amarendas/PhdThesis/Chapter4/ModelingAGV.tex

\chapter{Dynamics of Wheeled Mobile Robots }
\label{c4_Dynamics}
In the field of mobile robotics, extensive research has been carried out. 
Mobile robots can broadly be divided into three categorises, namely wheeled robots, legged robots ~\cite{machado2006overview}, and aerial vehicles ~\cite{valavanis2014handbook}. 
There are few mobile robots which use both wheels and legs for locomotion. For example,  Creadapt  \cite{mouret2015evolutionary} in order to take advantage of both modes of locomotion. 
Among these, the most extensively studied are the  Wheeled Mobile Robots (WMR). 
They have been classified into five generic classes by Champion et. al. \cite{campion1996structural},~\cite{campion2008wheeled}  based on their mobility resulting from the kinematic constrains due to  different wheel types.
 The most common among these are the  3 wheeled differentially driven WMR with one castor wheel.
  Because of its simplicity in modelling, they have been used in most of the  control and motion planing algorithms  \cite{desantis1995modeling}, \cite{koh1999smooth} and \cite{d1995control}. 

In order to develop a model-based control algorithm, it is imperative to have a good dynamic model of the WMR.
 These dynamic models are used in  simulation software,  Software in Loop (SIL) testing and Hardware in Loop (HIL) testing  of the controllers.
 Different methods have  been adopted to derive the dynamic model of WMRs.
  A general dynamical model was derived for three-wheel mobile robots with nonholonomic constraints  by B. d'Andrea-Novel \cite{d1991modelling} using  Lagrange formulation.
    Alternatively, Thanjavur and Rajagopalan \cite{thanjavur1997ease} have used Kane's method,  and  Saha et al. \cite{saha1991dynamics},\cite{saha1989kinematics} used Natural Orthogonal Compliment (NOC) method for the same.  
    
In this chapter we first present the kinematic model of the mobile robot with two passive wheel at the front. It is then proved using kinematics why a passive wheel with caster offset along the plane of the wheel self orients itself. While  casters with zero offset  must be actuated.  This has not been explicitly presented in literature.

 Next the dynamic equation of a mobile robot using Natural Orthogonal Compliment method is derived for both for ideal rolling condition of wheels and in presence of longitudinal and lateral slip of wheels. Use of NOC for modeling differential drive wheeled vehicle under ideal rolling condition has been presented by Angels and Saha \cite{saha1991dynamics}, \cite{saha1989kinematics}. We extend this method to include both the lateral and longitudinal slip of the wheels, and  derive the dynamic equations of motion of a mobile robot with redundant actuators. 
 
 The RARS robot has a unique  drive configuration, which uses both differential drive and Davis mechanism for steering. 
 This system has a redundant configuration and very few literature presents dynamical analysis with slip included in the dynamics. To our knowledge no literature is present, where the concept of  NOC  has been used to model redundantly actuated mobile robot. The two models are compared using simulation to find the deviation in the path traced by RARS robot under different peak value of co-efficient of friction between the wheel and ground plane.

\section{Modeling using the Natural Orthogonal Compliment (NOC)}
Let us consider a system with $n$ rigid bodies interconnected with different types of joints. 
Let, $f_i$ be the net force acting at the center of mass (CM) of the $i^{th}$  body and $n_i$ is the net moment.
 If $m_i$ is the mass, $I_{ci}$ is the  moment of inertia with respect to the CM, $c_i$ is the position vector of the CM and $\omega_i$ is the angular velocity of the same body with respect to an inertial coordinate system, then equations of motion of the $i^{th}$ rigid body are given by Newton-Euler equations as 
\begin{equation}
\label{NE}
f_i=m_i\ddot{c_i} \quad \text{and} \quad n_i=I_{ci} \dot \omega_i+\omega_i \times I_{ci} \omega_i
\end{equation}
Let us  define twist ($t$) and wrench($w$) as 
\begin{equation*}
t_i \equiv \begin{pmatrix}
\omega_i\\ \dot{c_i}
\end{pmatrix} \quad
w_i \equiv \begin{pmatrix}
n_i\\f_i
\end{pmatrix}
\end{equation*}
Note that the wrench $w_i$ acting on the $i^{th}$ body can be decomposed into $w^w_i$, called the \textit{working component} and  $w^c_i$, the \textit{non-working component}.
 The working component consists of all the external  moments and forces, which imparts/extracts energy to/from the system, e.g., motor actuating torque.
  The non-working component of the wrench consists of the moments and forces that are used to constrain the motion of the body at the joints.
Then, Newton-Euler equations (\ref{NE}) can be rewritten  in a single matrix equation as 
\begin{equation}
\label{2}
M_i\dot{t_i}+W_iM_it_i=w^w_i+w^c_i \quad \because w_i \equiv w^w_i+w^c_i
\end{equation}
where
\begin{equation}
\label{3}
M_i \equiv \begin{pmatrix}
I_{ci} & 0\\0 & m_i\tilde{1}
\end{pmatrix} ,
\quad W_i\equiv \begin{pmatrix}
\Omega_i &0\\0&0
\end{pmatrix},
\quad
\Omega_i\equiv \omega_i\times \tilde{1}
\end{equation}
in which  $\Omega_i$, is refered as the cross-product matrix of vector $\omega_i$ and $\tilde{1}$ denotes the identity matrix.For details, refer to \cite{angeles2013fundamentals},\cite{saha2010robotics}.If we define 
\[M \equiv diag[M_1,M_2,...M_n], \quad W \equiv diag[W_1,W_2,...W_n], \quad t \equiv [t_1^T,t_2^T, ....t_n^T]^T\] 
and 
\[ w^j \equiv [{w_1^j}^T,{w_2^j}^T, ....{w_n^j}^T]^T, \,j=c,w \]
then the equations of all the $n$ rigid bodies in the system can be collected and written as a single matrix equation 
\begin{equation}
\label{DCE}
M\dot{t}+WMt=w^c+w^w
\end{equation}
 The above equation is referred to as  decoupled equations of motion of the system.

The kinematic constraints, both holonomic and non-holonomic (e.g., pure rolling), between two bodies $i$ and $j$ of a system can be expressed as a linear homogeneous system of algebraic equations \cite{angeles2013fundamentals}, namely 
\begin{equation}
A_it_i+A_jt_j=0
\end{equation}
where $A_i,A_j$ depend on the kinematic parameters.

The constraint equations corresponding to all the joints in the system can be written in terms of the \textit{generalized twist vector} $t$.
\[At=0\]
 Furthermore, if $ \dot{\theta} \equiv[\dot{\theta_1},\dot{\theta_2},...\dot\theta_n]^T$ denote the \textit{independent generalized joint rates}. One can then write $t$ in terms of $\dot{\theta}$ as $t=T\dot{\theta}$. 
Using the fact, that $\dot{\theta}$ can take any arbitrary value, we get
\begin{equation}
\label{AT}
 AT\dot{\theta}=0\quad \Rightarrow AT=0
\end{equation}
The Equation \ref{AT} indicates that $T$ is the orthogonal complement of $A$.
 Since this relation arises naturally, hence the name \textit{Natural Orthogonal Complement}.  It can be shown \cite{angeles2013fundamentals} that the non-working wrench $w^c$ lies in the range space of $A^T$.   In view of Equation \ref{AT}, it can be proved that $w^c$ lies in the null space of $T^T$. Therefore,
\begin{equation}
T^Tw^c=0
\end{equation}
To eliminate the non-working  moments and  forces, i.e., $w^c$ from the uncoupled equation of motion (\ref{DCE}), we multiply both sides of the equation  by $T^T$. The result is dynamic equations of motion for interconnected n-body system.
\[T^TM\dot{t}+T^TWMt=T^Tw^W\]
 Substituting,  $t=T\dot{\theta}$ and $\dot{t}=\dot{T}\dot{\theta}+T\ddot{\theta}$  in  the above equation we get
\begin{equation}
 T^TMT\ddot{\theta}+T^T(M\dot{T}+WMT)\dot{\theta}=T^Tw^w
 \label{eqn:CEM}
\end{equation}
% This equation is expressed in terms of the independent generalized joint rates $\dot{\theta}$ and  $\ddot{\theta}$.
 or,
\begin{equation}
\label{CE}
 \quad I(\theta)\ddot{\theta}+C(\theta,\dot{\theta})\dot{\theta}=\tau
\end{equation}
where
\begin{align*}
I(\theta) &\equiv T^TMT\quad \quad:\text{generalized inertia matrix}\\
C(\theta,\dot{\theta})&\equiv T^T(M\dot{T}+WMT) \quad :\text{generalized  convective inertia matrix}\\
\tau&\equiv T^Tw^w \quad \quad :\text{ generalized vector of driving forces }
\end{align*}

Using the fact that $M$ and $W$ are diagonal matrices,  $I(\theta)$, $C(\theta,\dot{\theta}) $ and $\tau$ in Equation \ref{CE} can be written in terms individual bodies $M_i$, $W_i$ and $w_i^c$ as
\begin{equation}
	I(\theta)=\sum_{i=1..n}(T_i^TM_iT_i)
\end{equation}
\begin{equation}
C(\theta,\dot{\theta})=\sum_{i=1..n}(T_i^T M_i\dot{T_i}+T_i W_i M_i T_i)
\end{equation}
\begin{equation}
\tau=\sum_{i=1..n}T_i^T w^w_i
\end{equation}

\begin{figure}
	\begin{minipage}[t]{0.5\textwidth}
	\centering
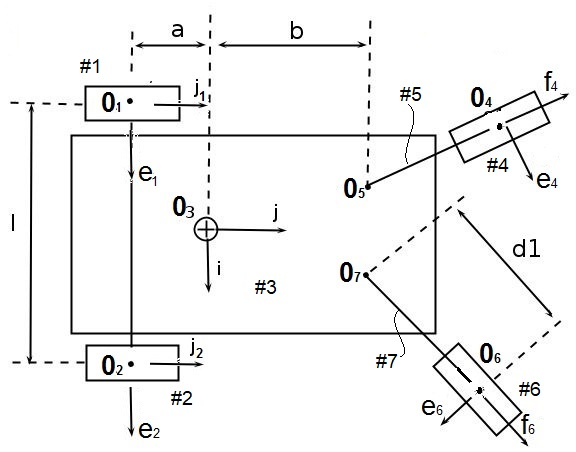
[picture p11: Chapter4/fig/fig1.jpg]
		 
		\caption{WMR-Std. caster}\label{fig:std}
	\end{minipage}
	\hfill
	\begin{minipage}[t]{0.5\textwidth}
	\centering
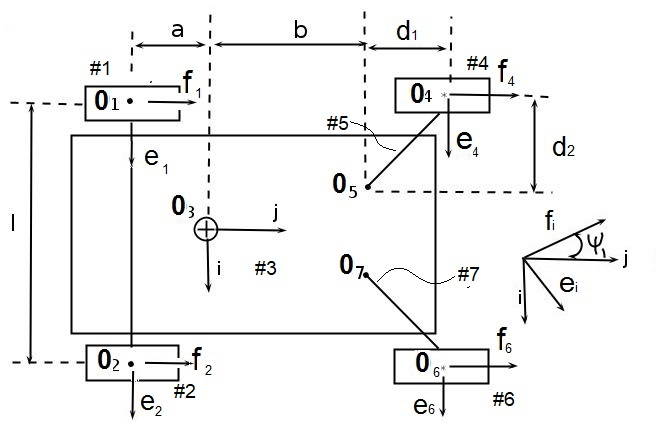
[picture p12: Chapter4/fig/fig2.jpg]
		 
		\caption{WMR-general}\label{fig:gen}
			\end{minipage}
%\caption{Castor wheel configuration of a WMR}
\end{figure}

\section{Dynamic Equation of WMR}
\label{sec:DynamicNoSlip}
The dynamic equation of a differentially driven 3 wheeled mobile robot based on the  Natural Orthogonal Compliment (NOC) has been presented by Saha~\cite{saha1991dynamics}. The vehicle consisted of 2 driven wheels and one standard caster wheel. In general, for large vehicles, it is necessary to have at least four wheels from the point of stability of the vehicle. Such a vehicle  is shown in Figure \ref{fig:std}. It may be noted that the caster wheels used in this case are the standard caster, where the angle between line $O_4O_5$ and vector $e_4$ is  $90^o$. Which is a special case of the more general configuration of the passive wheels shown in figure \ref{fig:gen}, where angle between line $O_4O_5$ and vector $e_4$ is not $90^o$

 The vehicle considered for analysis in this chapter is shown in Figure \ref{fig:gen}. It consists of two independently driven wheels at the back and two passive wheels at the front. The actuated wheels are labelled as body \#1 and \#2 as indicated in Figure \ref{fig:gen}. The platform is body \#3. The first caster wheel and its bracket is labelled as \#4 and \#5 respectively, with the castor pivoted at $O_5$. Similarly, the second castor is pivoted at $O_7$, and its bracket and wheel are labelled as \#6 an \#7, respectively, all the wheels are assumed to be rolling without slipping.  
 
 The RARS robot wheel configuration can be arrived from the generalized configuration of caster wheels presented above when $d_1=0$. Under this condition  and assuming that the steering mechanism always provides the correct steer angle, which is true in case of small curvature paths, the dynamic behaviour of the proposed robot will be similar to that  shown Figure  \ref{fig:gen}.
\subsection{Kinematic analysis}
In order to proceed with the kinematic analysis of the vehicle in Figure \ref{fig:gen}, we define an orthogonal triad of vectors ${i,j,k}$ at point $O_3$, the control point of the platform, as shown in Figure \ref{fig:gen}. If $\dot{\theta_1}$ and $\dot{\theta_2}$ {( positive when pointing along $i$)} denote the rates of rotation of wheels \#1 and \#2 then the linear velocity of points $O_1$ and $O_2$ under pure rolling condition is given by 
\begin{equation}
\label{velO1}
{\dot{o_i}}=-r\dot{\theta_i}j, \quad \text{r=radius of wheel}
\end{equation}
The angular velocity, $\omega_3$ of the platform  can be written in terms of the linear velocity of its two points $O_1$ and $O_2$  as 
\begin{equation}
\label{omegaPlat}
{\omega_3}=(r/l)(\dot{\theta_1}-\dot{\theta_2}){k}
\end{equation}
Further, the velocity of point $O_3$ can be written as
${\dot{o_3}=\dot{o_i}+\omega_3 \times (c-o_i)}, \quad i=1,2$, where $o_3 $ and $o_i$  is the position vector of points $O_3$ and $O_i$ respectively, with respect to some  point fixed to the ground. Eliminating $\omega_3$  one gets the following:

\begin{equation}
\label{velPlat}
 \quad \quad \dot{o_3}={(a r/l)(-\dot{\theta_1}+\dot{\theta_2})}i -(r/2)( \dot{\theta_1}+ \dot{\theta_2})j
\end{equation}
Now, the angular velocity of the drive wheel \#1 can be expressed as ${\omega_1}=-\dot{\theta_1}i+\omega_3k$. Using Equation \ref{omegaPlat}, the same can be rewritten as 

\begin{equation}
\label{omegaWheel1}
{\omega_1}=\begin{pmatrix}
-i+(r/l)k & -(r/l)k
\end{pmatrix}
\begin{pmatrix}
\dot{\theta_1}\\\dot{\theta_2}
\end{pmatrix}
\end{equation}
Similarly for the second wheel (\#2) we get
\begin{equation}
\label{omegaWheel2}
{\omega_1}=\begin{pmatrix}
(r/l)k & i-(r/l)k
\end{pmatrix}
\begin{pmatrix}
\dot{\theta_1}\\\dot{\theta_2}
\end{pmatrix}
\end{equation}
Based on  Equations \ref{velO1} and \ref{omegaWheel1}, the twist for wheel \#1 in terms of $\dot{\theta_a}\equiv (\dot{\theta_1},\dot{\theta_2})^T$, can be written as 
\begin{equation}
\label{twist1}
t_1=\begin{pmatrix}
\omega_1\\\dot{o_1}
\end{pmatrix}=
\begin{pmatrix}
i+(r/l)k & -(r/l)k\\- rj & 0
\end{pmatrix}
\begin{pmatrix}
\dot{\theta_1}\\\dot{\theta_2}
\end{pmatrix}
\end{equation}

Similarly, for the other actuated wheel \#2, one gets

\begin{equation}
\label{twist2}
t_2=\begin{pmatrix}
\omega_2\\\dot{o_2}
\end{pmatrix}=
		\begin{pmatrix}
		(r/l)k & i-(r/l)k\\
		  0 & -rj
		\end{pmatrix}
		\begin{pmatrix}
		\dot{\theta_1}\\\dot{\theta_2}
		\end{pmatrix}\\
		\end{equation}

To calculate the twist, $t_3$ of the platform body \#3, Equations \ref{omegaPlat} and \ref{velPlat} are combined to get
\begin{equation}
\label{twist3}
t_3=\begin{pmatrix}
\omega_3\\\dot{o_3}
\end{pmatrix}=
\begin{pmatrix}
\rho\delta & -\rho\delta\\
r(\lambda i+(1/2)j) & r(-\lambda i+(1/2)j)
\end{pmatrix}
\begin{pmatrix}
\dot{\theta_1}\\\dot{\theta_2}
\end{pmatrix}
\end{equation}
where
\[ \delta\equiv d/l, \quad \rho \equiv r/d, \quad \lambda \equiv a/l \]
From the above three equations, one gets 
\[T_1=\begin{pmatrix}i+(r/l)k & -(r/l)k\\ -rj & 0\end{pmatrix}, \quad  
T_2=\begin{pmatrix}	(r/l)k & i-(r/l)k\\  0 & -rj \end{pmatrix}\],
\[T_3=\begin{pmatrix}
	\rho\delta & -\rho\delta\\
	r(\lambda i+(1/2))j & r(-\lambda i+(1/2))j
	\end{pmatrix}\]

In order to calculate the twists of the caster bracket and the caster wheel, it is necessary to express the  un-actuated joint rates, $\dot{\psi_1}$ and $\dot{\phi_1}$, in terms of the actuated joint rate vector $\dot{\theta_a}$. Note here that $\dot{\psi_1}$ denotes the rate of rotation of the bracket body (\#5) about $O_5$ with respect to the platform, and $\dot{\phi_1}$ is the rate of rotation of caster wheel body (\#4) about its axis $e_4$ with respect to the bracket.
\begin{equation*}
\omega_5=\dot{\psi_1}k+\omega_3, \quad \quad \omega_4=\dot{\phi_1} e_4 +\omega_5
\end{equation*}
Assuming that there is pure rolling constraint between the wheel and the ground, the velocity of the point $O_4$ can be written in terms of $\phi_1$ as \[\dot{\phi_1} r = \dot{o_4} \]

 The velocity of $O_5$ can now be expressed in two independent forms, namely, one in terms of the velocity of $O_3$ and the other one in terms of the velocity of $O_4$, i.e.,
\begin{equation}
\dot{o_5}=\dot{o_4}+\omega_5\times(d_2e_4-d_1f_4), \quad
\dot{o_5}=\dot{o_3}+\omega_3\times(b j - m i)
\end{equation}
On equating the above two equations together, and using the rotation matrix (R) between coordinate system $\{i,j,k\}$ and $\{e_4,f_4,k\}$ given Equation \ref{eqn:RotMatrix}, 

\begin{equation}
\label{eqn:RotMatrix}
R=\begin{pmatrix}
\cos(\psi_1) & -\sin(\psi_1) \\
\sin(\psi_1) & \cos(\psi_1)
\end{pmatrix}
\end{equation}
 the equation in terms $e_4$ and $f_4$, is obtained as

\begin{equation}
(-\dot{\phi_1}r+\dot{\psi_1}d_1)f_3+d_3\dot{\psi_1}e_3=\dot{o_3}
+\omega_3(m\cos\psi_1-b\sin\psi_1-d_1)e_4
\end{equation} 
Taking the dot product of the above equation first with $e_4$ and then with $f_4$, and using Equation \ref{velPlat} for $\dot{o_3}$, one gets
\begin{eqnarray}
\label{unac2act1}
\begin{pmatrix}
d_2&0\\-d_1 &r
\end{pmatrix}
\begin{pmatrix}
\dot{\psi_1}\\ \dot{\phi_1}
\end{pmatrix}
&=&\begin{pmatrix}
(-ar/l)S_{\psi_1}+(r/2)C_{\psi_1}+\delta_1 & 
(ar/l)S_{\psi_1}+(r/2)C_{\psi_1}-\delta_1 \\
(ar/l)C_{\psi_1}+(r/2)S_{\psi_1}+\delta_2 & 
(-ar/l)C_{\psi_1}+(r/2)S_{\psi_1}-\delta_2 
\end{pmatrix}\dot{\theta_a}\nonumber \\
&=&[F_{ij}]\dot{\theta_a}
\end{eqnarray}
where, 
\[ \delta_1=(r/l)(mC_{\psi_1}-bS_{\psi_1}-d2), \quad  \delta_2=(r/l)(mS_{\psi_1}+bC_{\psi_1}+d_1) \]

Similarly, for the other caster wheel one gets,
\begin{align}
\label{unac2act2}
\begin{pmatrix}
d_2&0\\-d_1 &r
\end{pmatrix}
\begin{pmatrix}
\dot{\psi_2}\\ \dot{\phi_2}
\end{pmatrix}
&=\begin{pmatrix}
(-ar/l)S_{\psi_2}+(r/2)C_{\psi_2}-\delta_3 & 
(ar/l)S_{\psi_2}+(r/2)C_{\psi_2}+\delta_3 \\
(ar/l)C_{\psi_2}+(r/2)S_{\psi_2}+\delta_4 & 
(-ar/l)C_{\psi_2}+(r/2)S_{\psi_2}-\delta_4 
\end{pmatrix}\dot{\theta_a}\nonumber \\
&=[G_{ij}]\dot{\theta_a}
\end{align}
where, 
\[ \delta_3=(r/l)(mC_{\psi_2}+bS_{\psi_2}+d2), \quad  \delta_4=(r/l)(mS_{\psi_2}+bC_{\psi_2}+d1 )\]

 The angular and the linear velocity of the CM of the caster wheel  \#4, is  written in terms of the co-ordinate frame fixed to the bracket \#5, i.e. $\{e_4,f_4,k\}$, as
\begin{equation}
\label{omegacastor1}
\omega_4=\dot{\phi_1}e_4+(\omega_3+\dot{\psi_1})k, \quad
\dot{o_4}=\dot{\phi_1}e_4
\end{equation}
Using Equations \ref{unac2act1} and \ref{omegaPlat}, the twist $t_4$ can be written as
\begin{equation}
\label{twist4}
t_4=\begin{pmatrix}
\Theta_4\\C_4
\end{pmatrix}\dot{\theta_a}
\end{equation}
Using the definition of $F(i,j)$ in  Equation \ref{unac2act1}, $\Theta_4$ and $C_4$ can be written as 
\[ \Theta_4=[F_{11}e_4+\bar{F_{21}}k \quad F_{12}e_4+\bar{F_{22}}k],\quad 
C_4=r[-F_{11}f_4 \quad -F_{12}f_4]\]
\[\bar{F_{21}}=F_{21}+\rho \delta, \quad \bar{F_{22}}=F_{22}-\rho\delta\]

The angular and the linear velocity of the CM of the caster bracket \#5  expressed in the co-ordinate frame fixed to the bracket is given as
\begin{equation}
\omega_5=\omega_3+\dot{\psi_1}k, \quad
\dot{o_5}=\dot{o_4}+\omega_5\times(d_2e_4-d_1f_4)
\end{equation}
Using Equations   \ref{omegaPlat} and \ref{unac2act2}, the twist $t_5$ can next  be expressed as
\begin{equation}
\label{twist5}
t_5=\begin{pmatrix}
\Theta_5\\C_5
\end{pmatrix}\dot{\theta_a}
\end{equation}
where
\[ \Theta_5 \equiv [\bar{F_{21}}k \quad \bar{F_{22}}k],\quad 
C_5\equiv d[(1/2)\bar{F_{21}}e_4-\rho F_{11}f_4 \quad (1/2)\bar{F_{22}}e_4-\rho F_{12}f_4]\]
In a similar manner, the twists $t_6$ and $t_7$  of the other caster wheel and its bracket, respectively can be written as 
\begin{equation}
\label{twist6}
t_6=\begin{pmatrix}
\Theta_6\\C_6
\end{pmatrix}\dot{\theta_a}, \quad t_7=\begin{pmatrix}
\Theta_7\\C_7
\end{pmatrix}\dot{\theta_a}
\end{equation}
Using  $G(i,j)$ defined in  Equation \ref{unac2act2}, $\Theta_6$, $C_6, \Theta_7$ and $C_7$ are given by
\[ \Theta_6 \equiv [G_{11}e_6+\bar{G_{21}}k \quad G_{12}e_6+\bar{G_{22}}k],\quad 
C_6 \equiv r[-G_{11}f_6 \quad -G_{12}f_6]\]
\[ \Theta_7 \equiv [\bar{G_{21}}k \quad \bar{G_{22}}k],\quad 
C_7 \equiv d[(1/2)\bar{G_{21}}e_6-\rho G_{11}f_6 \quad (1/2)\bar{G_{22}}e_6-\rho G_{12}f_6]\]
\[\bar{G_{21}} \equiv G_{21}+\rho \delta, \quad \bar{G_{22}}\equiv G_{22}-\rho\delta\] 
\subsection{Special cases}
Based on the above kinematic equations \ref{unac2act1} and \ref{unac2act2} for the caster wheels two special cases can be recognized one with $d_1=0$ and another ($d_2=0$). The RARS mobile robot designed fall in the second category and hence it requires a steering actuator as discussed below.  
\subsubsection{Standard caster ($d_1=0$) }
The  standard caster wheel configuration can be obtained by setting the value of $d_1=0$. In such condition, the left hand side matrix of  Equations \ref{unac2act1} and \ref{unac2act2} become  a diagonal matrix. Therefore, the first and second row of Equations \ref{unac2act1} and \ref{unac2act2} get divided by $d_2$ and $r$, respectively. The resulting  equations relating the un-actuated joint rate to  actuated joint rates are similar to those reported by \cite{saha1991dynamics},\cite{angeles2013fundamentals}. These passive wheel are self orienting. Hence there is no need for steering motors. 
\subsubsection{Under-actuated case ($d_2=0$)}
It can be seen from Equation \ref{unac2act1} that when the \textit{caster offset}, $d_2=0$, the LHS matrix becomes singular. So the unactuated joint rates cannot be determined from $\dot{\theta_a}$. It is therefore essential to have proper caster offset in case we need caster like behaviour from a passive wheel. 

An alternative solution is to put an extra actuator to control the bracket motion i.e., $\dot\psi_i$. This is the case in Ackerman and Davis steering mechanism, where the steering wheel controls the orientation of the front passive wheels of a car.
\section{Dynamics with No Wheel Slip }
In this section the equations of motion is derived under the assumption that all the wheel satisfies pure rolling condition, there is no slipping or skidding of the wheels. This is valid for vehicles with caster wheels as mentioned in Section 3.2.2.1 or incase where steered wheels are perfectly aligned according to the Ackerman steering condition. Dynamics of such architecture is simple which will lead to a realistic model of RARS developed in this research. This is effectively the case mentioned in Section 3.2.2.2. 

Based on the twists calculated in terms of the independent joint rate vector vector $\dot{\theta_a}$,  the generalized inertia matrix and the matrix of convective inertia term for the coupled equation of motion given by Equation \ref{CE} can be derived. 
\subsection{Generalized inertia matrix, I}
\label{sec:GIM}
 The equations gives in Section 4.2.1 of the twist of individual body, i.e $t_i=T_i\dot{\theta_a}$ are used to obtain   $t=[t_1^T, t_2^T....t_7^T]^T$ and $t=T\dot\theta$ where  $T=[T_1^T, T_2^T,... T_7^T]^T$. Since the matrix $M$ is block diagonal, the inertia matrix of the full system  denoted by $I$ is given by
\begin{equation}
I=T^TMT=T_1^TM_1T_1+T_2^TM_2T_2+...T_7^TM_7T_7
\end{equation}
The contribution of the rear wheels  to the inertia matrix, i.e., $I_m$ is given by  \[ I_m=\sum_{i=1,2}T_i^TM_iT_i\] or
\begin{equation}
\label{eqn:I_wheel}
I_m=\begin{pmatrix}
I_w+(\rho\delta)^2H++m_wr^2 & -2(\rho\delta)^2H
\\
-2(\rho\delta)^2H &I+(\rho\delta)^2H++m_wr^2
\end{pmatrix} 
\end{equation}
where 
\begin{equation}
\label{eqn:wheelInertiaMatrix}
M_i \equiv\begin{pmatrix}
\tilde{I_w} &0\\0 & m_w\mathbf{1}
\end{pmatrix} , \quad\tilde{I_w}\equiv\begin{pmatrix}
I_w&0&0\\0&H&\\0&0&H
\end{pmatrix}
\end{equation} 

Matrix $\tilde{I_w}$ is the $3\times 3$ moment of inertia matrix of the wheel in co-ordinate frame $\{i,j,k\}$, $m_w$ is mass of the motorized wheels    and $\bm{1}$ is the $3\times 3$ identity matrix. If the mass of the platform is $m_p$ and its moment of inertia about vector ${k}$ is $I_p$, then  \cite{angeles2013fundamentals} 
\begin{equation}
\label{eqn:I_platform}
I_3=T^T_3M_3T_3 =I_p(\rho\delta)^2\begin{pmatrix}
1&-1\\-1&1 \end{pmatrix}\\
+m_pr^2\begin{pmatrix}
(1/4)+\gamma^2 & (1/4)-\gamma^2\\(1/4)-\gamma^2 & (1/4)+\gamma^2
\end{pmatrix}
\end{equation}
Similarly, if $m_c$ is the mass of the castor wheel and it is assumed to be a solid disk, then the generalized inertia matrix  can be written as
\begin{align}
I_c=\sum_{i=4,6}T^T_iM_iT_i=(m_cr^2/4)&
\begin{pmatrix}
6F_{11}^2+\bar{F_{21}}^2 & 6F_{11}F_{12}+\bar{F_{21}}\bar{F_{22}}\\
6F_{11}F_{12}+\bar{F_{21}}\bar{F_{22}} & 6F_{12}^2\bar{F_22}
\end{pmatrix}\\ \nonumber
&+\begin{pmatrix}
6G_{11}^2+\bar{G_{21}}^2 & 6G_{11}G_{12}+\bar{G_{21}}\bar{G_{22}}\\
6G_{11}G_{12}+\bar{G_{21}}\bar{G_{22}} & 6G_{12}^2\bar{G_22}
\end{pmatrix}
\end{align}
If the mass of the brackets, i.e., body \#5 and \#7, are small compared to the mass of the caster wheels, then the contributions of $T^T_5M_5T_5$ and $T^T_7M_7T_7$ can be neglected.

\subsection{Matrix of convective inertia term C}
The matrix of convective inertia terms of Equation \ref{CE} can be broken down into two parts, $T^TM\dot{T}$ and $T^TWMT$.  As can be seen from Equations \ref{twist1}, \ref{twist2} and \ref{twist3},  $T_1,T_2,T_3$ associated with rear wheels and the platform is constant. Therefore \[T^TM\dot{T}=0\]
 The generalized inertia matrix  is constant for the rear wheels and the platform, therefore the vector $I_i\omega_i$ is parallel to  $\omega_i, i=1..3$ \[\Rightarrow\omega\times I\omega=0\] \[\Rightarrow T^TWMT =0\]
  This shows that contribution of the rear wheels and the platform  to the convective inertia term is zero. Moreover, the mass of the brackets are assumed to be zero, so they also do not contribute to the convective inertia term. Hence
\begin{equation}
\label{Convective}
C=T^TM\dot{T}+T^TWMT=\sum_{i=4,6}T^T_iM_i\dot{T_i}+\sum_{i=4,6}T_i^TW_iM_iT_i
\end{equation}
The expression for the first term is found by using Equations \ref{unac2act1}, \ref{unac2act2}, \ref{twist4} and \ref{twist6}. The terms $\dot{F_{ij}}$ and $\dot{G_{ij}}$ denote the derivatives of the elements of the matrix $F$ and $G$ defined in Equations \ref{unac2act1} and \ref{unac2act2} . To find $\dot{T_4}$ and  $ \dot{T_6}$ we have used the fact $\dot{e_4}=\omega_4 \times e_4 $ and $\dot{e_4}=\omega_6 \times e_6 $. 
\begin{equation}
\label{corr1}
\begin{split}
T^TM\dot{T}=
(m_cr^2/4)& \biggl[ \begin{pmatrix}
6F_{11}\dot{F_{11}}+\bar{F_{21}}\dot{F_{21}} & 6F_{11}\dot{F_{12}}+\bar{F_{21}}\dot{F_{22}}\\
6\dot{F_{11}}F_{12}+\dot{F_{21}}\bar{F_{22}} & 6F_{12}^2\bar{F_{22}}
\end{pmatrix}\\
&+\begin{pmatrix}
6G_{11}\dot{G_{11}}+\bar{G_{21}}\dot{G_{21}} & 6G_{11}\dot{G_{12}}+\bar{G_{21}}\dot{G_{22}}\\
6\dot{G_{11}}G_{12}+\dot{G_{21}}\bar{G_{22}} & 6G_{12}^2\bar{G_{22}}
\end{pmatrix} \biggr]
\end{split}
\end{equation}
\\
The second term of Equation \ref{Convective} i.e, $ \sum_{i=4,6}T_i^TW_iM_iT_i$ evaluates to zero, as shown below. 

Next, consider passive wheel (\#4), using Equation \ref{twist4} and  $W$ defined in the Equation \ref{3} one gets,
\begin{equation}
\label{corr2}
T^T_4W_4M_4T_4=[\Theta_4, C_4]\begin{pmatrix}
\Omega_4 &0\\0&0
\end{pmatrix}
\begin{pmatrix}
I_4&0\\0 &m_4 \mathbf{1}
\end{pmatrix}
\begin{pmatrix}
\Theta_4\\C_4
\end{pmatrix}=\Theta_4\Omega_4I_4\Theta_4
\end{equation}

To evaluate the above equation, we express  all the terms in the coordinate system $\{{e_4,f_4,k}\}$. Moreover, $\omega_4=\Theta_4 \dot{\theta_a}$, using definition of $\Theta_4$ from Equation \ref{twist4} we get \[\omega_4= (F_{11}\dot{\theta_1}+F_{12}\dot{\theta_2})e_4+(F_{21}\dot{\theta_1}+F_{22}\dot{\theta_2})k\] and the cross product matrix of $\omega_4$ as 
\[
 \Omega_4 \equiv \begin{pmatrix}
 0& -(\bar{F_{21}}\dot{\theta_1}+\bar{F_{22}}\dot{\theta_2}) &0\\
 (\bar{F_{21}}\dot{\theta_1}+\bar{F_{22}}\dot{\theta_2}) & 0 & -(F_{11}\dot{\theta_1}+F_{12}\dot{\theta_2}) \\
 0& (F_{11}\dot{\theta_1}+F_{12}\dot{\theta_2}) &0 
 \end{pmatrix}
\]
When the above expressions are substituted in Equation  \ref{corr2}, we get
\begin{equation}
T^T_4W_4M_4T_4=0, \quad \Rightarrow T^TWMT=0
\end{equation} 
Therefore, the matrix of convective inertia term $C$ of Equation \ref{CE}  evaluates to 

\begin{equation}
\label{C_final}
\begin{split}
C=
(m_cr^2/4)& \biggl[ \begin{pmatrix}
6F_{11}\dot{F_{11}}+\bar{F_{21}}\dot{F_{21}} & 6F_{11}\dot{F_{12}}+\bar{F_{21}}\dot{F_{22}}\\
6\dot{F_{11}}F_{12}+\dot{F_{21}}\bar{F_{22}} & 6F_{12}^2\bar{F_{22}}
\end{pmatrix}\\
&+\begin{pmatrix}
6G_{11}\dot{G_{11}}+\bar{G_{21}}\dot{G_{21}} & 6G_{11}\dot{G_{12}}+\bar{G_{21}}\dot{G_{22}}\\
6\dot{G_{11}}G_{12}+\dot{G_{21}}\bar{G_{22}} & 6G_{12}^2\bar{G_{22}}
\end{pmatrix} \biggr]
\end{split}
\end{equation}

All the components of  Equation  \ref{CE}  are now been evaluated, except the $\tau$. These are simply the torques exerted by the actuated wheels. This completes the dynamic model of the WMR with generalized passive wheel configuration.

\subsection{Simulation }
\label{sec: SimulationIdealCondition}
The mobile manipulator proposed in Chapter 3  was modelled as a differentially driven robot. The front wheels and steering mechanism were not included in the dynamic model as their masses are too small compared to the  platform. The weight of each wheel is 0.3Kg, the steering mechanism 0.24Kg, whereas the weight of the  platform is 70Kg.

In  simulation the vehicle reference  point $O_3$ is required to trace a circle of radius 5m with centre at $O$. As shown in the Figure \ref{fig:CirTrace}. Let, $ \beta$ be the angle between the line joining  point $O_3$ and $O$ with respect to $X-axis$. The function $\beta(t)$ was defined such that the full circle is completed in 60Sec and the velocity and acceleration of the robot is zero at the beginning (t=0) and end of travel (t=60).
\begin{equation}
\label{path}
\beta(t)=\frac{20\pi}{60^3}t^3-\frac{30\pi}{60^4}t^4+\frac{12\pi}{60^5}t^5
\end{equation}
The initial pose of the vehicle is parallel to the $Y-axis$ i.e. $\beta=0$  as shown  by dotted line in Figure \ref{fig:CirTrace}.

\begin{figure}[H]
	\centering
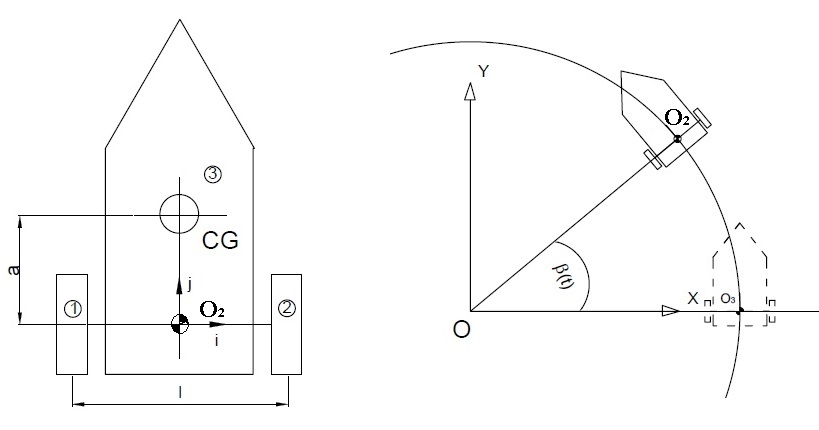
[picture p13: Chapter4/fig/pathCircle2.jpg]
		
		\caption{Path traced by robot}
	\label{fig:CirTrace}
\end{figure}

\subsection{Inverse dynamics}
\label{sec:InvDynamics_NoSlip}
Inverse dynamics was carried out to find the torque required on each rear wheel, when the point $O_2$ of the mobile robot traces a circular 
curve given in Figure \ref{fig:CirTrace}.
Using the model's inverse kinematic,  the wheel velocity and acceleration were determined using pseudo inverse.  % from the equation given below. Where $r$ is radius of the wheel and $\theta_i$ is the wheel roll angle of wheel \#1 and \#2. The platform angular velocity is $\omega$ and the Cartesian velocity of point o3 is given by $\dot{x},\dot{y}$ in body coordinate system %   
The wheel angle, velocity and acceleration were used in the dynamics equation \ref{dnoc}  to calculate the torque required by each motor. The results are plotted in Figure \ref{fig:spiral}. 

The equation of  dynamic model  is given in Equation \ref{dnoc}, where the actuated joints are  $\theta_a(t)=(\theta_l, \theta_r) $, the rear left and right wheel rotation angles. The dynamic  and kinematic  parameters used in the simulation is listed in table \ref{tb:massproperty}. The rear wheels $(i=1,2)$ and the platform $i=3$, twist $t_i^T=T_i\theta_a$, is given by Equations \ref{twist1}, \ref{twist2} and \ref{twist3}. The dynamic equation  of the mobile robot platform  on slope is given as 
\begin{equation}
\label{dnoc}
\begin{aligned}
T^TMT\ddot{\theta_a}&=-T^T(M\dot{T}+WMT)\dot{\theta_a}+T^T(w^J+w^G)\\
\text{where} \quad &
T=(T_1^T T_2^T T_3^T)^T, \quad M=diag(M_1, M_2, M_3)\\
T^TMT &=I_1+I_2+I_m+I_3= I_m+I_3\\
W&=diag(W_1,W_2,W_3),\quad w^G=g\sin\alpha, \quad \alpha=10^o
\end{aligned}
\end{equation}
where $w^G$, $ w^J$ and $\alpha$ represent the gravitational force acting along the inclined plane,  the external torque applied by a motor and the inclination of the plane to horizontal respectively. The generalized inertia matrix $I_m$ and $I_3$ are given in Equation \ref{eqn:I_wheel} and \ref{eqn:I_platform}.
As stated earlier the convective inertia term is zeros as the inertia matrices are constant. The expression for motor torque  is then given as 
\begin{equation}
T1^Tw_1^j=\tau_1, \quad T_2^Tw_2^j=\tau_2
\end{equation}
\begin{equation}
 T_3^Tw^g=\begin{pmatrix}
\rho\delta k & r(\lambda i+(1/2)j) \\
 -\rho\delta k & r(-\lambda i+(1/2)j)
\end{pmatrix}
\begin{pmatrix}
0\\
-jg\sin\alpha
\end{pmatrix}=\begin{pmatrix}
-\frac{1}{2}rg\sin\alpha\\ -\frac{1}{2}rg\sin\alpha
\end{pmatrix}
\end{equation} 

Figure \ref{fig:spiral} presents the torques required at the wheels of the vehicle while move up a spiral ramp  of slope $10^o$ and radius 5m. 

 \begin{figure}
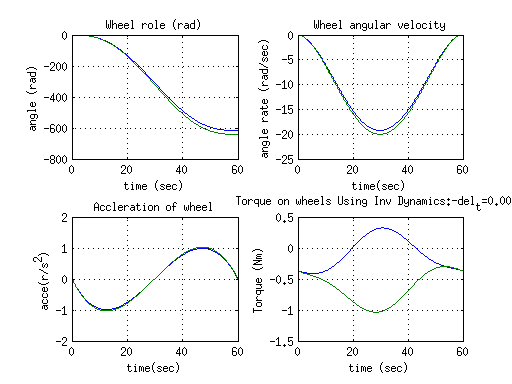
[picture p14: Chapter4/fig/FD.png]
	
	\captionof{figure}{Inverse dynamics of the mobile robot }
	\label{fig:spiral} 
\end{figure} 
%
\begin{table}[!htbp]
	\caption{Dynamic and kinematic parameters }
	\label{tb:massproperty}
	\centering
	\begin{tabular}{l l l}
		\hline
		\emph{Part Name}  & \emph{ Property} & \emph{Value} \\
		\hline
		Rear Wheels & & \\
		 $m_1,m_2$	& mass				&300g \\ 
		  $I_1,I_2$	& Moment of Inertia	& diag(242, 242, 465)kg $mm^2$\\
		Base Frame& & \\
		 $m_3$ & mass  & 70Kg \\
		 $ I_3$& Moment Of Inertia & $ \begin{pmatrix}
		 1.18& 0.01&-0.05\\ 0.01 & 1.28 & 0.08\\
		 -0.05 & 0.08 & 0.53
		 \end{pmatrix} Kg-m^2$ \\
		   l & length & 400mm\\
		  r & wheel radius (r) & 50mm\\
		 a & see Figure \ref{fig:CirTrace} & 220 mm \\ 
		\hline
		\end{tabular}
\end{table}

\section{Dynamics with Wheel Slip}
\begin{figure}
		\begin{minipage}[t]{0.5\textwidth}
		\centering
		 
		\caption{Longitudinal slip \cite{wang2008modeling}}\label{fig:slip}
	\end{minipage}
	\hfill
	\begin{minipage}[t]{0.5\textwidth}
		\centering
		 
		\caption{Wheel skid \cite{wang2008modeling}}\label{fig:skid}
	\end{minipage}
\end{figure}
The above section presented  the equations of motion  of a mobile robot  based on the no slip condition between the ground and the wheel, i.e. pure rolling condition. For RARS robot presented in this thesis the front steering wheels  are passive  but actively steered. Hence, the assumption of pure rolling condition of these wheels are no longer valid. Therefore, both the longitudinal slip and lateral slip (also called skid) are introduced in derive the equations of motion for RARS.
\subsection{Defining Slip}
\textbf{Longitudinal slip} occurs when the peripheral velocity of the wheel at the point of contact with respect to the ground, $\dot{\phi} r$ is different from the linear velocity $v_l$ of the wheel C.G., as shown in Figure \ref{fig:slip}, where, $\dot{\phi}$ is the angular rate of the wheel and $r$ is the effective radius of the wheel. Under pure rolling assumption  $\dot{\phi}  r=v_l$. However, this is not the case for a deformed wheel. The wheel slipping can be characterized by
slippage (or Slip ratio) \[\rho = \frac{\dot{\phi}  r - v_l}{\max(\dot{\phi}  r,v_l)}\] that has a  range of $ \rho \in [-1, 1]$. The case $\rho = 0$ indicates no wheel slippage whereas $\rho = 1$ implies a complete slippage, i.e., the wheel is not moving linearly despite its angular rotation. In normal road condition, the wheel's slippage $(\rho)$is usually in the range, $-1<\rho<1 $.
 The  longitudinal force ($F_s$) acting on the wheel due to slip is related to the slip ratio $\rho$. There are several adhesions models proposed that gives relation between the slip ratio and friction force at wheel-ground interface. One of the well known adhesion relations is the \textit{ magic formula} presented by Pacejka \cite{pacejka1992magic} which is used extensively in automotive industry to modeling tire forces. Other  friction models proposed in  literature  are by Claeys \cite{claeys2001dynamic}, Kulakowski \cite{kulakowski1991mathematical}  and Dugoff \cite{dugoff1970analysis}. 
 
 \textbf{Lateral slip }also called \textbf{skidding} is experienced when the wheel moves perpendicular to its plane. This is general encountered during cornering. This lateral movement is called skidding. The skidding produces frictional force perpendicular to the wheel plane as shown in Figure \ref{fig:skid} by $F_k$. The force $F_k$ is related to the slip angle $\delta$, which is the angle formed between the wheel plane and the velocity vector of the wheel, when projected on the ground plane.
 The force $F_k$ can again be found using magic formula \cite{pacejka1992magic} given in Equation \ref{eqn:magic} or any other adhesion model. Where instead of the slip ratio we use the slip angle as the independent parameter.
 
 %The magic formula \ref{eqn:magic} is reproduced below for completeness. In case of longitudinal slip $Y(x)$ represents longitudinal force $F_s$ and $x$ is the slip ratio $\rho$. For computation the lateral frictional  force $(F_k)$ due to skidding $x$ is replaced by the slip angle $\delta$. The constants $D$ represents the peak frictional force. The angle of  tangent at the origin is equal to $BCD$. $C$ controls the shape of the curve, $C=2.4$ for $F_k$ and  $C=1.65$ for $F_s$. $B$ controls the slope at origin. The remaining constant $E$ influences both the curvature of the curve near peak and also the position of $x_m$, where the peak is located.
 
 \begin{equation}\label{eqn:magic}
 Y(x)=D\sin[C \arctan{Bx -E(Bx-\arctan(bx))}]
 \end{equation}
%\begin{figure}
%	\centering
%	\includegraphics{Chapter3/fig/magicformula}
%	\caption{Tipical Curve of Magic Formula \cite{pacejka1992magic}}
%	\label{fig:magicformula}
%\end{figure}

\subsection{Kinematics with wheel slip}
\label{sec:slipKina}
 Figure \ref{fig:VehicleWithSlip}  shows the line digram of the RARS robot. Even though the actual RARS robot uses Davis linkage for steering the front wheels, here let us consider the steer angles $\psi_1$, $\psi_2$ corresponding to  each wheel. This makes the mathematical  modelling  more general. In order to simplify the model  link connecting the front wheels to the platform, tie rod, etc. associated with the steering mechanism   are excluded from the analysis, as their weights are small compared to the platform and wheels. The steering axis is assumed to pass through the center of the front wheel, i.e.,  the offset is zero.  It means $d_1=d_2=0$  ( Figure \ref{fig:gen}). Thus, $O_4=O_5$ and $O_6=O_7$. In Figure \ref{fig:VehicleWithSlip}  $O_4$  for wheel \#4 and $O_5$ for wheel \#5, denotes both the centre of the wheel and also the steering pivot point. The NoC approach was used to derive the equations of motion of the RARS robot with wheel slip taken into account for all the four wheels.
\begin{figure}
	\centering
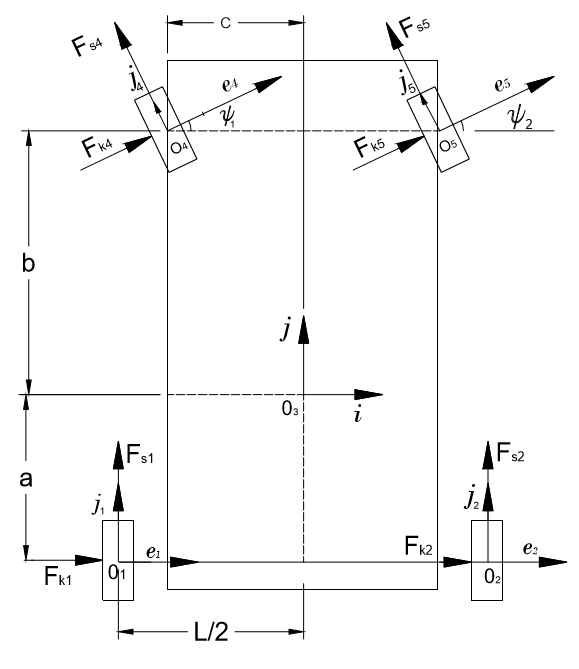
[picture p15: Chapter4/fig/VechileWithSlip.png]
	
	\caption{Free body diagram of RARS robot}
	\label{fig:VehicleWithSlip}
\end{figure}

The set of independent variables for this model is given by
\begin{equation}
\label{eqn:theta_slip}
\dot{\theta}=(\dot{\theta_1},\dot{\theta_2}, \dot{y_1},\dot{y_2},\dot{x},\dot{\psi_1},\dot{\psi_2},\dot{\theta_4},\dot{\theta_5})^T
\end{equation}
It may be noted that $\theta_i,\psi_i$  is same as defined earlier in Section \ref{sec:DynamicNoSlip}. The variables $\dot{y_1},\dot{y_2}$ are the linear velocity of centre of the rear wheels, i.e., of points point $O_1$ and $O_2$,, in the direction $j$ of the body coordinate system. The lateral slip of the rear wheels are denoted by $x_1$ and $x_2$ as shown in the Figure \ref{fig:VehicleWithSlip}. Due to rigidity constrains of the rear wheels there are related as follows
\[\dot{x_1}=\dot{x_2}=\dot{x}\] 
The velocities of points $O_1$ and $ O_2$ w.r.t the world coordinate ${X,Y,Z}$ and expressed in the robot's body co-ordinate system ${i,j,k}$ are given by 
\begin{equation}
\label{eqn:slip_do1}
\dot{o_1}=\dot{x}i +\dot{y_1}j, \quad \quad  \dot{o_2}=\dot{x}i +\dot{y_2}j
\end{equation}
Equating the velocity of point $O_3$ expressed in terms of $\dot o_1$ and $\dot o_2$, one gets
\begin{equation}
\label{eqn:slip_do3_rel}
\dot{o_3}=\dot{o_1}+\omega_3\times o_1o_3=\dot{o_2}+\omega_3\times o_2o_3
\end{equation}
Let $\omega_3$ be the angular velocity of platform, i.e., body \#3. Then 
\begin{equation}
	\label{eqn:slip_domega3}
	\omega_3=\bar{\omega_3}k, \quad \bar{\omega_3}=\frac{\dot{y_2}-\dot{y_1}}{l} 
\end{equation}
Using Equations \ref{eqn:slip_do3_rel} and \ref{eqn:slip_domega3} , we get
\begin{equation}
\label{eqn:slip_do3}
\dot{o_3}=(\dot{x}+\frac{a\dot{y_1}}{l}-\frac{a \dot{y_2}}{l})i+(\frac{\dot{y_1}}{2}+\frac{\dot{y_2}}{2})j
\end{equation}
The twist $t_3$ for body \#3 is obtained as
\begin{equation}
\label{eqn:slip_t3}
t_3=
\begin{pmatrix}
\omega_3\\
\dot{o_3}
\end{pmatrix}=T_3 \dot{\theta}, \quad \text{where,} \quad 
T_3=
\begin{pmatrix}
0 & 0& -k/l & k/l & 0 &0 & 0 &0 &0\\
0 & 0& ai/l+ j/2& -ai/l+j/2 & 0 &0 & 0 &0 &0\\ 
\end{pmatrix}
\end{equation}
or in expanded form
\begin{equation}
\label{eqn:slip_T3}
T_3=\left(
\begin{array}{ccccccccc}
0 & 0 & 0 & 0 & 0 & 0 & 0 & 0 & 0 \\
0 & 0 & 0 & 0 & 0 & 0 & 0 & 0 & 0 \\
0 & 0 & -\frac{1}{l} & \frac{1}{l} & 0 & 0 & 0 & 0 & 0 \\
0 & 0 & \frac{a}{l} & -\frac{a}{l} & 1 & 0 & 0 & 0 & 0 \\
0 & 0 & \frac{1}{2} & \frac{1}{2} & 0 & 0 & 0 & 0 & 0 \\
0 & 0 & 0 & 0 & 0 & 0 & 0 & 0 & 0
\end{array}
\right)
\end{equation}
Using the fact \[\frac{d i}{dt}=\bar{\omega_3}k\times i =\bar{\omega_3}j, \quad  \frac{d j}{dt}=\bar{\omega_3}k\times j =-\bar{\omega_3}i, \frac{d k}{dt}=\bar{\omega_3}k\times k =0 \] 
\begin{equation}
\label{eqn:slip_dT3}
\dot{T_3}=\begin{pmatrix}
0 & 0& 0 & 0 & 0 &0 & 0 &0 &0\\
0 & 0&-\frac{ \bar{\omega_3}}{2}i +\frac{a \bar{\omega_3}}{l}j& -\frac{ \bar{\omega_3}}{2}i -\frac{a \bar{\omega_3}}{l}j & 0 &0 & 0 &0 &0\\ 
\end{pmatrix}
\end{equation}

The angular velocities $\omega_1$ and $\omega_2$ of wheels \#1 and \#2 are given as
\begin{equation}
\label{eqn:slip_omega1and2}
\omega_1=\dot{\theta_1}i+\omega_3, \quad \omega_2=\dot{\theta_2}i+\omega_3
\end{equation}
Using Equations \ref{eqn:slip_do1} and \ref{eqn:slip_omega1and2}, one gets the twist vector for wheel \#1 as 
\begin{equation}
\label{eqn:slip_t1}
t_1=
\begin{pmatrix}
\omega_1\\
\dot{o_1}
\end{pmatrix}=T_1 \dot{\theta}
\end{equation} 
\begin{equation}
\label{eqn:slip_T1}
T_1=
\begin{pmatrix}
i & 0& -k/l & k/l & 0 &0 & 0 &0 &0\\
0 & 0& j& 0 & i &0 & 0 &0 &0\\ 
\end{pmatrix}=
\left(
\begin{array}{ccccccccc}
1 & 0 & 0 & 0 & 0 & 0 & 0 & 0 & 0 \\
0 & 0 & 0 & 0 & 0 & 0 & 0 & 0 & 0 \\
0 & 0 & -\frac{1}{l} & \frac{1}{l} & 0 & 0 & 0 & 0 & 0 \\
0 & 0 & 0 & 0 & 1 & 0 & 0 & 0 & 0 \\
0 & 0 & 1 & 0 & 0 & 0 & 0 & 0 & 0 \\
0 & 0 & 0 & 0 & 0 & 0 & 0 & 0 & 0
\end{array}
\right)
\end{equation}

and 
\begin{equation}
\label{eqn:slip_dT1}
\dot{T_1}=\begin{pmatrix}
\bar{\omega_3}j & 0& 0& 0 & 0 &0 & 0 &0 &0\\
0 & 0& -\bar{\omega_3}i& 0 & \bar{\omega_3}j &0 & 0 &0 &0\\ 
\end{pmatrix}
\end{equation}

Using Equations \ref{eqn:slip_do1} and \ref{eqn:slip_omega1and2} for wheel \#2 the twist vector $t_2$  is obtained as 
\begin{equation}
\label{eqn:slip_t2}
t_2=
\begin{pmatrix}
\omega_2\\
\dot{o_2}
\end{pmatrix}=T_2 \dot{\theta}
\end{equation} 
\begin{equation}
\label{eqn:slip_T2}
T_2=
\begin{pmatrix}
0 & i& -k/l & k/l & 0 &0 & 0 &0 &0\\
0 & 0& 0& j &i &0 & 0 &0 &0\\ 
\end{pmatrix}=
\left(
\begin{array}{ccccccccc}
0 & 1 & 0 & 0 & 0 & 0 & 0 & 0 & 0 \\
0 & 0 & 0 & 0 & 0 & 0 & 0 & 0 & 0 \\
0 & 0 & -\frac{1}{l} & \frac{1}{l} & 0 & 0 & 0 & 0 & 0 \\
0 & 0 & 0 & 0 & 1 & 0 & 0 & 0 & 0 \\
0 & 0 & 0 & 1 & 0 & 0 & 0 & 0 & 0 \\
0 & 0 & 0 & 0 & 0 & 0 & 0 & 0 & 0
\end{array}
\right)
\end{equation}

and 
\begin{equation}
\label{eqn:slip_dT2}
\dot{T_2}=\begin{pmatrix}
0 & \bar{\omega_3}j & 0& 0 & 0 &0 & 0 &0 &0\\
0 & 0& 0& -\bar{\omega_3}i & \bar{\omega_3}j &0 & 0 &0 &0\\ 
\end{pmatrix}
\end{equation}

Next,  the angular velocity of the steered wheel, i.e, body \#4, relative to the absolute frame is given as 
\[\omega_4=\dot{\theta_4}e_4+ \dot{\psi_1} k +\omega_3\]
The transformation matrix between the Frame $\{e_4,f_4\}$ attached to the wheel \#4 is given by the rotation matrix $R_4$. 
\begin{equation}
\label{eqn:slipR4}
R_4=\begin{pmatrix}
\cos \psi_1 & - \sin \psi_1\\
\sin \psi_1 & \cos\psi_1
\end{pmatrix}
\end{equation}
Then, $e_4= \cos\psi_1 i +\sin \psi_1 j$  and $\omega_4$ can be written as 
\[ \omega_4= \dot{\theta_4}( \cos\psi_1 i +\sin \psi_1 j)+ \dot{\phi_1} k +\omega_3 \]
Linear velocity of point $o_4$ is given by
\[ \dot{o_4}=\dot{o_3}+\omega_3 \times (-\frac{c}{2}i+bj) \]
or in terms of the twist as
\begin{equation}
\label{eqn:slip_t4}
t_4=
\begin{pmatrix}
\omega_4\\
\dot{o_4}
\end{pmatrix}=T_4 \dot{\theta}
\end{equation}
where 
\begin{equation}
\label{eqn:slip_T4}
T_4=\left(
\begin{array}{ccccccccc}
0 & 0 & 0 & 0 & 0 & 0 & 0 & \cos\psi_1 & 0 \\
0 & 0 & 0 & 0 & 0 & 0 & 0 & \sin\psi_1 & 0 \\
0 & 0 & -\frac{1}{l} & \frac{1}{l} & 0 & 1 & 0 & 0 & 0 \\
0 & 0 & \lambda_1 & -\lambda_1 & 1 & 0 & 0 & 0 & 0 \\
0 & 0 &\lambda_3 & \lambda_2 & 0 & 0 & 0 & 0 & 0 \\
0 & 0 & 0 & 0 & 0 & 0 & 0 & 0 & 0
\end{array}
\right)
\end{equation}
\begin{equation}
\label{eqn{:slip_dT4}}
\dot{T_4}=\begin{pmatrix}
0 & 0 & 0 & 0 & 0 & 0 & 0 & \lambda_4 & 0\\
0 & 0 & \lambda_7 & \lambda_6 & \bar{\omega_3}j & 0 & 0 & 0 & 0
\end{pmatrix}
\end{equation}

 \[\lambda_1=\frac{a+b}{l}, \quad \lambda_2=\frac{l-c}{2l}, \quad \lambda_3=\frac{l+c}{2l} \]
  \[\lambda_4=(\bar{\omega_3}+\dot{\psi_1}) (\cos\psi_1 j-\sin \psi_1 i) \]
  \[\lambda_6=-\bar{\omega_3}(\lambda_1 j+\lambda_2 i), \quad \lambda_7=\bar{\omega_3}(\lambda_1 j-\lambda_3 i)\]
Next, for wheel \#5  one gets 
\[\omega_5 = \dot{\theta_5} e_5 + \dot{\psi_2} k + \omega_3 \] Using the rotation matrix $R_5$ to express $e_5$ in terms of ${i,j}$ the above equation is written as 
\[\omega_5=
  \left(
\begin{array}{c}
\dot{\theta }_5 \cos \psi_2 \\
\dot{\theta_5} \sin \psi_2 \\
\dot{\psi_2}+\frac{-\dot{y_1}+\dot{y_2}}{L}
\end{array}
\right) \]
Accordingly, the linear velocity of point $o_5$ is given as 
\[ \dot{o_5}=\dot{o_3}+\omega_3 \times o_3o_5\]
where, \begin{equation}
\label{eqn:slipR5}
R_5=\begin{pmatrix}
\cos \psi_2 & - \sin \psi_2\\
\sin \psi_2 & \cos\psi_2
\end{pmatrix}
\end{equation}
Using  \[ o_3o_5=\frac{c}{2}i+bj\] along with $\omega_3$ and $\dot{o_3}$ from Equations \ref{eqn:slip_domega3} and  \ref{eqn:slip_do3},the following is obtained.
\[\dot{o_5}= \left( \dot{x}+\dot{y_1}(\lambda_1)-\dot{y_2}\lambda_1 \right)i +\left( \lambda_2\dot{y_1}+\lambda_3\dot{y_2}\right)j  \]
The twist of body \#5 , i.e., wheel \#5 is given as 
\begin{equation}
\label{eqn:slip_t5}
t_5=
\begin{pmatrix}
\omega_5\\
\dot{o_5}
\end{pmatrix}=T_5 \dot{\theta}
\end{equation}
Where
\begin{equation}
\label{eqn:slip_T5}
T_5=\left(
\begin{array}{ccccccccc}
0 & 0 & 0 & 0 & 0 & 0 & 0 & 0 & \cos \psi_2\\
0 & 0 & 0 & 0 & 0 & 0 & 0 & 0 & \sin\psi_2 \\
0 & 0 & -\frac{1}{l} & \frac{1}{l} & 0 & 0 & 1 & 0 & 0 \\
0 & 0 & \lambda_1 & -\lambda_1 & 1 & 0 & 0 & 0 & 0 \\
0 & 0 &\lambda_2& \lambda_3 & 0 & 0 & 0 & 0 & 0 \\
0 & 0 & 0 & 0 & 0 & 0 & 0 & 0 & 0
\end{array}
\right)
\end{equation}

Using the fact $\dot{e_5}=(\dot{\psi_2}+\bar{\omega_3})k\times e_5 =(\dot{\psi_2}+\bar{\omega_3})f_5$,  $f_5=-\sin \psi_2 i+\cos \psi_2 j$ and coordinate system $\{e_5,f_5\}$ is rotated by $\psi_2$ with respect to coordinate $ \{i,j\}$, $\dot{T_5}$ is given as

\begin{equation}
\label{eqn:slip_dT5}
\dot{T_5}=
\begin{pmatrix}
0 & 0 & 0 & 0 & 0 & 0 & 0 & 0 & \lambda_5\\
0 & 0 & \lambda_7 & \lambda_6 & \bar{\omega_3}j & 0 & 0 & 0 & 0
\end{pmatrix}
\end{equation}
where 
\[ \lambda_5 = (\bar{\omega_3}+\dot{\psi_2}) (\cos\psi_2 j-\sin \psi_2 i) \]
\subsection{Dynamics  with wheel slip}
\label{sec:slipDynamics}
The mass inertia matrix $M_i$ of the wheel and platform are same as that used in Section \ref{sec:GIM}. The generalized inertia matrix is then calculated using $T_i$ derived in Section  \ref{sec:slipKina}, as
\begin{equation}
I(\theta)=\sum_{i=1..n}(T_i^TM_iT_i)
\end{equation}
Where the inertial matrix $M_i$, for $ i=1,2,4,5$ given in Equation \ref{eqn:wheelInertiaMatrix} for each wheel. For platform  \[ I_p=\begin{pmatrix}
 p_{1,1} & p_{1,2} & p_{1,3}\\   
 p_{1,2} & p_{2,2} & p_{2,3}\\   
 p_{1,3} & p_{2,3} & p_{3,3}\\   
\end{pmatrix},  \quad  M_3=\begin{pmatrix}
 I_p & 0_{3x3}\\
 0_{3x3} & m_p 1_{3x3}
\end{pmatrix}\]
where $m_p$ is the mass of the platform and $1_{3x3}$ is the identity matrix.
The generalized inertia matrix $I$ is then given in terms of the  physical parameters of the wheel and platform as 
\begin{equation}
    I=
    \left(
\begin{array}{ccccccccc}
I_w & 0 & 0 & 0 & 0 & 0 & 0 & 0 & 0 \\
 0 & I_w & 0 & 0 & 0 & 0 & 0 & 0 & 0 \\
 0 & 0 & \bar{\alpha_1} & \bar{\alpha_2} & \bar \alpha_3  & -\frac{H}{l} & -\frac{H}{l} & 0 & 0 \\
 0 & 0 & \bar \alpha_2 & \bar \alpha_1 & -\bar\alpha_3 & \frac{H}{l} & \frac{H}{l} & 0 & 0 \\
 0 & 0 & \bar\alpha_3 & -\bar\alpha_3 & \bar\alpha_4& 0 & 0 & 0 & 0 \\
 0 & 0 & -\frac{H}{l} & \frac{H}{l} & 0 & H & 0 & 0 & 0 \\
 0 & 0 & -\frac{H}{l} & \frac{H}{l} & 0 & 0 & H & 0 & 0 \\
 0 & 0 & 0 & 0 & 0 & 0 & 0 & \bar \alpha_5 & 0 \\
 0 & 0 & 0 & 0 & 0 & 0 & 0 & 0 & \bar \alpha_6 \\
\end{array}
\right)
\end{equation}
where
\begin{equation*}
    \bar\alpha_1=\frac{p_{3,3}}{l^2}+m_p \left(\frac{a^2}{l^2}+\frac{1}{4}\right)+\frac{4 H}{l^2}+m_w \left(2 \lambda_1^2+\lambda_2^2+\lambda_3 ^2+1\right)
\end{equation*}
\[\bar \alpha_2=
-\frac{p_{3,3}}{l^2}+m_p \left(\frac{1}{4}-\frac{a^2}{l^2}\right)-\frac{4 H}{l^2}-2 m_w(\lambda_1^2 + \lambda_2 \lambda_3 )
\]
\[\bar\alpha_3=
\frac{a m_p}{l}+2 \lambda_1 m_w \]
\[\bar\alpha_4= m_P+4 m_w \]
\[\bar\alpha_5= I_w \cos^2{\psi_1}+H \sin^2{\psi_1}\]
\[\bar\alpha_6= I_w \cos^2{\psi_2}+H \sin^2{\psi_2}\]

The convective term $C(\theta,\dot{\theta})$ is calculated using the $T_i$, and $\dot{T_i}$ derived in Section \ref{sec:slipKina}, as
\begin{equation}
\label{eqn:RedConv}
C(\theta,\dot{\theta})=\sum_{i=1..n}T_i^T M_i\dot{T_i}+ \sum_{i=1..n}T_i^T W_i M_i T_i)\end{equation}
Introducing the following notions, the explicit expression of Equation \ref{eqn:RedConv}, is obtained below. 
\[ \delta_0=m_w\omega_3, \quad \delta_1= \frac{m_p \omega_3}{2}, \quad \delta_2=\frac{2a^2}{l^2}\delta_1+\frac{a \omega_3 p_{3,3}}{l^2}, \quad m_w\omega_3 \lambda_1(\lambda_2+\lambda_3)\]
\[ \delta_4 = \dot\theta_4 (H-I_w)\cos{\psi_1}\sin{\psi_1},\quad \delta_5=H\lambda_{4j}\sin{\phi_1}+I_w \lambda_{4i}\cos{\psi_1}-\frac{\dot \psi_1+\omega_3}{\dot\theta_4}\delta_4  \]
\[ \delta_6 = \dot\theta_5 (H-I_w)\cos{\psi_2}\sin{\psi_2},\quad \delta_7=H\lambda_{5j}\sin{\phi_2}+I_w \lambda_{5i}\cos{\psi_2}-\frac{\dot \psi_2+\omega_3}{\dot\theta_5}\delta_6  \]
\[\delta_8=\lambda _2 \delta _0+\lambda _3 \delta _0+\delta _0+\delta _1-\delta _2 \quad \delta_9=(\lambda _2+\lambda _3 +1)\delta _0  \]
\[ C=
\left(
\begin{array}{ccccccccc}
 0 & 0 & 0 & 0 & 0 & 0 & 0 & 0 & 0 \\
 0 & 0 & 0 & 0 & 0 & 0 & 0 & 0 & 0 \\
 0 & 0 & 0 & -\frac{a \delta _1}{l}-2 \delta _3+\frac{P_{33} \omega _3}{2 l} & \delta_8 & 0 & 0 & -\frac{\delta _4}{l}-\frac{\delta _6}{l} & 0 \\
 0 & 0 & 2 \delta _3 & \frac{P_{33} \omega _3}{2 l}-\frac{a \delta _1}{l} & \delta_8 & 0 & 0 & \frac{\delta _4}{l}+\frac{\delta _6}{l} & 0 \\
 0 & 0 & -\delta_9& -\lambda _3 \delta _0-\delta _0-\delta _1 & -\frac{2 a \delta _1}{l}-\delta _0 \lambda _2 & 0 & 0 & 0 & 0 \\
 0 & 0 & 0 & 0 & 0 & 0 & 0 & \delta _4 & 0 \\
 0 & 0 & 0 & 0 & 0 & 0 & 0 & \delta _6 & 0 \\
 0 & 0 & 0 & 0 & 0 & 0 & 0 & \delta _5 & 0 \\
 0 & 0 & 0 & 0 & 0 & 0 & 0 & 0 & \delta _7 \\
\end{array}
\right)\]
The wrench $\tau$ acting on the system is given as 
\begin{equation}
\label{eqn:slipTauSum}
\tau=\sum_{i=1..n}T_i^T w^w_i
\end{equation}
\begin{figure}
	\begin{minipage}[t]{0.5\textwidth}
		\centering
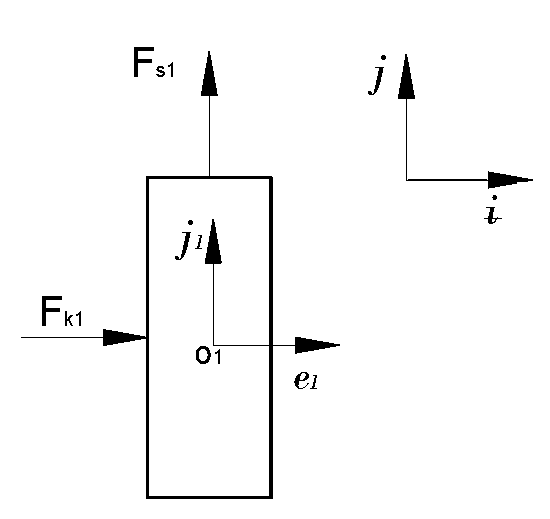
[picture p16: Chapter4/fig/ForceWheel1.png]
		
		\caption{External force on rear wheel}\label{fig:ForceRearWheel}
	\end{minipage}
	\hfill
	\begin{minipage}[t]{0.5\textwidth}
		\centering
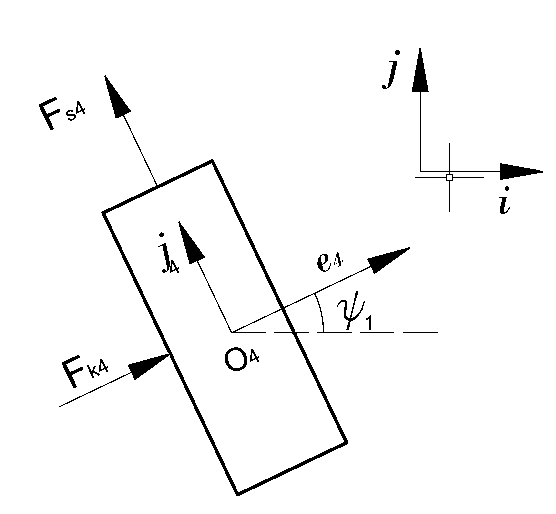
[picture p17: Chapter4/fig/ForceWheel2.png]
		
		\caption{External forces on front wheel }\label{fig:ForceFrontWheel}
	\end{minipage}
	%\caption{Actuator effort}
\end{figure} 
The matrix $T_i$ has allready been calculated in the above section, whereas $w_i^w$ is derived next. The vector, $w_i^w$ is the working wrench acting on the individual bodies. This consists of all the external forces such as actuator force, friction force and gravitational force.
The forces acting on wheel 1, as shown in Figure \ref{fig:ForceRearWheel},  are the friction force due to longitudinal slip $F_{s1}$ and frictional force  due to lateral slip or skidding, $F_{k1}$ at the ground-wheel interface . The motor torque acting on the wheel 1 is $\tau_{m1}$.  Similarly forces acting on wheel 2 are $F_{s2}$, $F_{k2}$ and $\tau_{m2}$. Therefore, $w_1$ and $w_2$ are written as 
\begin{equation}
\label{eqn:wrenchWheelSlipRear}
 w_n=\begin{pmatrix}
\tau_{m,n}i\\
F_{k,n}i+F_{s,n}j
\end{pmatrix},  \quad n=\{1,2\}
\end{equation}
The superscript $w$ has been removed as it is understood that only working forces need to be considered in the formulation below. 
The front wheels have steering actuation, let the steering  torques be represented by $\tau_{s,4}$ and  $\tau_{s,5}$ for the wheel \#4, and \#5. The friction forces on the front steered wheel is shown in Figure \ref{fig:ForceFrontWheel} act along $\{e_4,f_4\}$ and $\{e_5,f_5\}$ for the two front wheels. No traction motor torque is applied to the front wheels as they are passive. Therefore, $w_4$ and $w_5$ are given by
\begin{equation}
\label{eqn:wrenchWheelSlipFront}
w_n=\begin{pmatrix}
\tau_{s,n}k\\
F_{k,n}e_n+F_{s,n}f_n
\end{pmatrix},  \quad n=\{4,5\}
\end{equation}
Since no external force is acting on the platform, i.e., body \#3, \[w_3=0_{6x1}\]

One can then calculate $T_i^Tw_i$, as

\begin{subequations}
	\label{eqn:slip_Tau_is}
	\begin{align}
	T_1^T w_1&=\begin{pmatrix}
	\tau_{m1} & 0 & F_{s1}& 0& F_{k1}&0&0&0&0
	\end{pmatrix} ^T\\
	T_2^T w_2&=\begin{pmatrix}
	0&\tau_{m2}& 0&F_{s2}&  F_{k2}&0&0&0&0
	\end{pmatrix} ^T\\
	T_3^T w_3&=0_{9x1} \quad \text{since } w_3=0\\
	T_4w_4&= \begin{pmatrix}
	0 & 0& \alpha_1& \alpha_2 & \alpha_3 &\tau_{s4}& 0&0 &0
	\end{pmatrix}^T\\
	T_5w_5&=\begin{pmatrix}
	0 & 0& \beta_1& \beta_2 & \beta_3 &0 &\tau_{s5}& 0&0
	\end{pmatrix}^T
	\end{align}
\end{subequations}
where 
\[\alpha_1=-\frac{\tau_{s4}}{l}+\lambda_1(F_{k4}C_{\phi_1}-F_{s4}S_{\phi_1})+\lambda_3(F_{k4}S_{\phi_1}+F_{s4}C_{\phi_1})\]
\[\alpha_2=\frac{\tau_{s4}}{l}-\lambda_1(F_{k4}C_{\phi_1}-F_{s4}S_{\phi_1})+\lambda_2(F_{k4}S_{\phi_1}+F_{s4}C_{\phi_1})\]
\[\alpha_3=(F_{k4}C_{\phi_1}-F_{s4}S_{\phi_1})\]
\[\beta_1=-\frac{\tau_{s5}}{l}+\lambda_1(F_{k5}C_{\phi_2}-F_{s5}S_{\phi_2})+\lambda_2(F_{k5}S_{\phi_2}+F_{s5}C_{\phi_2})\]
\[\beta_2=\frac{\tau_{s5}}{l}-\lambda_1(F_{k5}C_{\phi_2}-F_{s5}S_{\phi_2})+\lambda_3(F_{k5}S_{\phi_2}+F_{s5}C_{\phi_2})\]
\[\beta_3=(F_{k5}C_{\phi_2}-F_{s5}S_{\phi_2})\]
Therefore, the expression for  $\tau$ in  Equation \ref{eqn:slipTauSum} can be written as
\begin{multline}
\tau=(
\tau_{m1} \quad \tau_{m2} \quad (F_{s1}+\alpha_1+\beta_1) \quad( F_{s2}+\alpha_2+\beta_2) \\
 \quad  (F_{k1}+ F_{k2}+\alpha_3+\beta_3)\quad \tau_{s4}\quad  \tau_{s5} \quad 0 \quad 0 )  ^T
\end{multline}
The longitudinal  friction force $F_{si}$ for $i=1,2,4,5 $ is given by Equation \ref{eqn:magic} or any other adhesion model, with $ x $ as the slip ratio $\rho_i$ defined as
\[
x = \rho_i = \frac{\dot{\theta_i} r - \dot{o_i}.\hat{f_i}}{\max(\dot{\theta_i} r,\quad \dot{o_i}.\hat{f_i})}
\]
The lateral force  $F_{ki}$ for $i=1,2,4,5 $, i.e., the skid forces are given again by adhesion model such as Equation \ref{eqn:magic},  where $x$ is the slip angle $\delta$ defined in Figure \ref{fig:skid}. 
\[
x = \delta_i=\tan^{-1}(\frac{\dot{o_i}.e_i}{\dot{o_i}.f_i})
\]
It may be noted that $f_i,e_i$ are unit vectors of the coordinate system defined at each wheel centre and $\dot{o_i}$ are the velocities of wheel centres as shown in Figure  \ref{fig:ForceRearWheel}.
\subsection{Simulation}
To study the effect of wheel slip on the mobile robot dynamics, forward dynamics of the mobile robot was carried out. 
A reduced order  of the dynamic  equation derived in section \ref{sec:DynamicNoSlip} was used.
 The order was reduced by  neglecting the dynamic effect due to steering motion of the front wheels. The  variables $\psi_1$ and $\psi_2$ was  removed  from the  set of independent variables. They were directly set  at each time step using the relation,
 \[\phi_1=\arctan\left( \frac{(a+b)(\dot{y_2}-\dot{y_1})}{\dot{y_1}L}\right) , \quad
 \phi_2=\arctan\left( \frac{(a+b)(\dot{y_2}-\dot{y_1})}{\dot{y_2}L  }\right) 
 \]
  under the assumption $c=L/2$.
The total number of independent variables  was  reduced from  9 to 5. The new set of independent variables are now

\begin{equation}
\label{eqn:theta_slip_reduced}
\dot{\theta}_{red}=(\dot{\theta_1},\dot{\theta_2}, \dot{y_1},\dot{y_2},\dot{x})^T
\end{equation} 

The physical parameters used for the mobile robot are same as the one used in simulation of forward and inverse dynamics with ideal rolling condition for the wheels that  are listed in Table \ref{tb:massproperty}.
The generalized inertia  matrix $I_{red}$  and the convective term $ C_{red}$ of the reduced system are given by
\begin{equation}
I_{red}=\left(
\begin{array}{ccccc}
0.00046395 & 0 & 0 & 0 & 0 \\
0 & 0.00046395 & 0 & 0 & 0 \\
0 & 0 & 167.399 & -131.899 & 73.3333 \\
0 & 0 & -131.899 & 167.399 & -73.3333 \\
0 & 0 & 73.3333 & -73.3333 & 71.00
\end{array}
\right)
\end{equation}
\begin{equation}
C_{red}=\left(
\begin{array}{ccccc}
0 & 0 & 0 & 0 & 0 \\
0 & 0 & 0 & 0 & 0 \\
0 & 0 & 0 & -\frac{73.3333 (\dot{y_2} - \dot{y_1})}{l} & \frac{35.5 (\dot{y_2} - \dot{y_1})}{l} \\
0 & 0 & \frac{73.3333 (\dot{y_2} - \dot{y_1})}{l} & 0 & \frac{35.5 (\dot{y_2} - \dot{y_1})}{l} \\
0 & 0 & -\frac{35.5 (\dot{y_2} - \dot{y_1})}{l} & -\frac{35.5 (\dot{y_2} - \dot{y_1})}{l} & 0
\end{array}
\right)
\end{equation}
The equations of motion of the reduced system are given by 
\begin{equation}
I_{red}\ddot{\theta}_{red}+C_{red}\dot{\theta}_{red}=\tau_{red}
\end{equation}
The $\tau_{red}$ is calculated using Equation \ref{eqn:slipTauSum} with $i=1,2,3 $, where $w_i$ for $ i=1,2$ are given in Equation \ref{eqn:wrenchWheelSlipRear}.
Earlier $w_3=0$ was used as no external wrench was acting on it. In the reduced model case it is assumed that the frictional force acting on the front wheels are directly transmitted to the platform. Therefore, the moment acting about the C.G., of the platform, $O_3$ is given by
\begin{equation}
 	\label{eqn:redPlatMoment}
 	\tau_{p}=(F_{S4}+F_{K4}) \times (-i c+jb) +(F_{S5}+F_{K5}) \times (i c+jb) +T_s
\end{equation}
where $F_{Si},F_{Ki},\quad i=4,5$ are those explained in Section \ref{sec:slipDynamics}, $T_s$ is calculated as given  in Section \ref{sec:SteerinTorqueStatic}.
Therefore, $w_3$ is written as 
\begin{equation}
w_3=\begin{pmatrix}
\tau_{p}\\
F_{S4}+F_{K4}+F_{S5}+F_{K5}
\end{pmatrix}
\end{equation}

To evaluate $F_{s,i} $ and $F_{k,i}$ for $i=1,2,4,5$,   which are function of  slip ratio or slip angle,  Equation \ref{eqn:friction_Slip}  \cite{balakrishna1995modeling}, which is based on adhesion model proposed by \cite{dugoff1970analysis} was used.  A representative Friction-slip curve with the peak friction co-efficient, $\mu_{peak}=0.1$, is given in  Figure \ref{fig:friction_Slip}. The longitudinal and lateral friction forces acting on the wheels are given as $Fs=\mu N_i$ where $N_i$ is the normal force action on the wheel due to ground reaction.  
\begin{equation}
\label{eqn:friction_Slip}
\mu =
\begin{cases}
-(\lambda-0.15)\frac{0.34\mu_{peak}}{0.85}-\mu_{peak}, & -0.15\le\lambda \le -1.00,\\
(\lambda-0.15)\frac{\mu_{peak}}{0.15}+\mu_{peak}, & -0.15<\lambda<0.15,
\\
-(\lambda-0.15)\frac{0.34\mu_{peak}}{0.85}+\mu_{peak}, & 0.15\le\lambda \le 1.00.
\end{cases}
\end{equation}
To calculate $F_{Si},F_{Ki}$ for $ i=4,5$ spin rate of front wheels $\dot\theta_4,\dot\theta_5$ are required. This is obtained from Equation \ref{eqn:simpDynFront} which represents the dynamics  of the front wheels, where $r$ is the radius of wheel and $I_w$ is the inertia of wheel about $e_i$.
\begin{equation}
\label{eqn:simpDynFront}
I_w\begin{pmatrix}
 \ddot\theta_4\\
 \ddot\theta_5
\end{pmatrix}
=
\begin{pmatrix}
F_{s4} r\\
F_{s5} r
\end{pmatrix}
\end{equation}
 Figure \ref{fig:InputTorqueProfile} shows input torque applied to the two rear wheels for the forward dynamic simulation. This torque profile for the pair of rear wheels was generated by inverse dynamics  of the mobile robot presented in Section \ref{sec:InvDynamics_NoSlip} to trace a circular path given in Figure \ref{fig:CirTrace} and represented by Equation \ref{path} on a flat surface under the assumption of pure rolling condition of all wheels. 

\begin{figure}
	\begin{minipage}[t]{0.5\textwidth}
		\centering
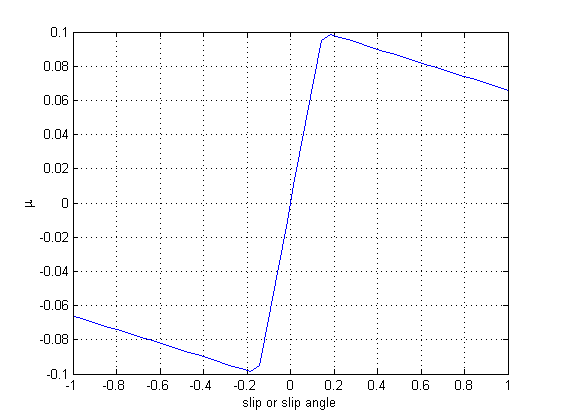
[picture p18: Chapter4/fig/frictionVsSlip.png]
		
		\caption{Friction model}\label{fig:friction_Slip}
	\end{minipage}
	\hfill
	\begin{minipage}[t]{0.5\textwidth}
		\centering
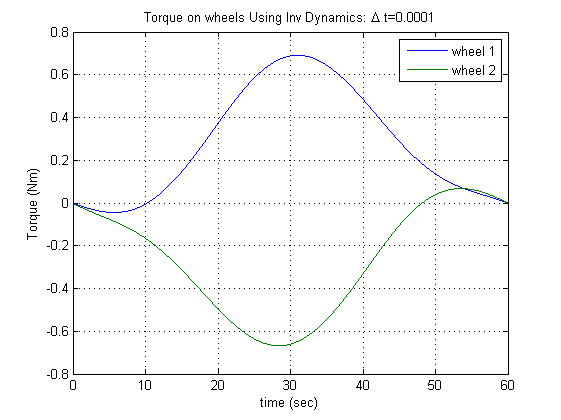
[picture p19: Chapter4/fig/InputTorqueProfile.png]
		
		\caption{Input torque profile }\label{fig:InputTorqueProfile}
	\end{minipage}
	%\caption{Actuator effort}
\end{figure}
\ 
\subsection{Results and inference}
The path traced by the RARS mobile robot  with  $\mu_{peak} =0.3$ is shown in Figure \ref{fig:pathWithMu3}. There is no visible difference between the  actual path traced  and the given path in terms of lateral shift. If $R_r(t)$ is the actual distance of the robot from the path centre $``O"$ and $R=5$m is the radius of the path, the radial deviation,  the lateral shift given by  $ R_r(t)-R$ is shown in Figure \ref{fig:radialErrorMu3}. It is in the range of $10^{-9}$, which is effectively zero.  This is justified in view of Figure \ref{fig:ForcesMu3} which presents the plot of lateral force acting on the vehicle during the period of its motion. The centrifugal force, denoted by green line,  tries to shift the vehicle laterally is below the maximum frictional resistance provided by the wheel-surface interface, denoted by the red line. Hence, the net lateral force acting on the mobile robot at any point of time during the motion is zero as indicated by the blue line (not visible in Figure \ref{fig:ForcesMu3} as it is covered by the black axis line).
\begin{figure}
	\begin{minipage}[t]{0.5\textwidth}
		\centering
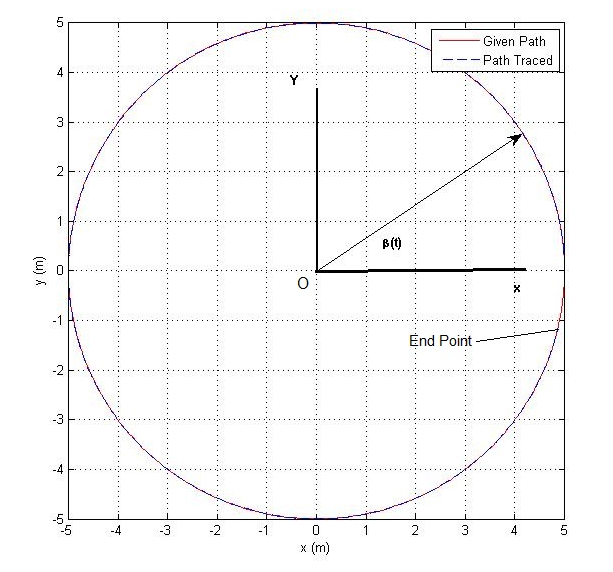
[picture p20: Chapter4/fig/PathWithMu-3slip.png]
		
		\caption{RARS path traced when $\mu=0.3$}\label{fig:pathWithMu3}
	\end{minipage}
	\hfill
	\begin{minipage}[t]{0.5\textwidth}
		\centering
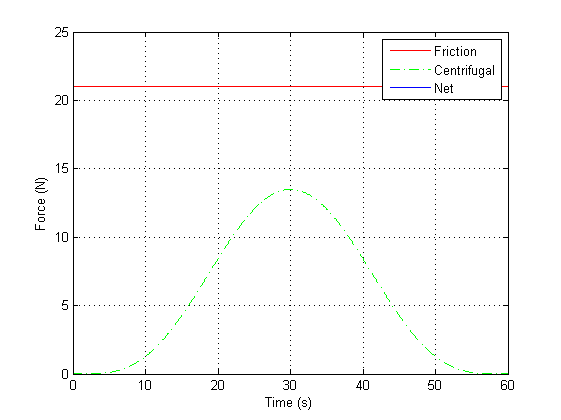
[picture p21: Chapter4/fig/ForceMu-3.png]
		
		\caption{Forces on RARS when $\mu=0.3$ }\label{fig:ForcesMu3}
	\end{minipage}
	%\caption{Actuator effort}
\end{figure}

Though the RARS robot maintains the path radius (R) at all time, it is not able to complete the path. The path ends at coordinate  ${(4.862,-1.166)}$ denoted by ``End Point" in  Figure \ref{fig:pathWithMu3} instead of  ${(5,0)}$. This is because  there is equal  slip in both the wheels which result in less distance being  covered along the given path.    If, $\beta(t)$ denotes the position the RARS should have attained at time, $t$, in actual run, the robot is able to cover only the angle $\beta_r(t)$. Therefore there exists an angular displacement error or  phase error, $\beta(t)-\beta_r(t)$, in terms of the circular motion of the robot as shown in Figure \ref{fig:PhazeErrorMu3}. This error actually indicates that the robot has not travelled the distance as required by the given trajectory at time, $t$. The figure clearly shows that total angular displacement of the robot is less than $350^o$ at the end of 60 sec.

\begin{figure}
	\begin{minipage}[t]{0.5\textwidth}
		\centering
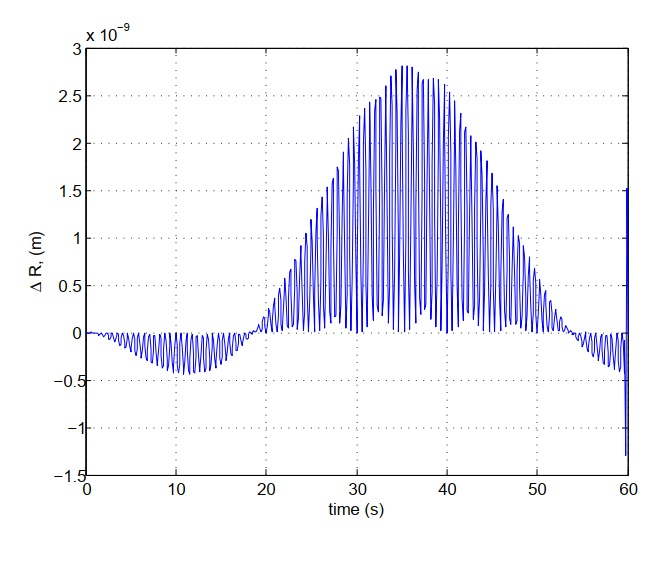
[picture p22: Chapter4/fig/radialError_mu03.jpg]
		
		\caption{RARS, radial deviation ($\mu=0.3$)}\label{fig:radialErrorMu3}
	\end{minipage}
	\hfill
	\begin{minipage}[t]{0.5\textwidth}
		\centering
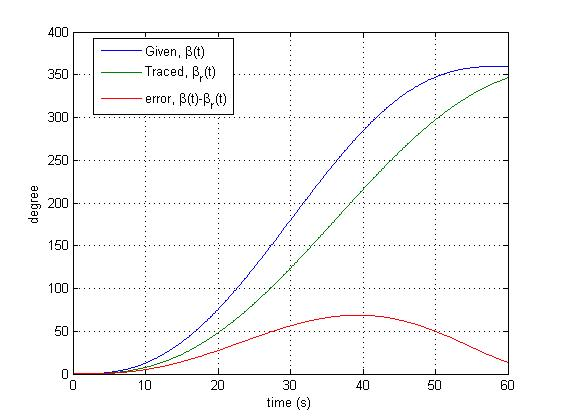
[picture p23: Chapter4/fig/phazeError_mu03.jpg]
		
		\caption{Phase and phase error ($\mu=0.3$) }\label{fig:PhazeErrorMu3}
	\end{minipage}
	%\caption{Actuator effort}
\end{figure}

 Figure \ref{fig:pathWithMu1}, shows the trajectory of the RARS robot when the maximum coefficient of friction between the ground and tire is  $\mu_{peak} =0.1$. 
 In this case both lateral, as shown in Figure \ref{fig:radialError_mu01} and longitudinal shift, as shown in Figure \ref{fig:phazeError_mu01}, are present. The  net lateral force acting on the vehicle, i.e., the blue curve of Figure \ref{fig:ForcesMu1} is greater than zero between 20 sec to 40 sec. This lateral force is responsible for the lateral deviation of the actual path traced from the given path. The deviation increases from point ``A" to point ``B" in Figure \ref{fig:pathWithMu1}. This is region of the path where the centrifugal force exceeds the frictional force. After point ``B" the curve maintains constant radius as the net lateral force acting on the mobile robot again becomes zero. 
\begin{figure}
	\begin{minipage}[t]{0.5\textwidth}
		\centering
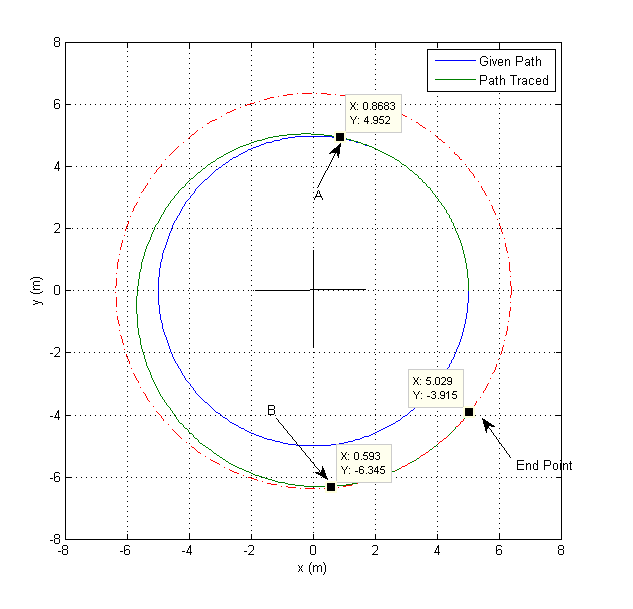
[picture p24: Chapter4/fig/PathWithMu-1slip.png]
		
		\caption{RARS path traced when $\mu=0.1$}\label{fig:pathWithMu1}
	\end{minipage}
	\hfill
	\begin{minipage}[t]{0.5\textwidth}
		\centering
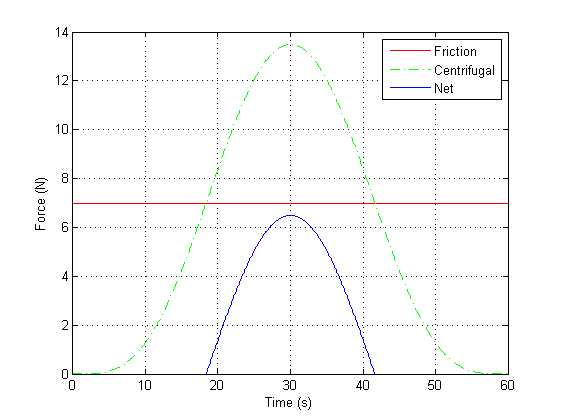
[picture p25: Chapter4/fig/ForceMu-1.png]
		
		\caption{Forces on RARS when $\mu=0.1$ }\label{fig:ForcesMu1}
	\end{minipage}
	
\end{figure}
\begin{figure}
	\begin{minipage}[t]{0.5\textwidth}
		\centering
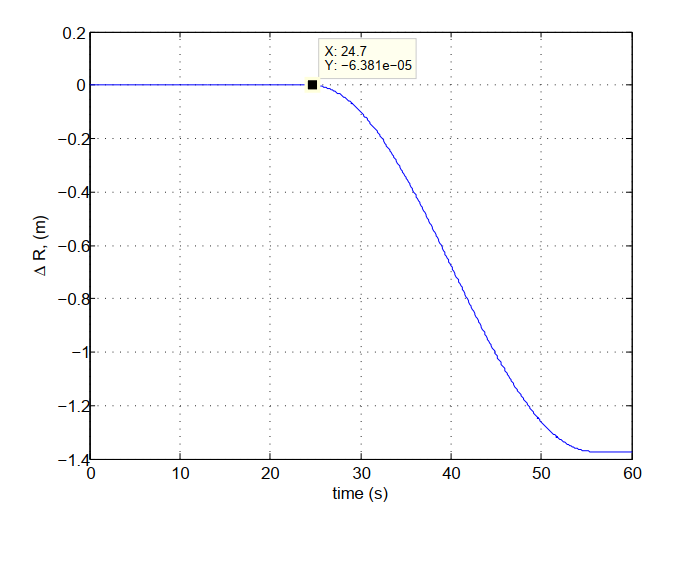
[picture p26: Chapter4/fig/radialError_mu01.png]
		
		\caption{RARS radial deviation ($\mu=0.1$)}\label{fig:radialError_mu01}
	\end{minipage}
	\hfill
	\begin{minipage}[t]{0.5\textwidth}
		\centering
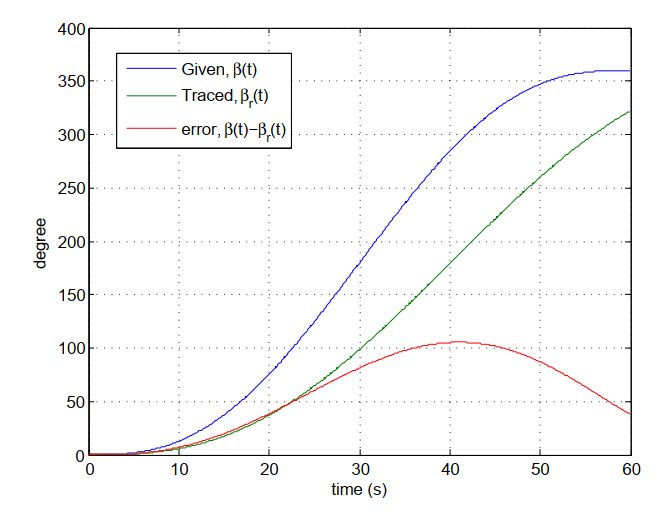
[picture p27: Chapter4/fig/phazeError_mu01.png]
		
		\caption{Phase and phase error ($\mu=0.1$) }\label{fig:phazeError_mu01}
	\end{minipage}
	%\caption{Actuator effort}
\end{figure}

Note that Figure \ref{fig:beta1} shows the variation of $\beta(t)$ defined in Equation \ref{path} and $\dot\beta(t)$ with time.  Figure \ref{fig:ForcesMu1} indicates  that the lateral slip initiates at time $t\approx25$ s when $\mu=0.1$ . This corresponds to angular velocity of $ \dot \beta =0.158$ rad/sec as can be read from Figure \ref{fig:beta1} at time $t\approx25$ s.
\begin{figure}[h]
	\centering
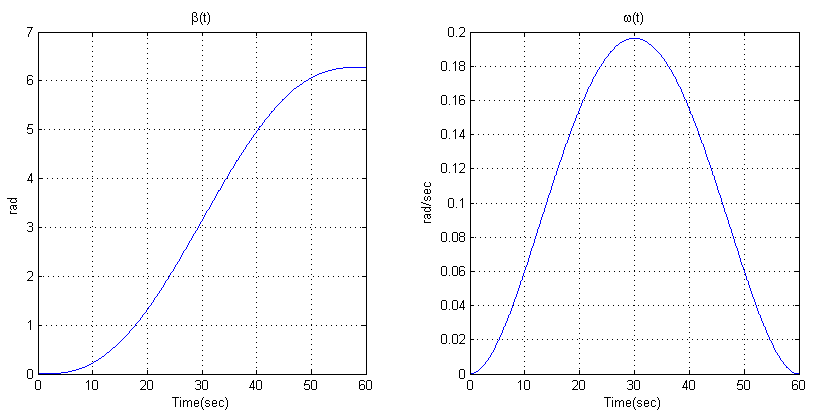
[picture p28: Chapter4/fig/beta.png]
	
	\caption{Plot of $\beta$ and $\dot{\beta}$}
	\label{fig:beta1}
\end{figure}
The linear velocity of the robot to initiate lateral slipping is then given by $R\dot{\beta}$, which is equal to $0.79$  m/sec. The robot at hand is restricted to the speed of $0.5$ m/sec as specified in the robot specification in Table \ref{tb:specifications}. The estimated coefficient of friction between the Polyurethane wheel liner and factory floor is around $0.3$. Therefore skidding of the mobile robot RARS is unlikely during teleoperation. 

\section{Dynamical Model of Steering System}
Typically, the tuning of steering motor is done while the vehicle is stationary. Hence, an independent dynamic model for steering system is essential, which is carried out in this section. 
The  steering system is shown in Figure \ref{fig:SteerAsm}. The equations of motion were derived under the assumptions,  that the vehicle body \#3 was at rest and  the mass of links \#8 and \#9 were negligible compared to other links. The kinematic energy of each body except \#8 and \#9 is derived below.

The kinetic energy of link  \#6 is given by
\begin{equation}
 K_6=\frac{1}{2}(m_6((x^b_6)^2+(y^b_6)^2)+I_{6zz})\dot{\phi_6}
\end{equation}
 where, $m_6$ is the mass, $(x^b_6,y^b_6)$  the coordinate of c.m.  expressed  in the body co-ordinate frame $B:\{i_6,j_6,k_6\}$ as shown in Figure \ref{fig:SteerLink} and $I_{6zz}$ is the moment of inertia in the body coordinate of link \#6.

 Next we derive the kinetic energy of body \# 4, the wheel. 
 The coordinate of c.g of wheel, $O_4$ in the world  $F:\{i,j,k\}$  is given by \[ \begin{pmatrix}
x_{4}\\y_{4} \end{pmatrix}_F
= \begin{pmatrix}-\frac{l}{2} \\0
\end{pmatrix}+
\begin{pmatrix}
		\cos\phi_6 &  -\sin\phi_6\\ -\sin\phi_6 & \cos\phi_6
\end{pmatrix} + 
\begin{pmatrix}
			-l_3\\0
\end{pmatrix}\]
\begin{figure}
	\begin{minipage}[t]{0.5\textwidth}
		\centering
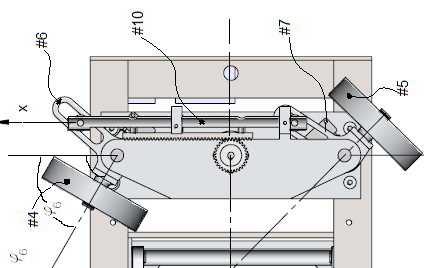
[picture p29: Chapter4/fig/SteerModel.png]
		 
		\caption{Steering assembly}\label{fig:SteerAsm}
	\end{minipage}
	\hfill
	\begin{minipage}[t]{0.5\textwidth}
		\centering
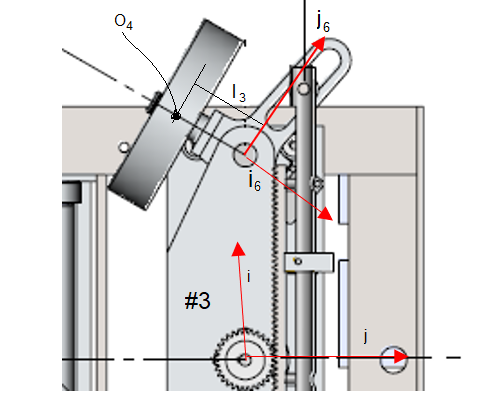
[picture p30: Chapter4/fig/link.png]
		 
		\caption{Steering linkage }\label{fig:SteerLink}
	\end{minipage}
	%\caption{Actuator effort}
\end{figure}
 	
  The linear velocity $\dot{O}_4$  and its angular velocity $\omega_6$  expressed in the world frame $F:\{i,j,k\}$ is given by
 \begin{eqnarray}
 \dot{O}_4=l_6\dot{\phi_6}[\sin\phi_6, ~ -\cos\phi_6] ^T
 \end{eqnarray}
 
 \begin{equation}
 \omega_6=\dot\phi_6k_6+\dot\theta_4i_6 ~=~ [\dot\theta_4\cos\phi_6,~ \dot\theta_4\sin\phi_6,~ \dot\phi_6]^T
 \end{equation} where, $l_6$ is the length as shown in Figure \ref{fig:SteerLink}  and $\dot\theta_4$ is the spinning rate of the wheel about axis $i_6$.
 Then the kinetic energy of body \#4 is given by
\begin{equation}
 K_4=\frac{1}{2}(m\dot O_4 ^T ~\dot O_4+ \omega_6^T [I_6]_F~\omega_6  )
 \end{equation}
 \begin{multline}
 K_4=\frac{1}{2} l_6^2 \dot\phi_6 m \begin{pmatrix}
 \sin\phi_6, ~ -\cos\phi_6
 \end{pmatrix}
 \begin{pmatrix}
 \sin\phi_6\\ -\cos\phi_6
 \end{pmatrix}\\
 + 
 \begin{pmatrix}
 \dot\theta_4 \cos\phi_6, ~ \dot\theta_4 \sin\phi_6, ~\dot\phi_6
 \end{pmatrix}[I_6]_F
 \begin{pmatrix}
 \dot\theta_4 \cos\phi_6\\ \dot\theta_4 \sin\phi_6\\ \dot\phi_6
 \end{pmatrix}
 \end{multline} Where $[I_6]_F$ is the inertia matrix of wheel about its c.g. expressed in world frame $F$.
 In general the moment of inertia matrix of the body is known in the body frame $B$, ie $[I_6]_B$. This can be transformed to the world coordinate frame $F$ by using the formula
 \[ [I_4]_F=R^F_B[I_4]_B [R^F_B]^T\] where, $R^F_B$ represents rotation transformation matrix between the fixed Frame, $F$, and the body frame, $B$. 
 The above Equation, after above transformation can be written as
 \begin{equation}
 K_4=\frac{1}{2}(l_3^2\dot\phi_6^2m_4+[I_{4xx}]_B\theta_4^2)
 \end{equation} 
where, $I_{4zz} $ is the moment of inertia of the wheel about its z axis in the body coordinate frame.

The kinetic energy of the tie rod, i.e., body \#10, which under goes linear reciprocating motion in a plane is given by
\begin{equation}
K_{10}=\half m_{10} \dot{x}
\end{equation} where, $x$ is the displacement of the tie rod and $m_{10}$ is its mass.

The kinetic energy of body \#5, i.e., second wheel and second link \#7 can be derived in a similar fashion as that of body \#4 and \#6 respectively. The kinetic energy of body \#7 is given as
\begin{equation}
K_7=\frac{1}{2}(m_7((x^b_7)^2+(y^b_7)^2)+I_{7zz})\dot{\phi_7}
\end{equation}
where, $m_7$ is the mass and  $I_{7xx}$ moment of inertia of body \#7 .

The kinetic energy of body \#5  is given as
 \begin{equation}
K_4=\frac{1}{2}(l_3^2\dot\phi_7^2m_5+[I_{5xx}]_B\theta_5^2)
\end{equation} 
 where $m_5$  is the mass and $I_{5xx}$ moment of inertia of body \#5.

From the geometry of Figure \ref{fig:davis} following relations can be derived 
\begin{equation}
\label{eqn:thetaTox}
\tan(\alpha-\phi_6)=\frac{b+x}{h}, \quad \quad \tan(\alpha-\phi_7)=\frac{b-x}{h}
\end{equation}
\begin{equation}
\label{ro}
x^b_6+y^b_6=x^b_7+y^b_7=r_0
\end{equation}
\begin{equation}
\dot{\phi_6}=\dfrac{h\dot x}{h^2+b^2+2bx+x^2}=f_1(x)\dot x,\quad \dot{\phi_7}=\dfrac{h\dot x}{h^2+b^2-2bx+x^2}=f_2(x)\dot x
\end{equation}
 Therefore the total kinetic energy of steering unit is 
\[K_s=\sum_{i=4..10}K_i\]
using the expression for $K_i$  and using Equations 4.48, 4.49 and 4.50, the above equation for $K_s$  is written as 
\begin{multline}
	K_s=\frac{\dot x^2}{2} \left( m_{10}+(m_l r^2_0+I{zz})+l^2_3m_w \right) \left(f^2_1(x)+f^2_2(x) \right)\\ + \half I_{wxx}\left(\dot\theta^2_4  +\dot\theta^2_5\right)
\end{multline}
under the following assumptions \[l_3=l_4, \quad m_4=m_5=m_w, \quad m_6=m_7=m_l, \quad I_{7zz}=I_{6zz}=I_{zz}\]
The Lagrangian in this case is simply the kinetic energy, i.e,  $L=K_s$. Since the external forces acts only along the $x$ ordinate, via steering motor. We get
\[F_x= \dfrac{\partial}{\partial t}\dfrac{\partial L}{\partial \dot x} - \dfrac{\partial L}{\partial x}\]
or 
\begin{multline}
\label{eqn:SteerDyn}
F_x=\ddot{x}\left[ m_{10}+\left(m_lr_o^2+I{zz}+l^2_3m_w \right) \right] \left( f_1^2+f_2^2 \right)\\
+2\dot x^2 \left(m_lr^2+I{zz}+l_3^2 m_w \right) \left( f_1 \dot f_1 +f_2 \dot f_2\right)+F_1+F_2
\end{multline}
The external force $F_1$ and $F_2$ in the above equation is given by
\[F_i=\dfrac{T_s}{h},i={1,2} \]
where $T_s$ is evaluated using Equation \ref{eqn:brake} assuming symmetric loading of both the wheels. The derivative of $f_1(x)$ and  $f_2(x)$ is given by 
\[ \dfrac{df_1}{dt}=-\dfrac{2(x+b)h}{(h^2+b^2+2bx+x^2)^2}, \quad \dfrac{df_2}{dt}=-\dfrac{2(x-b)h}{(h^2+b^2-2bx+x^2)^2}\]

\subsection{Design of PID controller}
To control the steer angle of the front wheels a computed torque controller \cite{craig2005introduction} was designed. If $U$ denotes the auxiliary control input then $F_x$ is given by
\begin{multline}
\label{eqn:SteerCont}
F_x=U\left[ m_{10}+\left(mr_o^2+I{zz}+l^2_3m_w \right) \right] \left( f_1^2+f_2^2 \right)\\
+2\dot x^2 \left(mr^2+I{zz}+l_3^2 m_w \right) \left( f_1 \dot f_1 +f_2 \dot f_2\right) 
+F_1+F_2
\end{multline}
eliminating  $F_x$ using Equation \ref{eqn:SteerDyn} and Equation\ref{eqn:SteerCont}, we get
\begin{equation}
\label{eqn:SteerCont2}
\ddot x =U
\end{equation}
If $x_d$, is the set point for the displacement of the rack of the steering system and $e(t)=(x(t)-x_d)$ is the position error, we define auxiliary input $U$ as  
\begin{equation}
\label{eqn:SteerCont3}
 U=-K_d \dot x -K_p \left(x(t)-x_d \right) -K_i\int e(t)dt \end{equation}
then Equation \ref{eqn:SteerCont2} which represents the overall dynamics of the steering mechanism along with the controller, can  be written as 
\[\ddot e(t) +K_d \dot{e}(t) +K_p e(t)+ K_i\int e(t)dt=0 \]
It is be noted that $\dot e(t)=\dot x$ and $\ddot e(t)=\ddot x$, since $x_d=const$. Given that  $y_1(t)= \int e(t)$ and $Y=[y_1,~y_2,~y_3]^T$, the above equation can be rewritten in state space \[\dot{Y}=AY\] or
\begin{equation}
\begin{pmatrix}
\dot y_1 \\ \dot y_2 \\\dot y_3
\end{pmatrix}
=
\begin{pmatrix}
0 & 1 & 0\\ 0 & 0 & 1\\ -K_i & -K_d & -K_p
\end{pmatrix}
\begin{pmatrix}
 y_1 \\ y_2 \\ y_3
\end{pmatrix}
\end{equation}
With $K_d=20,~K_p=60,~K_i=100 $ the system is stable as  the state transition matrix $A$ has all its eigen values, $\lambda$, with negative real part, as given below 
\[ \lambda= \{-16.7794 + 0.0000i, ~ -1.6103 + 1.8348i, ~ -1..6103 - 1.8348i\}\]
 These controller parameters were arrived by trial and error using multiple simulation. The guiding principle behind the selection of these parameters was to choose one root far away form the imaginary axis so that its contribution to the response decays faster with the respect to  the other two roots.  The system then behaves as second order system. The remaining two roots thus governs the dynamics of the system.  They were chosen as complex conjugate with negative real part near the imaginary axis so as to make the steering unit dynamics  under damped.

\subsection{Simulation and results}
The simulation of the  dynamic Equation \ref{eqn:SteerDyn} and controller given by Equations \ref{eqn:SteerCont} and \ref{eqn:SteerCont3} was carried out with the step change in steering angle responding to $ 20~mm$  rack displacemet $(x)$.  The parameter used for the nominal plant were obtained form solid model of the parts and are listed in table \ref{tb:steerPara}. The results of the wheel orientations and the actuator effort required are given in Figure \ref{fig:SteerPos} and \ref{fig:SteerEfort} respectively.

\begin{table}[!htbp]
	\caption{Key parameters steering assembly.}
	\label{tb:steerPara}
	\centering
	\begin{tabular}{l l l }
		\hline
		
		%\emph{Parameter}  & \emph{Example} & \emph{Font size and style} \\
		%\hline
		Wheel Mass& $m_w $ &$ 350~g$  \\ 
		Wheel Inertia & $I_{wxx}$ & $463~ Kg ~mm^2$\\
		Connecting Rod Mass & $m_{10} $& $200~g$ \\
		Link mass& $m_l$ & 80g\\
		Link Inertia & $I_{zz} $& $60834~Kg ~mm^2$\\
		Link Cg distance & $r_o$ & $18mm$\\
		\hline
	\end{tabular}
\end{table}

\begin{figure}
	\begin{minipage}[t]{0.5\textwidth}
		\centering
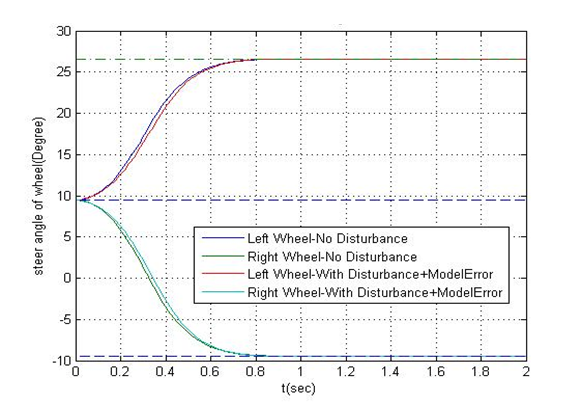
[picture p31: Chapter4/fig/SteeringPos.png]
		 
		\caption{Change in steer angle}\label{fig:SteerPos}
	\end{minipage}
	\hfill
	\begin{minipage}[t]{0.5\textwidth}
		\centering
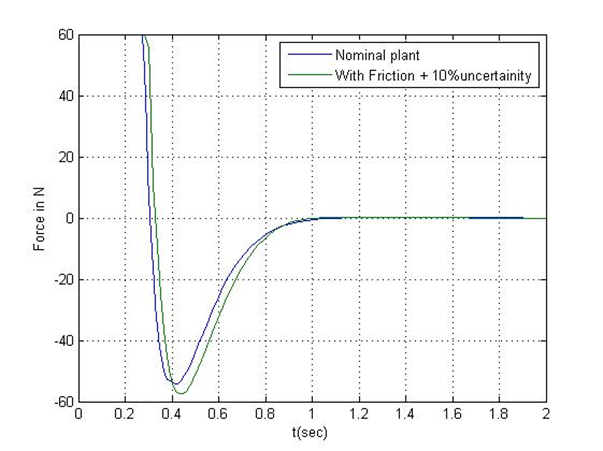
[picture p32: Chapter4/fig/SteerEffort.png]
		 
		\caption{Control effort}\label{fig:SteerEfort}
	\end{minipage}
	%\caption{Actuator effort}
\end{figure} 
The simulation results establishes that with $10\%$ error in plant parameters there is practically no deviation in the performance of the controller. The results also predicts a settling time of $0.8~sec$ for the system. It may be noted that the roll velocity of the wheel does not affect the dynamics of the steering system as is indicated by the absence of $\dot\theta_4$ and $\dot\theta_5$  from Equation \ref{eqn:SteerDyn} .
\section{Summary}
In this chapter, the dynamic equations were derived for  the most general form of passive wheel configuration. Even though  only two passive wheel configuration was considered the same formulation can be extended to any number of  wheels. It is shown that the  dynamics of standard caster wheels is a special case of the  general case with $d_1=0$. It is also proven why a caster needs  non-zero caster offset. There is a  need of extra actuator in case $d_2=0$. 

NOC based approach to model wheel slip in dynamics of a mobile manipulator was presented in this chapter. RARS  being a redundantly actuated system has a inherent tendency to induce slip in the wheels if their velocities and orientations are not synchronised. A simulation study of RARS was carried out to assess the effect of  wheel slip on its dynamics. 

The steering mechanism was modelled separately. Simulation was used to find the   controller parameters which makes the system marginally damped. This ensured that there is no over steering while keeping the settling time small. These controller parameters were later used to tune the actual system.
