amarendas/PhdThesis/Chapter8/conc.tex

\chapter{Conclusions}
\label{ch_8:Con}

\section{Thesis Summary}
This thesis describes the design, development and experimentation of a customized mobile manipulator developed at Bhabha Atomic Research Centre (BARC), Mumbai, India  for mapping radiation in different areas of Cyclotron building where human access is restricted during Cyclotron operation. The customized mobile manipulator is a four wheeled mobile robot with a vertical lifting platform on which the radiation detector is mounted. The mobile manipulator or  platform has two rear wheels individually  coupled to   two motors and the front two wheels which are mutually connected using a motorized Davis steering mechanism.

The mechanical design was obtained in Chapter 3,  and through optimization  of steering mechanism, minimum turning  radius of 415 mm was achieved  while maintaining the over all size constraint of the mobile platform. The optimal location of the CG for  the mobile manipulator was decided so as to provide maximum traction as well as  stability over $30^o$ ramp.  Among  different lifting platforms for the  vertical motion to the sensor for scanning, a simple scissor based lifting platform was chosen due to several advantages it offers. 

The kinematic and dynamic modeling of the customized mobile manipulator was presented in Chapter 4, where the method based on the  Natural Orthogonal Complement was used to derive the dynamic equations of motion of the wheeled mobile robot under study. This analysis highlighted the  effect of caster  offsets on the maneuverability of a mobile robot. The need of having a positive drive for certain castor offsets were also brought in the analysis. 

Control structure for intuitive teleoperation of the mobile robot was presented in Chapter 5. This chapter proposed a  user interface at the operator's side, along with the hardware and software required for the teleoperation. The control algorithm running on the robot's on-board computer was also presented. The contribution there was that it synchronizes all three motors; two in velocity control  and one in position control mode (steering). In spite of difference in response time, Ackerman relation for wheel rolling was always satisfied. 

The developed mobile robot was controlled by an operator who was  physically separated from the mobile manipulator. A dedicated wireless network and the video signal of the remote environment from the robot's on-board camera was available. The limited bandwidth resulted in the delay of the video. 
Chapter 6 dealt with the simulation of a tele-operation for the mobile robot under time delay.
 A mathematical model of the human operator based on pure pursuit algorithm was presented. 
 The simulation  predicted instability with increase in time delay and linear velocity of the mobile robot.
  These studies qualitatively matched with the operator behaviour under similar conditions.

   Note that the time delay in the video feedback affects the efficiency of the operator. 
   In order to overcome this, predictive display was proposed.
   In Chapter 7,  a new methodology was presented for the predictive display based on the 3-D model generated using the RGB-Depth data provided by a Kinect Sensor mounted on the mobile robot and the predicted position of the robot based on dynamic model of the robot presented in Chapter 4.
   This novel method did not require  the 3-D model of the remote environment known before hand as reported in the literature earlier.
   This flexibility allowes the tele-operation of  the mobile robot in an unknown environment. 
   
   In summary, a mobile manipulator was successfully conceived, designed, assembled and controlled remotely  for the purpose for which it was intended, i.e, to map the radiation of a given area.
   
   \section{Current Status} 
   A prototype of  mobile manipulator and its tele-operation system were   manufactured and assembled at BARC, Mumbai, India based on the analysis and algorithms presented in this thesis. The robot was lab tested and the video of the same can be accessed on at the following link \url{ https://youtu.be/B5OngfLQjo4} using the QR code shown in Figure \ref{fig:QR} or \url{http://web.iitd.ac.in/~saha/amaren.mp4} using the QR code shown in Figure \ref{fig:qrcode2} . The system will  shortly  be deployed at Variable Energy Cyclotron Centre (VECC) at Kolkata, India for the same purpose. 
   
    \begin{figure}[ht]
   	\begin{minipage}{.5\textwidth}
	\centering
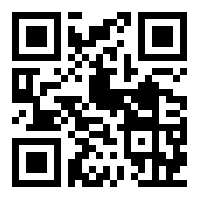
[picture p65: Chapter8/figure/qrcode.png]
	
	\captionof{figure}{QR code Youtube}
	\label{fig:QR}
   	\end{minipage} 
   	\begin{minipage}{.5\textwidth}
   		\centering
   		
   		\captionof{figure}{QR Code alternate}
   		\label{fig:qrcode2} 
   	\end{minipage}
   \end{figure}

\section{Future Scope }
The testing and evaluation of teleoperation system during actual trial opened up  further scope of improvement. Few of these are listed below:  
\begin{itemize}
	\item [(i)] Detection of slip and estimation of slip parameters using inertial sensors such as gyroscope and accelerometer  mounted on the mobile robot  in combination with wheel odometer. 
	
	Several algorithm are available in the literature which uses sensor fusion to arrive at better estimation of robots pose. This estimated pose can then be used to calculate the estimated real time slip based on the actual wheels encoder readings. Based on the estimated slip and using the slip model presented in Section \ref{sec:slipDynamics}, actual slip parameters can then be estimated. 
	
	\item[(ii)]  Pose estimation using encoder mounted on the front passive wheels for slip detection.
	
	 The two front wheel are passive wheel, which in general will undergo less slip than the actuated wheels. On flat terrain and with wheels with low inertia they can give a better estimate of the robots position. Since the contact point of the two wheel keep changing with respect to the robot body an algorithm based on kinematics of of the steering linkage can be worked out to give the position of the robot body based on the odometry of theses wheels. It needs to be seen if this in combination with the  inertial sensors can produce better estimate.
	
	\item[(iii)] Semi-automated navigation using intermediate goal point.
	
	  In this mode the operator will give goal point/s on the screen. This 2D point on the screen would then be mapped to the 3-D point in the actual environment. A planing algorithm will then generate a path between the current position of the robot and goal point. This path must to satisfy the minimum turning radius constrain of the mobile robot. This path will then be feedback to the robots on board controller. A local tracking controller will then be activated to track the path. 
	
	\item[(iv)] Texture mapping of predicted  visual image instead of 3-D point cloud model currently used. 
	
	Since the color of the environment is also available along with its distance an algorithm needs be  developed or existing algorithm implemented   which will use the 3-D point cloud which contains the distance information  and the colour to produce surface with texture.  This will give a more natural feel of the environment to the operator.

	\item [(v)] Force feedback to the operator for estimation of obstacle location in the remote environment.  
	
	This can be achieved using ultrasonic sensors mounted on the periphery of the robot. Once obstacles comes too close to the robot, the distance of the obstacle from the robot will be transmitted to the control station. The software at the operator side then will give some vibratory input to the steering wheel. The amplitude of vibration should be function of the distance of the robot from the obstacle, the heading direction and the speed of approach. A proper function to give intuitive feel to the operator has to be worked out.
\end{itemize}
