amarendas/PhdThesis/Extra/Bio_AH.tex

\chapter*{Brief Bio-data of the Author}

%Abdullah Aamir Hayat received his Bachelors of Technology in Mechanical Engineering from the from the Zakir Hussain College of Engineering and Technology (ZHCET), AMU, Aligarh, in 2009 and Masters of Technology in the year 2011. He joined Ph.D. in 2011 at the Department of Mechanical Engineering at Indian Institute of Technology Delhi as a Ph. D. scholar. 

%He also worked as a Junior Research Fellow (JRF)  at the Programme for Autonomous Robotics (PAR) Laboratory under the project ``Adaptive Force Control of an Industrial Robot equipped with Force/Torque sensor'' granted by BARC/BRNS Mumbai.
