amarendas/PhdThesis/PhDThesisAPD.pdf

### DESIGN AND CONTROL OF TELEOPERATED MOBILE

### PLATFORM

AMAREN PRASANNA DAS

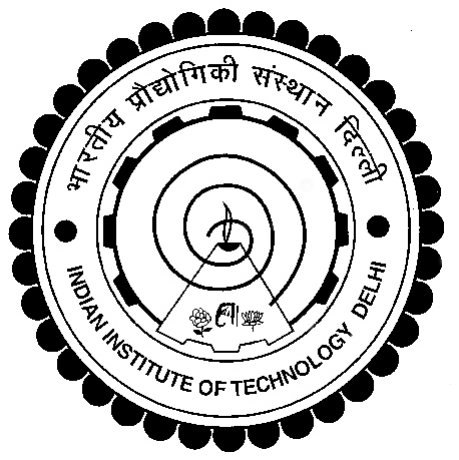
[picture p68: figure]

DEPARTMENT OF MECHANICAL ENGINEERING

INDIAN INSTITUTE OF TECHNOLOGY DELHI

DECEMBER 2018

©Indian Institute of Technology Delhi (IITD), New Delhi, 2017

### DESIGN AND CONTROL OF TELEOPERATED MOBILE

### PLATFORM

by

AMAREN P DAS

Department of Mechanical Engineering

Submitted

in fulfilment of the requirements of the degree of Doctor of Philosophy

to the

INDIAN INSTITUTE OF TECHNOLOGY DELHI

DECEMBER 2018

## Certificate

This is to certify that the thesis entitled DESIGN AND CONTROL OF TELE

OPERATED MOBILE PLATFORM, submitted by Shri. Amaren Prasanna

Das to the Indian Institute of Technology Delhi, for the award of the degree of Doctor

of Philosophy in Mechanical Engineering, is a record of the original, bona-fide research

work carried out by him under my supervision and guidance. The thesis has reached the

standards fulfilling the requirements of the regulations related to the award of the degree.

The results contained in this thesis have not been submitted in part or in full to any

other university or institute for the award of any degree or diploma.

Prof. S. K. Saha | Dr. S. Bhasin
Professor | Associate Professor
Department of Mechanical Engineering | Department of Electrical Engineering
Indian Institute of Technology Delhi | Indian Institute of Technology Delhi
New Delhi - 110016, India | New Delhi - 110016, India

Dr. D. N. Badodkar

Ex-Group Director RDDG

Bhabha Atomic Research Center

Mumbai, India

## Acknowledgements

Thanks to every one for your help.

Amaren P Das

Abstract

XXXXXXXX xx xxxxxxxxxxx XXXX

v

# Contents

1 Introduction | 1
2 Literature Review | 7
3 Design of Mobile a Robot | 15

vii

4 Dynamics of Wheeled Mobile Robots | 27

4.1 Modeling using the Natural Orthogonal Compliment (NOC) . . . . 28

5 Control of Mobile Manipulator | 45

viii

6 Simulation of Tele-operation | 59
7 Dime Delay Compensation and Predictive Display | 69
8 Conclusions | 71
Bibliography | 74
A Simulation Time Delay Tele-operation | 83
B Dynamics | 85

ix

# List of Figures

1.1 Robotics in Factory | | 2
1.2 Health Care | | 2
1.3 Exploration and surveillance | | 2
1.4 Honda Asimo | | 2
1.5 Sony Abio | | 2
3.1 3-D Model of the mobile manipulator | 16
3.2 Photograph of the actual System | 16
3.3 Rear Suspension | 19
3.4 Mobile Manipulator on slope | 19
3.5 Ackerman Steering Condition | 21
3.6 Davis Steering Gear | 22
3.7 Steer Torque | 22
3.8 Scissor Mechanism | 24
4.1 WMR-Std. Castor | 31
4.2 WMR-general | 31
4.3 Castor wheel configuration of a WMR | 31
4.4 Path Traced by Robot | 40
4.5 Inverse dynamics of the mobile robot | 42
5.1 Control architecture | 45
5.2 Data from PC to the robot | 46
5.3 Data from the robot to PC | 46

xi

5.4 Wiring diagram of the WMR | 47
5.5 Block digram of EPOS4 controller | | 48
5.6 Current control block | | 49
5.7 Velocity control bolck | 49
5.8 Position control bolck | 50
5.9 Block digram of WMR controler | 51
5.10 Ackerman Steering Condition | 53
5.11 Davis Steering Gear | 53
5.12 Tracing a line | 55
5.13 Motor torque | 55
5.14 Linear velocity | 55
5.15 Angular velocity | 55
5.16 Tracing a circle | 56
5.17 Motor torque | 56
5.18 Linear velocity | 56
5.19 Angular velocity | 56
5.20 User interface for teleoperation | 57
6.1 Teleoperation architecture | 59
6.2 Assumed driving strategy | 61
6.3 Geometry of Pure Pursuit | 62
6.4 Simulation Scheme | 63
6.5 Block diagram for teleoperation | 64
6.6 Simulation with no time delay in either direction | 65
6.7 Simulation with time delay h1 = .5sec and h2 = 0 | 66
6.8 Simulation with time delay h1 = .8sec and h2 = 0 | 67

xii

# List of Tables

3.1 Key parameters and specifications of the mobile manipulator. . . . 16

4.1 Dynamic & kinematic parameters | 42
5.1 Proportionality constant table | 48
5.2 Parameters for left and right rear wheel motor controllers | | 50
5.3 Parameters of steering motor controller | | 51

xiii

## Important Symbols and Abbreviations

The important conventions, symbols and abbreviations used in this thesis are

listed in the alphabetical order.

Conventions | Description
italic | Scalar quantities in lower-case lightface italic with Latin/Greek letters
bold | Vectors are in lower-case boldface Latin/Greek letters

CAPITAL BOLD Matrices are in upper-case boldface Latin/Greek letters

Latin letters Description

At | State transition matrix at time t

ai

, αi bi

, θi | Represents four DH parameters namely, Link length, twist angle,
| joint offset and joint angle, respectively.
Bt | Control input matrix at time t
C, Ci | Matrix of Convective Inertia (MCI) terms associated with
| the complete system and the i th subsystem, respectively
fv | Viscous friction coefficient at the joint of robotic manipulator
fc | Coulomb friction coefficient at the joint of robotic manipulator
x, xˆt|t−1 | State vector and its estimate at time t with data upto time (t − 1)

### 0 Column vector of zeros or null vector with compatible size

| to the dimensions of the matrices and vectors where it appears

### 1 Identity matrix of size compatible to the dimensions of the matrices

| where it appears

xv

Greek letters Description

αi | Twist angle of k th link (DH parameter)

θi

,

˙θi
,
¨θi | Relative joint displacement of the i th link, its rate, and
| acceleration, respectively, in a closed-loop system

θi

, θ˙
i
, θ¨i | Vector of relative joint displacement of the i th link, its rate, and
| acceleration, respectively, in a closed-loop system
χb | Vector of base parameters in dynamic model
λ | Lagrange multiplier representing constraint forces
ωi | The 3-dimensional angular velocity vector of i th link

Acronyms

AMM | Aruco Marker Map
ANOVA | Analysis of Variance
VTM | Velocity Transformation Matrix

Functions/Operators

κ(M) Condition number of matrix M

det(M) Determinant of matrix M

diag(v) Element of vector v at diagonal position of a matrix

xvi

# Chapter 1

# Introduction

The use of robots such as robotic arm figure 1.1 has been used in factories for a

long time, basically for repetitive kind of job. Though it started with the inten-

tion to reduce human labour, production cost, and increased productivity, with

technological development, their scope has expanded beyond manufacturing do-

main. Robots are now being used for health care, surveillance, exploration, etc as

illustrated in figure 1.2 and1.3. The reduction in development cost has resulted

in introduction of robotic systems in entertainment industries and personal care

as well. Robots have matured from heavy duty serial linked mechanical arms to a

more presentable form such as ASIMO 1.4by Honda and Aibo by Sony 1.5.

In areas where human access is not preferred or restricted due to risk of life

or inhospitable environmental conditions such as which exists in chemical, space

or nuclear industries, robotic systems have gained huge popularity in providing

services as surveillance, rescue, exploration and remote maintenance. Research in

teleoperated and autonomous mobile robotics has been fuelled largely by these

requirement. Teleoperated mobile robots are suitable for these applications as the

work space required to be covered is very large, and it is essential to maintain

physical separation between the robot and its control station. Moreover, the

remote environment is in general unknown.

This research too was motivated by a similar requirement for in-situ mea-

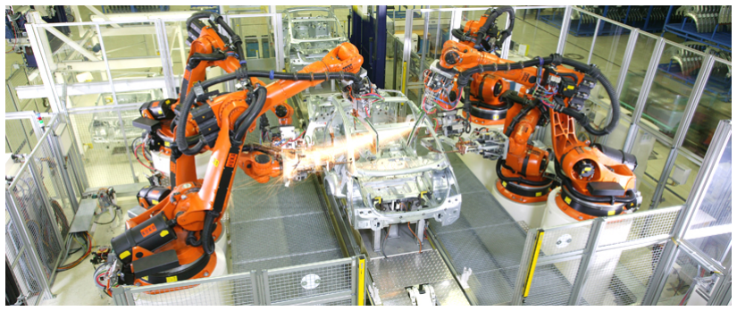
[picture p69: figure]

Figure 1.1: Robotics in Factory

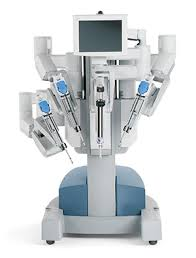
[picture p70: figure]

Figure 1.2: Health Care


Figure 1.3: Exploration and surveillance


Figure 1.4: Honda Asimo

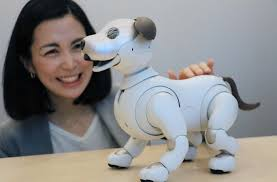
[picture p71: figure]

Figure 1.5: Sony Abio surement of the radioactive radiation, mostly neutron field, inside the vault and

cave areas of K-130, K-500 and Medical Cyclotron operational at VECC, Kolkata,

West Bengal. Cyclotrons are used to accelerate charged particle beam to high en-

ergy. These are required for experiments in nuclear physics and nuclear medicine.

The particles are accelerated to high energy using a high frequency alternating

voltage which is applied between two hollow "D"-shaped sheet metal electrodes

called "Dees" inside a vacuum chamber. The area surrounding the Dee is called

the vault and cave is the areas where beam line (beam of accelerated particles) is

available for experimentation. Radiation mapping of these areas are mandatory

requirements for getting safety clearance from regulators during commissioning of

new units and at regular intervals during operational life of the cyclotron facility.

Though there are radiation detectors placed at different locations in these area

they can only measure radiation levels at discrete location but can not provide

the 3-D radiation map. The advantage of having a radiation map is that it provide

detailed input to health physicist of the dose a person may receive and accordingly

plan emergency operations. These maps also provide the plant operators with the

location of radiation leakage and accordingly tune there system to improve its

efficiency.

The challenge faced for in-situ inspection during operation of cyclotron is that

the interaction between an accelerated beam of charged particles and the target

produce Bremsstraghlung and characteristic x-rays, prompt γ-rays, neutrons and

delayed radiation (β and γ) thus making human presence unacceptable. A tele-

operated mobile robot with wireless communication link is the obvious solution.

This thesis discusses design analysis and develop of a prototype robot to carry out

in-situ measurement and mapping of radiation level.

## 1.1 Research Contributions

The original contributions of the present research are listed below:

(i) Design of a customized teleoperated mobile robot for remote surveillance and

mapping application.

(ii) Development of kinematic and dynamic model of the robot at hand.

(iii) Control architecture required for intuitive teleoperation of this mobile robot.

(iv) Predictive visual feedback control to alleviate problem arising due to time

delay.

## 1.2 Thesis Organization

The thesis contains eight chapters and one appendix. They are organized as

follows:

Chapter 1: Introduction

This chapter, discusses the scope of mobile robotics in general and the motivation

which led to this research work.

Chapter 2: Literature Review

This chapter presents the literature review in the following areas: kinamatics and

dynamics of mobile robots, control of mobile robot, control for time delay systems,

performance of operator under teleopreration, and predictive display systems.

Chapter 3: Design of a Mobile Robot

This chapter highlights the design considerations of tele-operated mobile robot

based on mission requirements and environmental conditions. It will discusses

the mechanical design for the traction system, the steering gear and the scissor

mechanism. Selection of steering system based on terrain condition and power

requirement is also discussed.

Chapter 4: Mathematica Modelling of Wheeled Mobile Robots

In this chapter, the orthogonal compliment method will be presented to derive the dynamic equations of a four wheeled differentially driven platform. The platform

has two actuated wheels and two passive wheels. Different types of passive wheels

were studied and corresponding dynamic equations were derived.

Chapter 5:Control of mobile manipulator

The control architecture and the hardware used for tele-operation is presented

along with the detailed description of implementation of the controller software at

both the remote (mobile robot) and the local station. The experimental results

of robots position based on wheel odometry and is torque requirement for few

predefined paths are presented. A comparison study with the simulated results

based on dynamic analysis is also presented presented.

Chapter 6: Simulation of Tele-operation

In this chapter, simulation of a teleoperated mobile robot is presented both without

time delay and under time delay due to communication link. It is shown via

simulation that with increase in time delay teleoperation loop become unstable.

Chapter 7: Predictive Display

In this chapter, we propose a Predictive Display strategy to counter the time delay

in video feedback by extrapolating in time the camera view based on the predicted

position of the robot at remote location.

Chapter 8: Conclusions

This chapter summarizes major results of this research work. Limitations along

with the future scope from the present experiences are also addressed.

Bibliography

Appendix A: Measurement of Time Delay in Video Feedback

Here the experimental set up and methodology used to determine the time delay

is presented. In this appendix,

# Chapter 2

# Literature Review

In this chapter we discuss some of the important works published pertaining to

the scope of this thesis. Few of the techniques and methods published in these

literatures are directly used. The section on special purpose robot list literatures

which were reviewed to arrive at the over all design of the mobile robot. The

dynamic analysis of the mobile platform was based on the work cited in section

Mathamatical modeling of Mobile Robot. The literatures discussed in Path tacking

algorithm section was used to arrive at the "human model" proposed in the thesis

for simulation of teleoperation. The section on Teleoperation discusses literatures

in a much broader sense, such as force feedback, haptic interface design etc.,

than what was adapted in this thesis. This was done for completeness of the

subject. Last section on Predictive Display though a part of human interface for

teleoperation is discussed separately, because it forms one of the major component

of the teleoperation system network designed for the mobile robot presented in this

thesis.

## 2.1 Special Purpose Mobile Robots

This section discuss some of the special purpose and customized robots built for

various typical applications. Design and fabrication of a low cost, solar powered

mobile robot for scientific missions on the Antarctic plateau is presented by Ray

[1]. Honeycombe-glassfiber composite is used to provide high strength and low

weight. Ohno, et al. [2] developed a robotic control vehicle for measuring the

radiation in the Fukushima Daiichi Nuclear Power Plant. Briones [3] presents

a vacuum cup based wall climbing robot for inspection of nuclear power plants.

Galt [4] has developed eight legged teleoperated mobile robot for use in nuclear

industry. Development of magnetic wheel based mobile robot for painting of ship is

discussed by Cho [5]. Compliant link based mobile robot was designed and tested

by Borenstein[6], in which author claims that due to its unique design, better

dead-reckoning accuracy is achieved compared to other contemporary designs.

This vehicle has two independent drive units or "trucks" that are free to rotate

about a vertical shaft connected to the vehicle body. Each truck comprises two

drive motors on a common axes and forms a differential drive system.Mechanical

compliance is implemented by means of a linear bearing that allows relative motion

between the front and rear truck. Other literatures giving details of mobile robots

based on differential wheel, traction belt and omnidirectional wheel are given in

the introductory part of chapter 3.

## 2.2 Mathematical Modeling of a Mobile Robot

A very comprehensive list of wheeled mobile robots using different wheel config-

uration is given by Muir and Neuman [7]. In this work kinematic equation of

conventional, omnidirectional and ball wheels is presented.The kinematics of the

WMR is derived by combining the kinematic information of individual wheels .

Detection of wheel slip based on error in the least square solution is also discuses.

Similar issues are addressed ny Alexander in [8], the major difference is that it uses

physical friction model in there analysis in case rolling constrains are not satisfied

in case of over actuated systems. A seminal work by Champion [9], gives the struc-

tural classification of wheeled mobile robot based on the degree of mobility, δm,

and degree of steeribility, δs, define there-in based on the number of conventional fixed wheels and conventional centered orientable wheels. According to them any

WMR fall in one of the 5 categories given by (δm, δs) → (3, 0),(2, 1),(1, 1),(1, 2).

The configuration and posture kinematic models of each type is derived. Based on

dynamic model, the minimal number of actuators required for full maneuverabil-

ity of each type is presented. Kinematic analysis of omi-directional over-actuated

mobile robot is presented in [10]. Two different method of forward kinematics is

discussed along with singularity analysis. Actuator switching scheme based on

load distribution to avoid singularity is also described.

Dynamic modeling of mobile manipulator can be categorized as: force based i.e

the Newtaon-Eular (NE) formulation and energy based as Eular-Lagrange (EL)

. Hoostmans [11] used NE method to arrive at the dynamic model of mobile

manipulator that has two link mounted on a mobile platform. Chung [12] used

EL method to arrive at the equations of motion for mobile manipulator. Geometric

mechanics was used to adapt Luh and walker [13] algorithm by Boyer and Ali [14]

for recursive inverse dynamics formulation for wheeled systems.

Orthogonal compliment method utilizes the advantage of NE and EL approach

to derive the equations of motion for a multibody dynamical system. It uses the

fact that motion can take place only in the null space of the constrain inducing

matrix A defined as Ax = 0, where x is a vector independent co-ordinates. The

orthogonal compliment of the constraint inducing matrix A is used to eliminate the

non-working constraint forces and moments from the equations of motion. Angles

and Lee [15] used natural orthogonal compliment method to derive the equations

of motion for holonomic mechanical system. In this, orthogonal compliment was

derived from the velocity constraints naturally, hence the name. This was used by

Angeles [16] and Saha in [17],[18] to derive equations of motion for WMR.

## 2.3 Path Tracking Algorithms

Path tracing algorithm for control of mobile robots is used to arrive at the mathe-

matical model of human operator for simulation of tele-operation loop in chapter

6. Geometry based path tracking algorithms are most intuitive and hence suitable

our application. The major algorithms in this category reported in literatures is

pure pursuit [19], follow the carrot [20], vector pursuit [21], and follow the past

[22]. In pure-pursuit [19], the steer angle of the robot is set so that the robot

moves in circle to reach a goal point on the desired path. The goal point is based

on the "Look Ahead Distance", which is practically the maximum distance one

can see from the current vehicle position. Corrective action is based on position

error of the vehicle, orientation error is not taken into account explicitly.

In case of "Follow the Carrot" method [20] the steering angle is set propor-

tional to the orientation error. The orientation error is defined as the difference

between the current orientation of the vehicle and the orientation required from

the present position of the vehicle to reach the goal point on the referance path.

The proportionality constant is decide based on trial and error.

The two previous geometric path tracking techniques only generate steering

commands based upon the goal point on the reference trajectory to be traced.

Hence, the requirement of vehicle posture control for accurate trajectory following

remains unsatisfied. Even though, the path orientation and curvature are known

at the reference point, an improved path tracking strategy such that the vehicle

arrives at the reference point with the correct orientation and curvature is sug-

gested by Wit in [21]. Wit uses Screw theory to find the error between the current

Screw and the required screw at the goal position.

Hellstrom [22], has proposed an algorithm which uses the knowledge of previ-

ously recorded steer angle, associated with the path traced earlier. In this algo-

rithm, the steer angle of the vehicle is set based on the orientation error, position

error and the past recorded steer angle. A recent survey by Paden [23], provides

extensive review of other control strategies for path tracking of autonomous unmanned vehicles such as, those based on Lyapunov method, Model Predictive

Controller, adaptive control etc.

## 2.4 Tele-operation

Tele-operation deals with connecting human operator and the robot in order to

reproduce human action at distance. Tele-operation is in general bidirectional or

bilateral as the human needs to have a feedback in order to understand the results

of his action and to perceive the remote environment. It started with its use in

nuclear and space industries [24, 25], but now it is used in underwater exploration,

surgery, live-power line maintenance, mining etc. all characterized by reducing the

risk to human operators. The two major research areas are the "human interface"

and "control" design.

### 2.4.1 Human Interface

Human interface is a means through which the operator interacts with the remote

robot by perceiving the remote environment and sending commands accordingly.

Thus, the human interface has two important purpose; one to excite the human

senses to show the action of the executed task and to process the human command

properly to execute it at the remote end. Force and haptic feedback of remote

environment drastically improves operators performance. A serial link haptic de-

vice PHANTOM [26] was developed at MIT during 1994, to provide 3-DOF force

feedback for haptic(touch feedback) purpose. DELTA Haptice Device described in

[27] provide 6-DOF force feedback with moderate force. Clover [28] has reported

use of off-the-shelf serial industrial robots for haptic realization of tasks requiring

a large workspace and high force capability. Customized 10-DOF haptic device

is reported for similar purpose in [29]. Design of 6-DOF parallel mechanism for

force feedback is discussed in [30].

Another major form of human interface is the visual feedback, the main challenge is to provide depth perception of remote environment. Most stereoscopic

systems used in telerobotics are based on shutter glasses [31, 32], head-mounted

displays [32] or polarized images [33]. Systems based on shutter glasses hide user‘s

eyes alternately in synchronization to screen refreshment, which projects images

for left and right eye alternately. A second type of interfaces is based on polarized

images. The user is also required to wear glasses that filter the left and right

images. The third type of interface are the head mounted display such as "Google

cardboard", especially designed to immerse users into virtual environments, where

the left and right images are projected to each eye using two separate screens or

split screens.

### 2.4.2 Control

Control of tele-operetion system deals two issues, transparency and stability. Trans-

parency deals with what information is to be exchanged between the remote and

local station, so that the operator can have a natural feel of the remote environ-

ment. A position-position architecture is suggested by Goertz [34], where master

position is passed as a command to the slave servo (position) controller, and slave

position is returned to the master as a position command. A position-force ar-

chitecture has been proposed by Flatau [35] in this the master sends the position

to the slave and the slave sends back the force felt by it in the remote environ-

ment. A general 4-channel architect has been suggested by Lawrence [36], and

transparency as measure of performance in teleoperation has been defined and

evaluated for different architectures.

An excellent survey article on control of bilateral teleoperation is given by

Hokayem & Spong [37]. Few of these are briefly presented here. A teleopera-

tion system, comprised of a master and slave with their corresponding controllers,

residing between the human operator and the environment, which can be mod-

eled as a two port network. Passivity based design of stabilizing control using

wave-variable concept and scattering theory has been proposed by Anderson and

Spong [38], Rebelo [39] and Anderson and Slotin [40] etc. Port-Hamiltonian based

approach has been used in [41, 42]. Design of controller for time delayed sys-

tems based on back-stepping method in combination with partial differential heat

equation is studied by Kristic [43].

## 2.5 Predictive Display

Delays are inherent in teleoperation over wireless network. Practically much of

the delay is due to relay stations and limited network bandwidth. As little as a

half second delay in the visual feedback significantly reduces human performance

[44]. The operator tends to adopt an inefficient "move then wait and see" policy

in order to complete the task.

To over come performance deterioration of operator due to time delay in visual

feedback two approaches have been reported in literature namely supervisory con-

trol or tele-assistance and predictive display. In supervisory control [45, 46, 47]

the robot is partly guided by operator by giving the robot intermittent commands

to achieve the goal. The drawback of such system is that operator looses direct

contact of the task. In predictive display systems, a natural and widely used tech-

niques, synthesised view of the remote environment is displayed to the operator

based on his movements. It has been used for space teleoperation as early as in

1993, as reported by Sherdan [48], Bejczy [49] and Kim [50]. Where as the above

two used a-prior modeling and calibration of remote environment, Jagersand [51],

used delayed visual feedback and operator control signal to build predicated image

which was presented to the operator. The system was implemented with a fixed

remote environment with a manipulator arm with two wall mounted cameras. An

estimation function was proposed Ii ≈ φk(xi), i ∈ 1, ..k, which approximates each

image Ii seen so far on the trajectory x1, x2.....xk. Camera mounted on manip-

ulator (eye-in-hand) based image predication method has been discussed using

uncalibrated monocular camera by Yeres [52] and Deng [53]. Multiple sensors based dense 3-D map of remote has been reported by Kelly [54] and [55]. While

Kelly used fusion of lidar camera data, Burkert used stereo cameras. Hu [56] has

used SLAM based Predictive Dispalay (PD)system for telemanipulation of mobile

robot. In this approach texture and geometry of the remote site is transmitted

instead of video stream. This the author claims reduces bandwidth utilization.

# Chapter 3

# Design of Mobile a Robot

Most of the mobile robots presented in literature uses differential wheel drive

with passive castor, as in [57], [58] and [17]. The other common methods for

locomotion of mobile robots are the omnidirectional wheels [59] and [60], and

tracked wheel system [61] and [62]. According to Nagatani [63], a vehicle with

Mecanum wheels is susceptible to slippage and same is the case for tracked vehicle,

which are inherently skid steered. The slippage of the wheels prevents the most

popular dead-reckoning method using rotary shaft encoders from being performed

well. This chapter discusses the design methodology of a novel mobile manipulator

based on environmental requirements. We also highlight the advantage of the

Davis steering mechanism over castor wheels or other steering methods from the

perspective of this mobile manipulator. The Davis steering system modifies the

heading of front wheels in a way that, at low speeds, all the wheels are in pure

rolling without lateral sliding [64].

## 3.1 Design Overview

The objective of a mobile robot under consideration is to navigate inside the cy-

clotron vault and collect radiation intensity data at all the required points decided

by the operator. Data is to be collected not only at different planer locations of

the floor but also at varying height from the floor. To cater to this operational


Figure 3.1: 3-D Model of the mobile manipulator


Figure 3.2: Photograph of the actual System

requirement, a mobile platform with a vertically extendable manipulating arm was

developed as shown in Figures 3.1 and 3.2. Together, they are referred henceforth

as mobile-manipulator. The 3-D model of the mobile-manipulator with its major

subsystems are shown in Figure 3.1, whereas and the actual system is shown in

Figure 3.2.

The environmental condition required that the vehicle be either autonomous

or teleoperated. To keep the complexity low it was decided to have wireless tele-

operated navigation and control. This gives an operator full flexibility to drive

and control the system from a remote station using visual feedback provided by

the on board camera. The key parameters of the mobile manipulator are listed in

Table 3.1.

Table 3.1: Key parameters and specifications of the mobile manipulator.

Weight | 70 Kg | without payload
Payload | 10 Kg | —
Footprint | 700 mm × 400 mm -
Height Collapsed | 500 mm | Along Z-Axis
Height Extended | 1500 mm | Along Z-Axis
Steering mechanism | Davis Steering | –
Turning radius | 415 mm | -
Ground clarence | 45 mm | –
Maximum traction speed 2 m/min | On flat terrain
Ramp climb angle | 30◦ | Checkerboard surface

The mobile-manipulator has a footprint of 700 mm x 400 mm based on the

narrow passage through which the system has to negotiate. These passages are formed inside the vault area by the pipelines and structural supports of the cy-

clotron and its associated equipment. Two DC motors,with speed servo controller,

provide the traction to each rear wheels. The two front wheels are inter-connected

with a Davis steering mechanism [65]. A scissor mechanism provides the vertical

motion of the detector that is mounted on the manipulating arm.

In order to keep the self weight of the system small all the structural parts

are made of aluminum alloy AL6061, apart from the base frame. Stainless Steel

(SS304) angle sections was used for the base frame, which give it excellent strength

to weight ratio.

## 3.2 Design of the Traction System

Traction is provided by the two rear wheels driven independently. This makes the

system over actuated. A mechanical differential connecting the two rear wheels, as

used in cars, would overcome this. It was not proposed to do so as the proposed

vehicle is planned to be teleoperated in a environment inaccessible to humans.

This calls for a single-failure-safe design. The proposed design gives two major

advantages. Firstly, in case one of the wheel loosing contact with the ground due to

overhang in small pits or while over an obstacle, the mechanical differential system

would keep supplying power to the free hanging wheel. The system will hence get

stuck, maybe in an unrecoverable location. This situation is avoided in the present

design as the motor having traction can be independently powered, to move the

vehicle. Secondly, using the proposed design, in case of one actuator failure, either

the traction or the steering motor, still the vehicle can be manoeuvred to a safe

location, albeit with dragging of the wheel with failed actuator.

Each wheel is driven by a Maxon DC RE50 200W Motor through a 26:1 re-

duction gearbox. The motors are mounted at an offset to the wheel axis for

increased ground clearance, as shown in Figure 3.3. Spring suspension is provided

at each wheel to ensure sufficient contact force on uneven ground. The diameter of the wheel is 100 mm (Dw), which is sufficient to ride over obstacle of height

20 mm (Max). They are made of Aluminum alloy-6061 with 5mm thick molded

polyurethane (PU) liner. The PU liner provides large traction on cement flooring

while being resistance to wear.

The load distribution was optimized to generate maximum normal reaction,

Fn, at the rear wheels without overturning while moving up the ramp of 30o .

Maximizing rear wheel reaction by increasing "b" as per Equation 3.1 ensures

increased traction, FT = µFN (µ is the coefficient of friction), but at the same

time decreases the stability margin indicated by "X" in Figure 3.4. The static

moment and force balance yield

FN2 =

b
a
FN1, | FN1 + FN2 = mg cos θ | (3.1)

The stability margin X as shoen in Figure 3.2 was fixed as 30mm so as to

achieve maximum acceleration of 0.144g over the ramp of 30o without overturning.

This was done based on the condition of dynamic stability given by

mgb cos θ = (mg sin θ + ma)zcg, ⇒ g(

b

zcg

cos θ − sin θ) = a (3.2)

Where

FN1, FN2 are normal reaction on the front and rear wheels.

a and b are the distance of the vehicle cg from the rear and front wheels.

Zcg is the height of the cg from the plane containing the contact point of the

wheels.

m is mass of the vehicle.

g is acceleration due to gravity.

θ is the inclination of the traction surface from horizontal.

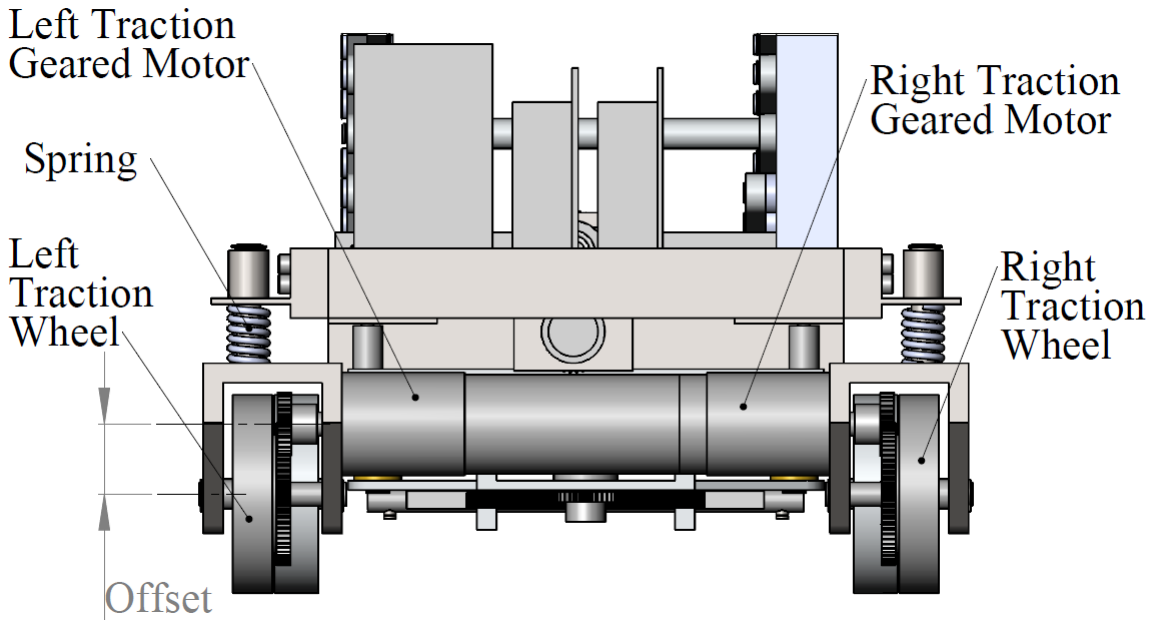
[picture p72: figure]

Figure 3.3: Rear Suspension

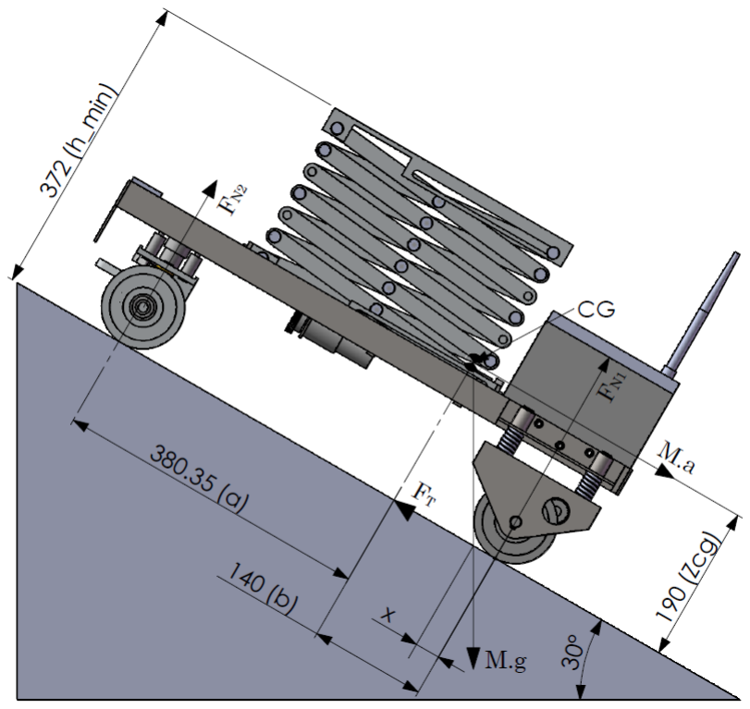
[picture p73: figure]

Figure 3.4: Mobile Manipulator on slope

### 3.2.1 Selection of Motor and Gearbox

The torque requirement for each rear wheel was calculated based on the static

moment balance with the assumption that each rear wheel shares equal load and

the total suspended weight is 80 Kg. From the freebody diagram (Figure 3.4),

using moment and force balance we get the following:

FN1 =

aM cos θ
a + b − µZcg
, | FT = µFN1 | (3.3)

In order to estimate the traction motor size, we take worst case scenario of θ = 30o

and µ = 0.3. This leads to

FN1 = 66Kg, FT = 0.3 ∗ 66 ≈ 20Kg

Since the traction is provided by the two rear wheels, the torque required per

wheel (Tw) is given by

Tw = (FT /2)(Dw/2) = (20/2) ∗ 50 = 500Kg − mm ' 5Nm | (3.4)

The motor torque TM, required based on the assumption of factor of safety, F S =

1.5 is

TM = (F S) ∗ Tw = 1.5 ∗ 5 = 7.5 ' 8Nm | (3.5)

Assuming the maximum speed, Vramp = 1m/s, of the mobile manipulator over a

ramp, the required power, PM, of the traction motor is calculated as,

ωw = Vramp/(Dw/2) ' 200rpm

Pm = ωwTm = 20 ∗ 8 = 160W

(3.6)

The nearest Maxon motor available as per the catalogue [66] is 200W, RE50-

370354 motor. The nominal speed, Ns is 5680rpm. Therefore, the gearing ratio

required is, Ns/ωw = 5680/200 ' 28.4. The nearest gear box available is of ratio

26 : 1, which was chosen.

## 3.3 Design of Steering System

The design objective of a steering system should ensure rolling motion of all the

wheels during every possible manurers of the mobile robot. This is important to

reduce the friction drag due to sliding motion which reduces the energy efficiency

of the mobile robot. In case of four wheeled vehicle with rear wheels fixed and front

wheels steered the condition is shown in Figure 3.5, referred in some literature as

Ackerman steering conduction.

This mobile manipulator uses Davis steering mechanism, Figure 3.6, on the

front wheels. Caster wheels were not used as they tend to align with obstacles

and thus get stuck. On the other hand tracked wheels have excellent rough terrain

capabilities, but is power intensive due to skid steering. another option was to use

Omnidirectional wheels, which need complex controller for coordination and an

extra actuator. Moreover, the operation are are in general not clean of loose small

objects, which may get stuck in between the free rollers of the omnidirectional

wheels. This will reduce the efficiency of the vehicle.

Davis mechanism was chosen over Ackerman steering gear as it satisfies the

steering condition given by Equation 3.7, which ensures pure rolling of all wheels

over the entire steering range. This makes the system suitable for passive wheel


Figure 3.5: Ackerman Steering Condition

odometry and energy efficient. The mechanism being positively driven by position

controlled servo motor does not align with the obstacles and thus are able to

crossover it. The dimensions of the links used in the steering mechanism is given

in Figure 3.6, and are based on the Ackerman steering law given below:

cot φ − cot θ = a/w, 2b h
=

a
w

(3.7)

Where a and b is limited by the over all size of the vehicle, discussed earlier.

### 3.3.1 Minimum Turning Radius

The mechanical construction of this steering mechanism limits the steering angle.

This in turn limits the minimum radius the vehicle can negotiate. Figure 3.5

shows the extreme values of φ and θ, one side of the steering limits. The turning

radius R for a given steer angle θ is calculated by the geometry of Figure 3.6 as

tan θ =

w
P + m −

a
2

and R = m + p

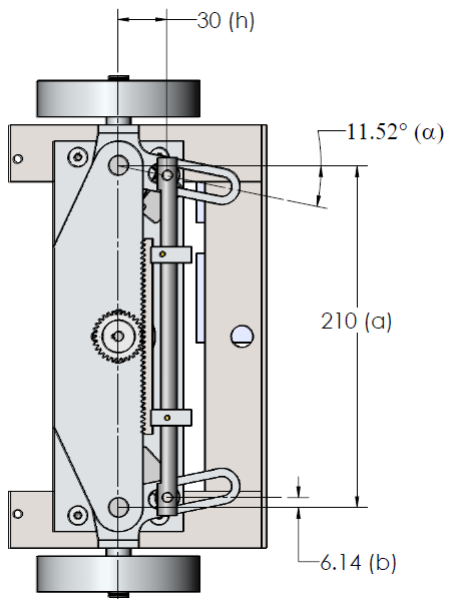
[picture p74: figure]

Figure 3.6: Davis Steering Gear | Figure 3.7: Steer Torque

Substituting R and rearranging the above equation, we get

R(θ) = a
2
+ w cot θ | (3.8)

The extreme value of θ = 60. as shown in Figure 3.5, this gives the minimum

turning radius Rmin as

Rmin =

210
2

+ 515 × cot(60o
) = 402mm

### 3.3.2 Calculation of Steering Torque

The torque required to steer the front wheel is estimated based on a simplified

assumption that the wheel deforms under normal load and the contact area thus

generated is circular in shape with diameter that of the wheel width, Ww, as shown

in Figure 3.7. In order to estimate the normal reaction on each wheel, we assume

that the total weight of 80kg is equally shared by the four wheels. Therefore,

Ns = 80/4 = 20Kg. Next, the uniform pressure formula used for brakes/clutches

design was applied to find the resistance torque Ts, between the ground and the

wheel i.e,

Ts =

Nsµ
3
Ww = 0.4Nm | (3.9)

The resistance torque, Ts, of both the wheels are balanced by the force Fs acting

on the rack as shown in Figure 3.6. The rack is coupled to the steering motor by

a pinion of diameter, Dp = 40mm. The motor torque, Tms
in Equation 3.10 is

calculated with a high factor of safety, F S = 3. This is because TS is estimated

based on a simplified model of brake design. The power, Pms of the steering motor

based on torque Tms and the steering speed ωs of 100rpm is

Tms = (F S)

2Ts
h

Dp
2
= 1.6Nm and Pms = Tms ∗ ωs = 17W | (3.10)

Based on the above specifications, a 20W, RE25 DC motor of Maxon make

and a gear box GP32 of ratio 159:1 was chosen for the steering mechanism.

## 3.4 Design of Scissor Mechanism for Manipulat-

## ing Arm

The manipulating arm was designed to move up to a height of 1.5m from the floor

level. This motion was generated using a scissor mechanism, as shown in Figure

3.8. The scissor mechanism has two major advantages over other lifting methods

such as telescopic pillar, etc. First, the ratio of height in extended and collapsed

condition is very large. In our case it is 3 : 1. Second, the self weight of the

mechanism is less as it is made of rectangular links.

The scissor mechanism, Figure 3.8, has 6 stages, where one "X" denotes one

stage. The Scissor is connected to the top platform by a pivot joint O2 and a

prismatic joint A2. This is coupled to the base frame by pivot joint O1 and a

prismatic joint A1. The linear actuation of joint A1 is provided by a lead screw of

pitch (P) 1.5 mm and mean diameter (dm) 10mm. This results in vertical motion

of the top platform.

The relation between the vertical motion of the platform and the horizontal

displacement of point A!

is given by geometry of the mechanism shown in Figure

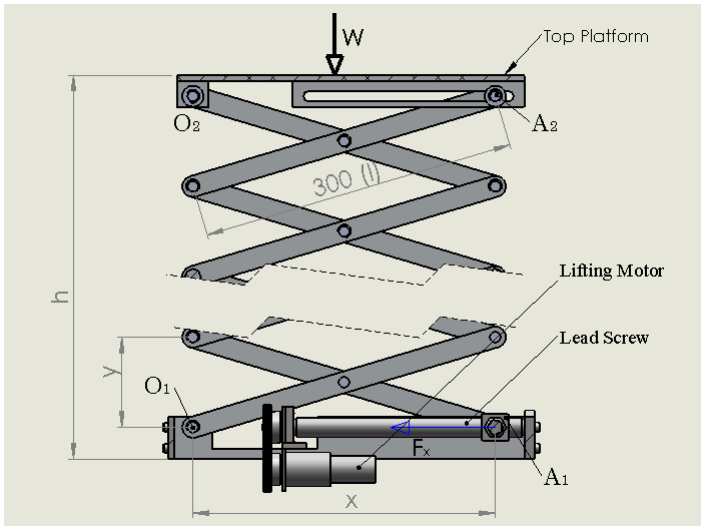
[picture p75: figure]

Figure 3.8: Scissor Mechanism

3.8
y = lsin θ, x = l cos θ, ⇒ dy = l cos θdθ, dx = −lsin θdθ

h = Ny → dh = N dy

(3.11)

where l is the link length, θ the angle of the link with horizontal plane and h the

height of platform.

The number of stages used in the scissor mechanism is N=6. From the principle

of virtual work, we get

−Fxdx = W dh, ⇒ Fx =

W N
tan θ

(3.12)

where, Fx is the axial force on the prismatic joint, A1 and W is the payload. From

Equation 3.12, it is clear that as θ → 0, the force Fx → ∞. In the present design,

θmin = 5o and θmax = 45o
. Therefore, the extended height hmax = Nlsin θmax =

1.3m and the collapsed height hmin = 156mm. Assuming W = 8kg as payload

the maximum force Fx = 342Kg is required at θmin = 5o
, .

The motor torque required for the scissor mechanism is calsulated using screw

jack formula given in [65] and here presented as Equation 3.13.

TL =

Fxdm
2

(

p + πµdm sec α
πdm − µp sec α
) = 7.5Nm | (3.13)

where coefficient of friction assumed, µ = 0.1, ACME thread angle 2α = 60o ,

pitch diameter dm = 15mm and pitch p = 1.5mm is used. Based on the above

specification 10W RE20 DC motor with a gear box of 25:1 ratio was chosen from

Maxon motor catalogue [66].

## 3.5 Summary

Design calculations for the proposed mobile manipulator are presented in this

chapter. Different aspects based on the requirements of radiation inspection

around cyclotron was taken into account. Advantage of positively steered wheels

over caster wheel was highlighted for the proposed mobile robot.

# Chapter 4

# Dynamics of Wheeled Mobile

# Robots

In the field of mobile robotics, extensive research has been carried out. Mobile

robots can broadly be divided into three categorises-wheeled robots, legged robots

[67], and aerial vehicles [68]. There are few mobile robots which use both wheels

and legs for locomotion for example, in Creadapt [69] in order to take advantage

of both modes of locomotion. Among these the most extensively studied are the

Wheeled Mobile Robots (WMR). They have been classified into five generic classes

by Champion etal. [9], [70] based on there mobility resulting from the kinematic

constrains due to different wheel types. The most common among these are the 3

wheeled differential drive WMR with one castor wheel. Because of its simplicity

in modelling, they have been used in most of the control and motion planing

algorithms [71], [72] and [73].

In order to develop a model-based control algorithm it is imperative to have

good dynamic model of the WMR. These dynamic models are used in simulation

software, Software in Loop (SIL) testing and Hardware in Loop (HIL) testing of

the controllers. Different methods have been adopted to derive the dynamic model

of WMRs. A general dynamical model was derived for three-wheel mobile robots

with nonholonomic constraints by B. d’Andrea-Novel [74] using Lagrange formulation. Alternatively Thanjavur and Rajagopalan [75] has used Kane’s method

and Saha et al. [18],[17] used Natural Orthogonal Compliment (NOC) method for

the same.

All the papers known to us use the standard caster wheel in deriving the dy-

namic model of the WMR. In this chapter the modelling is carried out considering

the Castor wheel in the most general configuration. In the stranded castor wheel

configuration the axis of rotation is perpendicular to the line joining the pivot

and the axis of rotation, as shown in Figure 4.1 whereas in this study they are

oriented in the most general way, as shown in figure Figure 4.2. The concept of the

NOC which here inherently takes into account the non-holonomic constraint of the

wheels has been used. Moreover, being a matrix based approach, it is convenient

for numerical simulations.

## 4.1 Modeling using the Natural Orthogonal Com-

## pliment (NOC)

Let us consider a system n rigid bodies interconnected with different types of

joints. Let fi be the net force acting at the center of mass (CM) of the i − th

body and ni

is the net moment. If mi

is the mass, Ici is the moment of inertia

with respect to the CM, ci

is the position vector of the CM and ωi

is the angular

velocity of the same body, then equation of motion of the i−th rigid body is given

by Newton-Euler equations as

fi = mic¨i | and ni = Iciωi + ωi × Iciωi | (4.1)

Let us define twist (t) and wrench(w) as

ti ≡

ωi

c˙i

wi ≡

ni

fi

Note that the wrench wi acting on the i − th body can be decomposed into w

w
i

,

called the working component and w

C
i

, the non-working component. The working

component consists of all the external forces and torques, which imparts/extracts

energy to/from the system, e.g. motor actuating torque. The non-working com-

ponent of the wrench consists of the forces and torques that are used to constrain

the motion of the body at the joints. Then, Newton-Euler equation (4.1) can be

rewritten in a single matrix equation as

Mi

˙ti + WiMiti = w
w
i + w

c
i ∵ wi ≡ w

w
i + w

c
i

(4.2)

where

Mi ≡

Ici 0

0 mi

˜1

, Wi ≡

Ωi 0

0 0

, | Ωi ≡ ωi × ˜1 | (4.3)

in which ωi × 1, is refered as the crossproduct matrix of vector ωi and ˜1 denotes

the identity matrix. For details, refer to [16],[76].

If we define

M ≡ diag[M1, M2, ...Mn[, | W ≡ diag[W1, W2, ...Wn], | t ≡ [t

T
1

, tT
2

, ....tT
n

]

T

and

w

j ≡ [w

j
1

T
, w

j
2

T
, ....wj
n

T
]

T
, j = c, w

Then the equation of all the n rigid bodies in the system can be collected and

written as a single matrix equation as

M ˙t + WM t = w
c + w

w
(4.4)

The above equation is referred to as decoupled equations of motion of the system.

The kinematic constraints both holonomic and non-holonomic (e.g. pure rolling)

between two bodies i and j of a system can be expressed as linear homogeneous system of algebraic equations [16], namely

Aiti + Aj tj = 0 | (4.5)

where Ai

, Aj depend on the kinematic parameters.

The constraint equations corresponding to all the joints in the system can be

written in terms of the generalized twist vector t. Furthermore if, ˙θ ≡ (

˙θ1,

˙θ2, ....)
T

denote the independent generalized joint rates, one can then write t in terms of ˙θ

as t = T ˙θ. Using the fact, that ˙θ can take any arbitrary value, we get

At = 0, | ⇒ AT ˙θ = 0 | ⇒ AT = 0 | (4.6)

The above equation (4.6) indicates that T is the orthogonal compliment of A. Since

this relation arises naturally, hence the name Natural Orthogonal Complement. It

can be shown [16] that the non-working wrench w

c

lies in the range space of AT .

In view of equation 4.6, it can also be proved that w

c
lies in the null space of T

T
,

therefore

T

Tw

c = 0 | (4.7)
To eliminate the non-working forces and moments, i.e. w | C from the uncoupled

equation of motion (4.4), we multiply both sides of the equation by T

T
,

T

TM ˙t + T
TWM t = T

Tw

W , ⇒ T

TMT ¨θ + T
T

(MT˙ + WMT)

˙θ = T
Tw

T
(4.8)

Equation 4.8 represents the dynamic equation of interconnected n-body system.

This equation is expressed in terms of the independent generalized joint rates ˙θ and

cosponsoring acceleration ¨θ. Further. using the relations t = T ˙θ and ˙t = T˙ ˙θ + T ¨θ

in equation 4.8 the final equations of motion can be written as

I(θ)

¨θ = C(θ, ˙θ)

˙θ + τ | (4.9)

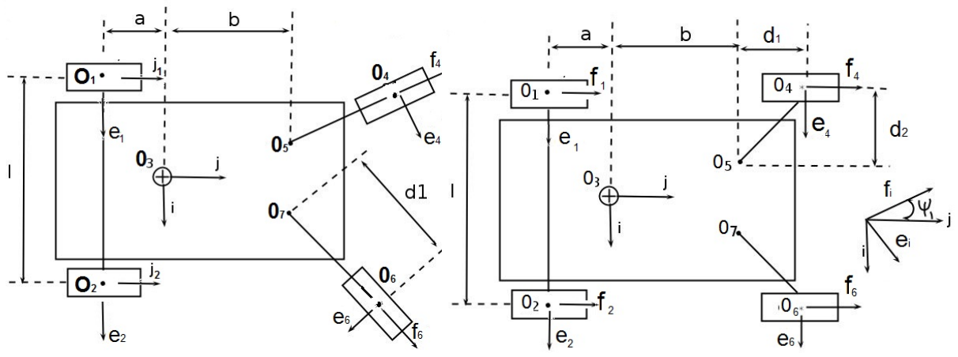
[picture p76: figure]

Figure 4.1: WMR-Std. Castor | Figure 4.2: WMR-general

Figure 4.3: Castor wheel configuration of a WMR

where

I(θ) ≡ T

TMT : generalized inertia matrix

C(θ, ˙θ) ≡ −T
T

(MT˙ + WMT)

˙θ : generalized matrix of convective inertia terms

τ ≡ T

Tw

T
: generalized vector of driving forces

## 4.2 Dynamic Equation of WMR

The dynamic equation of a differentially driven 3 wheeled mobile robot based on

the Natural Orthogonal Compliment (NOC) has been presented by Saha [18]. The

vehicle consisted of 2 driven wheel and one standard caster wheels. In general, for

large vehicles, it necessary to have at least four wheels from the point of stability

of the vehicle. Such a vehicle is shown in figure 4.1. It may be noted that the

caster wheels used in this case are the standard caster wheel configuration, where

the angle between line O4O5 and vector e4 is 90 deg. Which is a special case of the

more general configuration of the caster wheels shown in figure 4.2, where angle

between line O4O5 and vector e4 is not 90 deg

The vehicle considered for analysis in this chapter is shown in figure 4.2. It

consists of two independently driven wheels at the back and two generalized caster wheels at the front. The actuated wheels are labelled as body #1 and #2. The

platform is body #3. The first caster wheel and its bracket is labelled as #4

and #5 respectively, with the castor pivoted at O5. Similarly the second castor is

pivoted at O7, and its bracket and wheel is labelled as #6 an #7 respectively, all

the wheels are assumed to be rolling without slipping.

### 4.2.1 Kinematic analysis

In order to proceed with the kinematic analysis of the vehicle in figure 4.2, we

define a orthogonal triad of vectors i, j, k at point O3, the control point of the

platform, as shown in the figure. If ˙θ1 and ˙θ2
1 denote the rates of rotation of

wheel #1 and #2 then the linear velocity of points O1 & O2 under pure rolling

condition is given by

o˙i = r

˙θij, | r=radius of wheel | (4.10)

The angular velocity of the platform ω3 can be written as

ω3 = (r/l)( ˙θ1 − ˙θ2)k | (4.11)
Further, the velocity of point O3 can be written as o˙3 = ˙oi +ω3 ×(c−oi), | i =

1, 2. Where o3 and oi

is the position vector of points O3 and Oi respectively, with

respect to some point fixed to the ground. By eliminate ω3 we get the following:

o˙3 = [(ar/l)( ˙θ1 − ˙θ2) + (r/2)( ˙θ1 + ˙θ2)]i | (4.12)

Now, the angular velocity of the drive wheel #1 can be expressed as ω1 =

− ˙θ1i + ω3k. Using equation 4.11, the same can be rewritten as

ω1 =

−i + (r/l)k −(r/l)k

˙θ1

˙θ2

| (4.13)

1 positive when pointing along i

Based on equations 4.10 and 4.13, we can write the twist for wheel #1 in terms

of ˙θa ≡ (

˙θ1,

˙θ2)
T
, as

t1 =

ω1

o˙1

=

−i + (r/l)k −(r/l)k

rj | 0

˙θ1

˙θ2

| (4.14)

Similarly, for the other actuated wheel #2, one get

t2 =

ω1

o˙1

=

−i + (r/l)k −(r/l)k

0 | rj

˙θ1

˙θ2

| (4.15)

To calculate the twist, t3 of the platform body #3, equation 4.11 and 4.12 are

combined to get

t3 =

ω3

o˙3

=

ρδ | −ρδ

r(λi + (1/2)j) r(−λi + (1/2)j)

˙θ1

˙θ2

| (4.16)

where

δ ≡ d/l, | ρ ≡ r/d, | λ ≡ a/l

From the above three equations we get T1 =

−i + (r/l)k −(r/l)k

rj | 0

, T2 =

−i + (r/l)k −(r/l)k

0 | rj

, T3 =

ρδ | −ρδ

r(λi + (1/2))j r(−λi + (1/2))j

In order to calculate the twist of the caster bracket and the caster wheel, we

need to express the unactuated joint rates, ψ˙

1 and φ˙
1, in terms of the actuated

joint rate vector ˙θa. note here that ψ˙
1 denotes the rate of rotation of bracket body

#5 about O5 with respect to the platform, and φ˙

1 the rate of rotation of caster

wheel body #4 about its axis e4 with respect to bracket. The velocity of O5 can

be expressed in two independent forms,namely, one in terms of the velocity of O3

and the other one in terms of the velocity of O5, i.e.,

o˙5 = ˙o4 + ω5 × (d1e4 − d2f4), | o˙5 = ˙o4 + ω5 × (d1e4 − d2f4) | (4.17)

On equating the above two equations together, and using the rotation matrix

between coordiante system {i, j, k} and {e4, f4, k}, to express the equation in e4

and f4, we get

(−φ˙

1r + ψ˙
1d1)f3 + d3ψ˙
1e3 = ˙o3 + ω3(m cos ψ1 − b sin ψ1 − d1)e4 (4.18)

Taking the dot product of the above equation first with e4 and then with f4, and

using equation 4.12 for o˙3, we get

d2 | 0
−d1 | r

ψ˙
1
φ˙
1

=

(−ar/l)Sψ1 + (r/2)Cψ1 + δ1 | (ar/l)Sψ1 + (r/2)Cψ1 − δ1
(ar/l)Cψ1 + (r/2)Sψ1 + δ2 | (−ar/l)Cψ1 + (r/2)Sψ1 − δ2

˙θa

= [Fij ]

˙θa | (4.19)

where,

δ1 = (r/l)(mCψ1 − bSψ1 − d2, δ2 = (r/l)(mSψ1 + bCψ1 + d1)

Similarly, for the other caster wheel we get,

d2 | 0
−d1 | r

ψ˙
2
φ˙
2

=

(−ar/l)Sψ2 + (r/2)Cψ2 − δ3 | (ar/l)Sψ2 + (r/2)Cψ2 + δ3
(ar/l)Cψ2 + (r/2)Sψ2 + δ4 | (−ar/l)Cψ2 + (r/2)Sψ2 − δ4

˙θa

= [Gij ]

˙θa | (4.20)

where,

δ3 = (r/l)(mCψ2 + bSψ2 + d2, δ4 = (r/l)(mSψ2 + bCψ2 + d1

The angular and the liner velocity of the CM of the caster wheel,#4 is written

in-terms of the co-ordinate frame fixed to the bracket #5, i.e. {e4, f4, k}, as

ω4 = φ˙

1e4 + (ω3 + ψ˙

1)k, | o˙4 = φ˙
1e4 | (4.21)

Using equations 4.19 and 4.11, the twist t4 can be written as

t4 =

Θ4

C4

˙θa | (4.22)

Using the definition of F(i, j) in equation 4.19, Θ4 and C4 can be written as

Θ4 = [F11e4 + F¯

21k F12e4 + F¯
22k], | C4 = r[−F11f4 | − F12f4]

F¯

21 = F21 + ρδ, F¯ 22 = F22 − ρδ

The angular and the liner velocity of the CM of the caster bracket#5 expressed

in the co-ordinate frame fixed to the bracket is given by

ω4 = φ˙

1e3 + ψ˙
1k, | o˙4 = ˙o4 + ω5 × [−df3] | (4.23)

Using equations 4.11 & 4.20, the twist t5 can be written as

t5 =

Θ5

C5

˙θa | (4.24)

where

Θ5 ≡ [F¯

21k F¯

22k], | C5 ≡ d[(1/2)F¯
21e4 − ρF11f4 | (1/2)F¯
22e4 − ρF12f4]

In a similar manner, the twist t6 and t7 of the other caster wheel and its bracket

can be written as

t6 =

Θ6

C6

˙θa, t7 =

Θ7

C7

˙θa | (4.25)

Using G(i, j) defined in equation 4.20, Θ6, C6, Θ7 and C7 can be written as

Θ6 ≡ [G11e6 + G¯

21k G12e6 + G¯
22k], | C6 ≡ r[−G11f6 | − G12f6]

Θ7 ≡ [G¯

21k G¯

22k], | C7 ≡ d[(1/2)G¯
21e6 − ρG11f6 | (1/2)G¯
22e6 − ρG12f6]

G¯

21 ≡ G21 + ρδ, G¯
22 ≡ G22 − ρδ

### 4.2.2 Dynamic equations

Based on the twist calculated in terms of the independent joint rate vector vector

˙θa, we now derive the generalized inertia matrix and the matrix of convective

inertia term for the coupled equation of motion 4.9.

### 4.2.2.1 Generalized Inertia Matrix, I

The above equations gives the twist of individual body, i.e ti = Ti

˙θa. As defined

earlier t = [t

T
1

, tT
2

....tT
7

]

T and t = T θ we get

T = [T

T
1

, T T
2

, ...T7]

T

Since the matrix M is block diagonal, the inertia matrix of the full system is given

by

I = T

TMT = T

T
1 M1T1 + T

T

2 M2T2 + ...T T
7 M7T7 | (4.26)

We define the contribution of rear wheels alone to the inertia matrix by Im as

Im =

X

i=1,2

T

T
i MiTi

then

Im =

Iw + (ρδ)

2H + +mwr

2 | −2(ρδ)

2H

−2(ρδ)

2H | I + (ρδ)

2H + +mwr

2

| (4.27)

where Mi ≡

˜Iw 0

0 mw1

and ˜Iw ≡

Iw | 0 | 0

0 H

0 0 H

. Matrix ˜Iw is the 3 × 3 moment

of inertia matrix of the wheel in co-ordinate frame {i, j, k}, mass of the motorized

wheels is mw and mb1 is the 3 × 3 identity matrix. If the mass of the platform is mp and its moment of inertia about vector k is Ip, then as derived in [16]

I3 = T

T
3 M3T3 = Ip(ρδ)

2

1 | −1
−1 | 1

+ mpr

2

(1/4) + γ

2
(1/4) − γ

2

(1/4) − γ

2
(1/4) + γ

2

(4.28)

Similarly, if mc is the mass of the castor wheel and it is assumed to be a solid

disk, then the generalized inertia matrix can be written as

Ic =

X

i=4,6

T

T
i MiTi = (mcr

2
/4)

6F

2

11 + F¯
21

2
6F11F12 + F¯

21F¯
22

6F11F12 + F¯

21F¯
22 | 6F

2

12F¯
22
(4.29)

+

6G²

11 + G¯
21

2
6G11G12 + G¯

21G¯
22

6G11G12 + G¯

21G¯

22 | 6G² 12G¯
22

If the mass of the brackets, i.e., body #5 and #7, are small compared to the

mass of the caster wheels, then the contribution of T

T
5 M5T5 and T

T
7 M7T7 can be

neglected.

### 4.2.2.2 Matrix of Convective Inertia term C

The matrix of convective inertia terms of equation 4.9 can be broken down into two

parts, T

TMT˙ and T
TWMT. As given in equations 4.14, 4.15 and 4.16 T1, T2, T3

of the rear wheels and the platform is constant. Therefore T

TMT˙ = 0. The

generalized inertia matrix too is constant for the rear wheels and the platform, so

the vector Iiωi

is parallel to vector ωi

, i = 1..3 → ω × Iω = 0 → T

TWMT = 0.

This shows that contribution of the rear wheels and the platform to the convective

inertia term is zero. Moreover we have considered the mass of the brackets to be

zero, so they also do not contribute to the convective inertia term. Hence

C = T

TMT˙ + T
TWMT =
X

i=4,6

T

T

i MiT˙
i +

X

i=4,6

T

T
i WiMiTi | (4.30)

The expression for the first term is found by using equations 4.19, 4.20, 4.22 and

4.25. The terms F˙

ij and G˙
ij denote the derivatives of the elements of the matrix F and G defined in 4.19, 4.20 . To find T˙

4 and T˙
6 we have used the fact e˙4 = ω4 × e4

and e˙4 = ω6 × e6.

T

TMT˙ = (mcr
2

/4)"

6F11F˙

11 + F¯

21F˙

21 6F11F˙ 12 + F¯

21F˙
22
6F˙

11F12 + F˙

21F¯
22 | 6F

2

12F¯
22

+

6G11G˙

11 + G¯

21G˙

21 6G11G˙ 12 + G¯

21G˙
22
6G˙

11G12 + G˙

21G¯

22 | 6G² 12G¯
22

(4.31)

The second term of equation 4.30 i.e, P
i=4,6 T

T
i WiMiTi evaluates to zero, as shown

below. Consider castor wheel (body #4). Using equation 4.22 and W defined in

the equation 4.3 we get,

T

T
4 W4M4T4 = [Θ4, C4]

Ω4 | 0
0 | 0

I4 0

0 m41

Θ4

C4

= Θ4Ω4I4Θ4 (4.32)

To evaluate the above equation, we express all the terms in the coordinate

system {e4, f4, k}. Moreover, ω4 = Θ4

˙θa, using definition of Θ4 from equation 4.22

we get ω4 = (F11 ˙θ1 + F12 ˙θ2)e4 + (F21 ˙θ1 + F22 ˙θ2)k and the cros product matrix of

ω4 as

Ω4 ≡

0 | −(F¯ 21 ˙θ1 + F¯
| 22 ˙θ2) | 0

(F¯

21 ˙θ1 + F¯

22 ˙θ2) | 0 | −(F11 ˙θ1 + F12 ˙θ2)
0 | (F11 ˙θ1 + F12 ˙θ2) | 0

When the above expressions are substituted in equation 4.32, we get

T

T
4 W4M4T4 = 0, | ⇒ T
TWMT = 0 | (4.33)

So the matrix of convective inertia term C of equation 4.9 is evaluated as

C = (mcr

2

/4)"

6F11F˙

11 + F¯

21F˙

21 6F11F˙ 12 + F¯

21F˙
22
6F˙

11F12 + F˙

21F¯
22 | 6F

2

12F¯
22

+

6G11G˙

11 + G¯

21G˙

21 6G11G˙ 12 + G¯

21G˙
22
6G˙

11G12 + G˙

21G¯

22 | 6G² 12G¯
22

(4.34)

All the components of equation 4.9 have now been evaluated, except the τ .

These are simply the torques exerted by the actuated wheels. This completes the

dynamic model of the WMR with generalized caster wheel configuration.

## 4.3 Special cases

### 4.3.1 Standard caster (d1 = 0)

The standard caster wheel configuration can be obtained by setting the value

of d1 = 0. In such condition, the left hand side matrix of equations 4.19 and

4.20 become a diagonal matrix. Therefore, the first and second equation of 4.19

and 4.20 get divided by d2 and r, respectively. The resulting equations relating

the unactuated joint rate to actuated joint rates are similar to those reported by

[18],[16].

### 4.3.2 Under Actuated Case (d2 = 0)

It can be seen from equation 4.19 that when the caster offset d2 = 0, the LHS

matrix becomes singular. So the unactuated joint rates cannot be determined

from ˙θa. It is therefore essential to have proper caster offset in case we need caster

like behaviour from a passive wheel.

Another solution is to put an extra actuator to control the bracket motion by

controlling ψi

. As in the case of Ackerman steering mechanism, where the steering

wheel controls the orientation of the front passive wheels of a car.

## 4.4 Simulation

The mobile manipulator proposed in chapter 3 was modelled as a differential drive

robot. The front wheels and steering mechanism were not included in the dynamic

model as their masses are too small compared to the platform. The weight of each

wheel is 0.3Kg, the steering mechanism 0.24Kg, whereas the weight of the platform

is 70Kg.

In simulation the vehicle, (point O3), is required to trace a circle of radius 5m.

As shown in the figure 4.4. β is the angle between the line joining point O3 and

the origin O with respect to X − axis. The function β(t) is defined such that the

ful circle is completed in 60Sec.

β(t) = 20π
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
(4.35)

Moreover the velocity and acceleration of the robot is zero at the beginning (t=0)

and end of travel (t=60). The initial pose of the vehicle is parallel to the Y −axis

i.e. β = 0 shown by dotted line in figure 4.4.

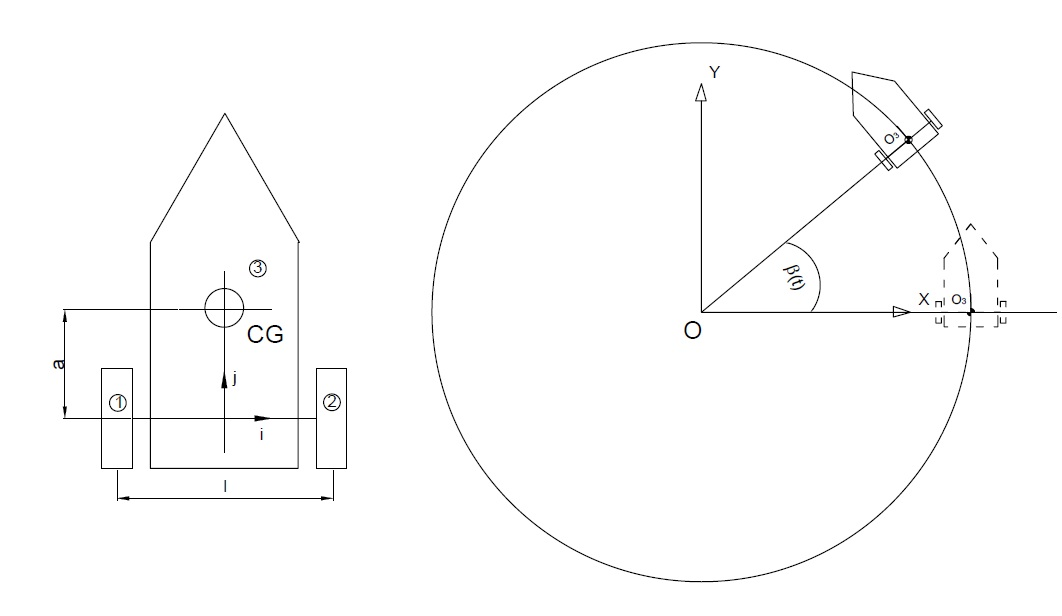
[picture p77: figure]

Figure 4.4: Path Traced by Robot

### 4.4.1 Inverse Dynamics

Using the model inverse kinematic, the wheel velocity and acceleration are deter-

mined using pseudo Inverse The wheel angle, velocity and acceleration were used

in the dynamics equation to calculate the torque required by each motor. The

results are plotted in figure 4.5.

The equation of dynamic model is given in equation 4.36, where the actuated

joints are θa(t) = (θl

, θr) are the rear left and right wheel rotation angles. The

dynamic and kinematic parameters used in the simulation is listed in table 4.1.

The rear wheels (i = 1, 2) and the platform i = 3, twist t

T
i = Tiθa, is given in

equations 4.14,4.15 and 4.16. The dynamic equation is of the vehicle on slope is

given as

T

TMT ¨θa = −T
T

(MT˙ + WMT)

˙θa + T
T
(w

J + w

G)

where T = (T

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
, M = diag(M1, M2, M3)

T

TMT = I1 + I2 + Im + I3 = Im + I3

W = diag(W1, W2, W3), | wG = g sin α, | α = 10o

(4.36)

w

G, w
J and α represent the gravitational force acting along the inclined the exter-

nal torque/Force applied by a motor and the inclination of the plane to horizontal

respectively. The generalized inertia matrix Im and I3 are given in 4.27 and 4.28.

As stated earlier the convective inertia term is zeros a the inertia matrices are

constant. The motor torque are then given a

T1

Tw

j
1 = τ1, T T
2 w

j
2 = τ2 | (4.37)

T

T
3 w

g =

ρδk r(λi + (1/2)j)

−ρδk r(−λi + (1/2)j)

0

−jg sin α

=

−
1/2 rg sin α

−
1/2 rg sin α
(4.38)

The torques required at the wheels of the vehicle to move up a spiral ramp of

slope 10o and radius 5m is given figure 4.5.


Figure 4.5: Inverse dynamics of the mobile robot

Table 4.1: Dynamic & kinematic parameters

Part Name | Property | Value
Rear Wheels mass | 300g
Moment of Inertia | diag(242, 242, 465)kg mm²
Base Frame | mass | 70Kg

Moment Of Inertia

1.18 | 0.01 −0.05
0.01 | 1.28 | 0.08
−0.05 0.08 | 0.53
Kg − m²
l | length | 400mm
r | wheel radius | 100mm
a | see figure

## 4.5 Summary

In this chapter the dynamic equation was derived for the most general form of

caster wheel configuration. Even though only two caster wheel configuration was

considered the same formulation can be extended to any number of caster wheels.

It is shown that the dynamics of standard caster wheels is a special case of the

general case with d1 = 0.It is also proven why a caster needs non-zero caster offset.

There is a need of extra actuator in case d2 = 0.

# Chapter 5

# Control of Mobile Manipulator

In this chapter, the control architecture of the teleoperated mobile robot is pre-

sented. The user interface for teleoperation is discussed. The control algorithm

running on the mobile robot and the hardware used for the control of traction and

steering is discussed. The protocol used for communication between the robot and

the user interface is also described in detail.

## 5.1 Control Architecture and Hardware

The mobile manipulator explained in chapter 3 was planned to be teleoperated

over a wireless network. The control block diagram and architecture are shown in

Figure 5.1. It has a remote control station which is the interface for the operator

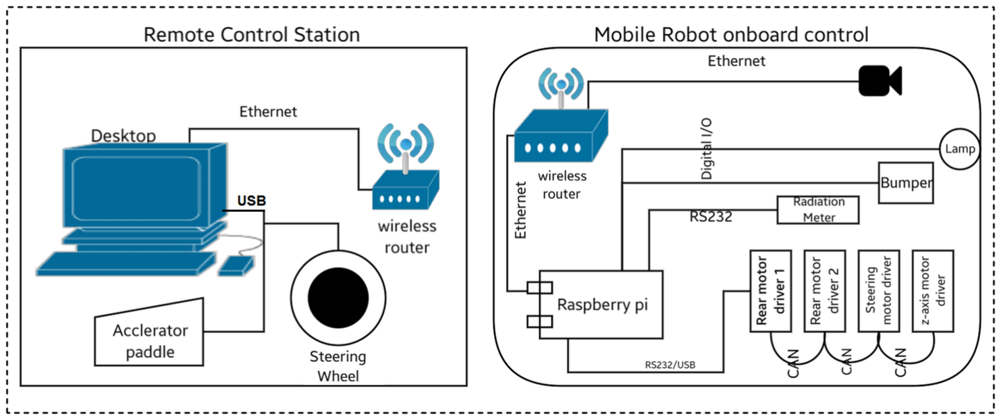
[picture p78: figure]

Figure 5.1: Control architecture

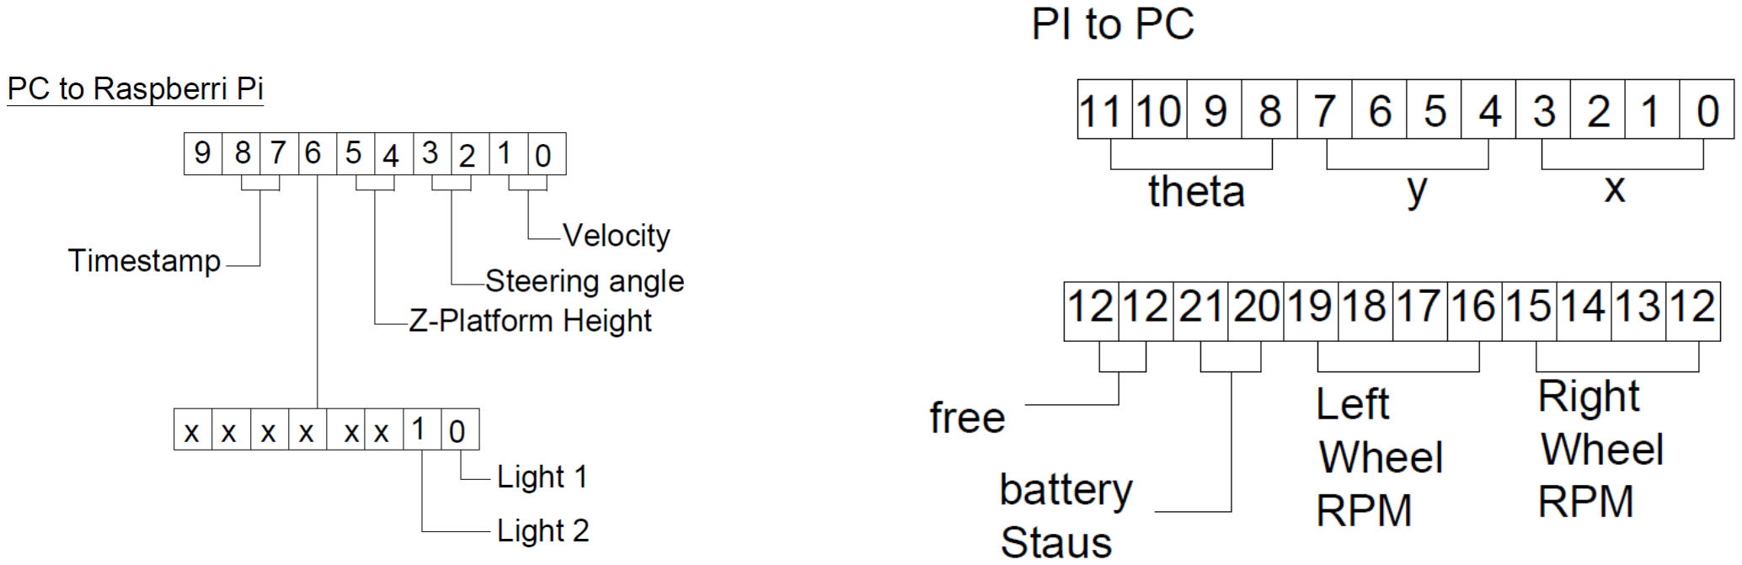
[picture p79: figure]

Figure 5.2: Data from PC to the robot Figure 5.3: Data from the robot to PC

and a local onboard controller of the mobile robot. They communicate over a

dedicated wireless network. The remote station sends data packet every in 50

millisecond (20Hz) to the mobile robot. The commanded velocity, steer angle,

z position of the platform, and state of the detector and headlamps constitute

the data packet sent by the remote station as shown in Figure 5.2. The onboard

controller of the mobile robot replies with a data packet consisting of the X, Y

position and orientation θ of the robot, the current steer angle, angular velocities

of each wheel, the z position of the top platform, battery voltage and current of

each motor. They are indicated in Figure 5.3.

### 5.1.1 Local Onboard Controller

The onboard computer which is Raspberry Pi running raspian (linux) os receives

command from the remote station and controls the robot hardware through cus-

tomized c++ application. The Raspberry Pi is daisy chained to the four Maxon

Make, EPOS2 motor controllers/drivers. The communication between the on-

board computer and the first Maxon controller is over usb/RS232 interface using

Maxon’s proprietorial protocol [77]. The first controller serves as CAN master

for the rest of the controllers. The rear wheel motor drivers were configured in

velocity servo loop. The drivers for steering and the z-axis motors were configured

in position control loop. The camera mounted on the mobile robot and Raspberry

Pi were connected over Ethernet via a wireless hub. The wiring digram of the


Figure 5.4: Wiring diagram of the WMR

robot is given in Figure 5.4. Since the onboard camera is connected to the wire-

less network directly, it does not interfere with the command loop between the

Raspberri Pi and the PC.

The mobile robot is teleoperated using position-speed command as in [78].

The workspace for the mobile robot was assumed infinite compared to the input

device. In case of manipulators position-position control approach is generally

used with scaling. In this case, the mixed approach was used. The steering angle

was controlled in position-position mode whereas the mobile robot’s speed was

controlled by foot paddle’s position, i.e. in position-velocity mode. This can be

given by the following equation:

V

θS

=

Kv | 0
0 | Ks

X˜
p
Θ˜
s
| (5.1)

where X˜

p is the displacement of paddle, ˜θs is the twist of steering wheel, Kv and

Ks are the proportionality constants, V is the velocity of point O3 Figure 5.10

and θs is the displacement of the steer motor. These proportionality constants are

derived as below based on extreme limits and listed in Table 5.1.

Table 5.1: Proportionality constant table

Robot | range | Joy-Stick | range | parameter
parameters | | Parameter | | Value
θs | -60 to +60 | Θ˜
| | s | −90o
to 90o | Ks = 2/3
V | 0 to +60 mm/sec X˜
| | p | 0 to 30mm | Kv = 2


Figure 5.5: Block digram of EPOS4 controller

### 5.1.2 Details of the Motor Controller

Three EPOS2 controllers from Maxon Motors were used to control the mobile

robot’s rear wheel velocity and the steering gears position. Each controller can

control one motor. The overall architecture of the controller as given in [79], [80]

is shown in Figure 5.5. The controller can be configured in either current, position

or velocity control mode. The inner most current loop controls the torque of the

motor. The current feedback loop shown in Figure 5.6 is a Proportional Integrator

(PI) controller, running at 25KHz and the transfer function of the PI block is given

as 5.2.

C(s) = Kp +

KI
s

(5.2)

where Kp and KI are the proportional and integral gains.

The rear motor controllers are configured in the velocity control mode. The

block digram of the velocity loop is given in Figure 5.7. The velocity controller is

a PI controller with velocity and acceleration feed-forward. The transfer function

Figure 5.6: Current control block

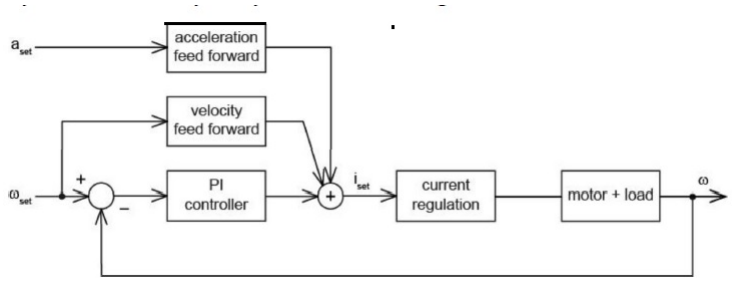
[picture p80: figure]

Figure 5.7: Velocity control bolck

V (s) of the velocity loop PI block is given by

V (s) = Kpω +

KIω
s

(5.3)

where Kpω and KIω are proportional and integral gains for velocity, respectively.

The sampling rate of the velocity loop is 2.5 KHz. The feedforward accelera-

tion and velocity was used to compensate for the known inertial load and viscous

frictional load [80] respectively. Velocity is estimated from differentiation of the

position data, the low-pass filter in Figure 5.5 eliminates noise due to differentia-

tion. The transfer function H(s) for the low-pass filter is given by

H(s) = 1 1 + Kpω 48KIω
(5.4)

The gain values used for each rear motor in the velocity control mode is listed

in Table 5.2. No acceleration or velocity feedforward was used. These parameters

were determined by auto tuning.

The steering motor was in position control mode. The block digram is shown

Table 5.2: Parameters for left and right rear wheel motor controllers

Gain | Right motor | Left motor | Unit
Parameter | Value | Value
Kp | 300 | 230 | mV
| | | A
KI | 100 | 53 | mV
| | | A.mS
KP ω | 1000 | 5182 | mA.sec
| | | rad
KIω | 100 | 425 | mA
| | | rad

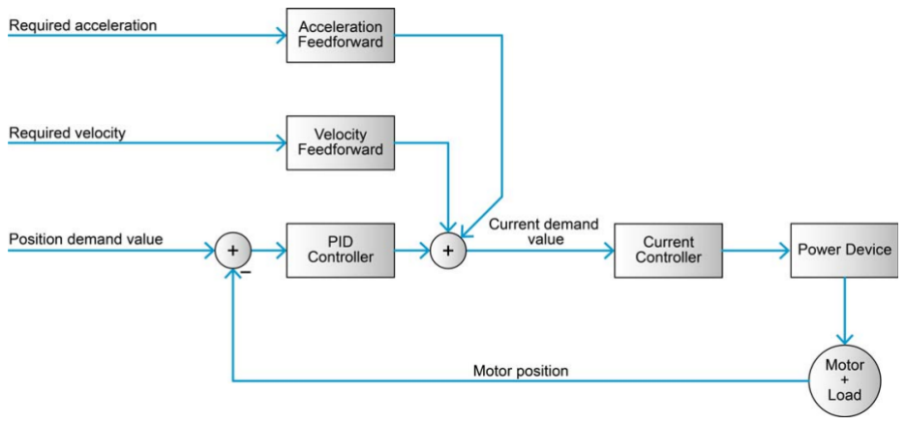
[picture p81: figure]

Figure 5.8: Position control bolck

in Figure 5.8. It is a PID controller with transfer function given as

P(s) = KP P + KIP s +

KDP s
1 + KDP
10KP P

s

(5.5)

where KP P , KIP and KDP are position proportional, integral and derivative gains

respectively. The velocity feed-forward FωP and acceleration feed-forward FαP

were used in position control loop to take care of viscious friction and known

inertial load. The gains for controller were decided using auto tuning software

provided by Maxon Motors. The values are reported in Table 5.3.

## 5.2 The control algorithm for the WMR

This section discusses in detail the algorithm running on the onboard controller.

Command received by the controller was parsed to extract the velocity and the

Table 5.3: Parameters of steering motor controller

Gain Parameter | Value Unit
Kp | 537 | mV
| | A
KI | 307 | mV
| | A.mS
KP P | 128 | mA.sec
| | rad
KIP | 663 | mA
| | rad
KID | 200 | mA
| | rad
FωP | 0 | mA.sec
| | rad
FαP | 54 | mA.sec²
| | rad

steer angle information. They were suitably scaled to get command velocity V in

mm/sec, and steering angle θs in radians. It may be noted that the velocity V

corresponds to the velocity of point Or the reference point of the mobile robot.

Next the set point for each motor was calculated and sent to individual drive. The

algorithm is listed below and the block digram for the same in Figure 5.9

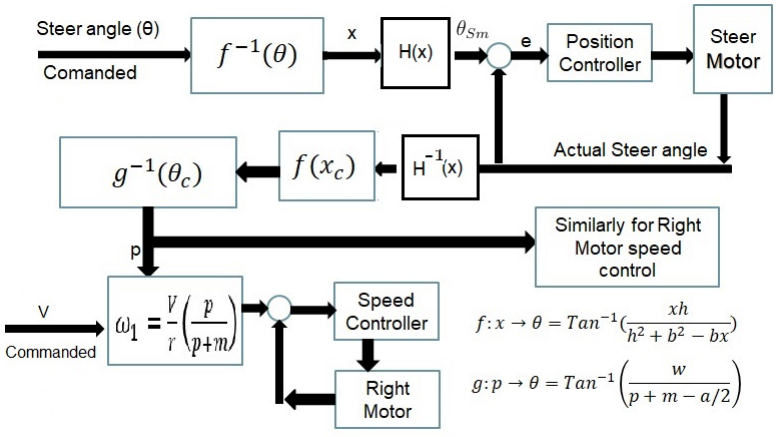
[picture p82: figure]

Figure 5.9: Block digram of WMR controler

1. Calculate the setpoint for steering motor θSM based on θs.
2. Read the current steering angle φic.
3. Calculate the velocity setpoints ωi and ωo of rear wheels based on the V and

φic.

4. Command setpoints ωi

, ωo and θSM to each motor.

The above loop is repeated every 50 mSec.

It may be noted that the steer angle command received from the control station

is not directly sent to the steer motor as set point after suitable scaling. The steer

set point is based on the current rear wheel velocities. This is important as the

response time of the motors are different. The above methodology helps minimize

the deviation from the Ackerman steering condition even during transit condition,

particularly, in case of large change in commanded v and θs. Each block in Figure

5.9 is discussed next.

It may be noted that the θs always refers to the steer angle of the inner front

wheel φi and V refers to Or as shown in figure 5.10, i.e.

θs = φi | (5.6)

The set point of the steering motor at the output of gear box θSM is given by

equations 5.7 and 5.8 based on the geometry of Davis steering gear [65].

tan φi =

xh
h

2 + b

2 − bx

or

f(φi) : x =

tan φi(h

2 + b

2
)
h + b tan φi

(5.7)

where x is the displacement of the rack and h and b are link lengths. The rack is

connected to the steering motor by pinion of pcd Dp (30mm) as shown in Figure

5.11. Therefore, the steering motor angle, θSm, is given below as

H(x) : θSm = x

360
πDp

(5.8)

Next, the equation relating current steer angle φi and rear wheel set point

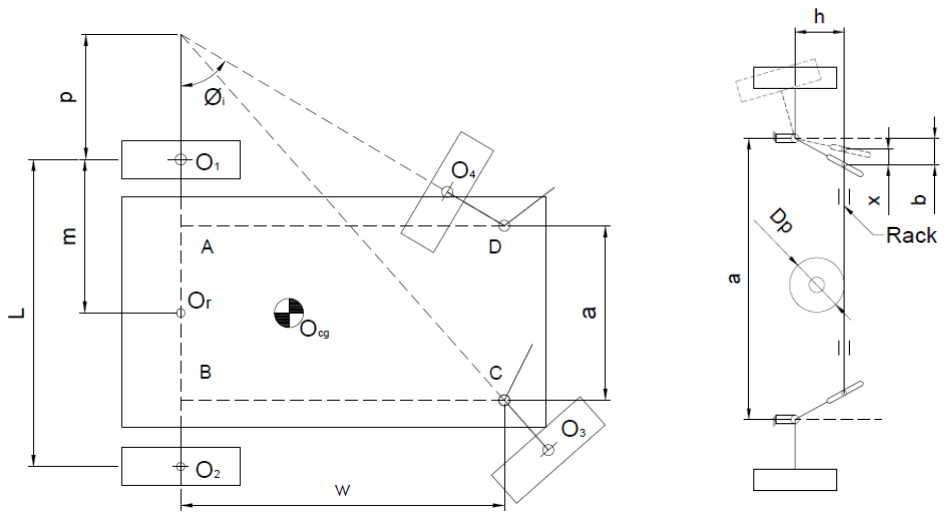
[picture p83: figure]

Figure 5.10: Ackerman Steering Condition | Figure 5.11: Davis Steering Gear

velocities ωRS and ωLS is presented. From the geometry of Figure 5.10, one gets

tan φi =

BD¯
OB¯

=

w
p + m − a/2

g : φi → p, p =

w
tan φc

− m +

a
2

(5.9)

Now using Equations 4.10 and 4.11 in equations relating the right and left wheel

velocities to the WMR platform angular velocity ω3 and velocity, V , of the refer-

ence point Or, presented below

O˙

r = O˙
i + ω3 × (Or − Oi)

O˙

r = O˙
o + ω3 × (Or − Oo)

We get the velocity of each rear wheel as

ωi =

V p
r(p + m)

ωo =

V (p + 2m)
r(p + m)

Using the above equations and Equation 5.9, the setpoints for the rear wheels are

as follows

ωi =

V
r

(

w
tan θo

− m +

a
2

)

w
tan θo

− m +

a
2 + m

(5.10)

ωo =

V
r

(

w
tan θo

− m +

a
2

) + 2m

w
tan θo

− m +

a
2 + m

(5.11)

### 5.2.1 Wheel Odometery

The dead reckoning odometery can be performed based on either the differential

drive or Bicycle model. In the present case, we use the differential drive model

was used/ Where the rear wheel velocities were used to determine the position

and orientation of the mobile robot. The position here means the position of the

reference point Or. The steps are followes.

1. calculate V and ω3 from current wheel velocities ω1 and ω2 using equations

4.11 and 4.12 with a = 0.

2. integrate V and ω3 over time step.

If x(t), y(t) are the coordinate of Or and β(t) be the orientation of the robot

with some global coordinate system, the kinematic model of the differential wheel

robots is given by [9]

x˙

y˙

β˙

=

cos β 0

sin β 0

0 1

V

ω3

| (5.12)

Equation 5.12 is numerically integrated for time δt using the following expressions:

x(i + 1) = x(i) + δt V (i) cos β(i); | (5.13)
y(i + 1) = y(i) + δt V (i) sin β(i); | (5.14)
β(i + 1) = β(i) + δt ω3(i); | (5.15)

where i is at time step ti

. Next, the actual odometric results for the vehicle moving

in a circle and a straight line are presented.

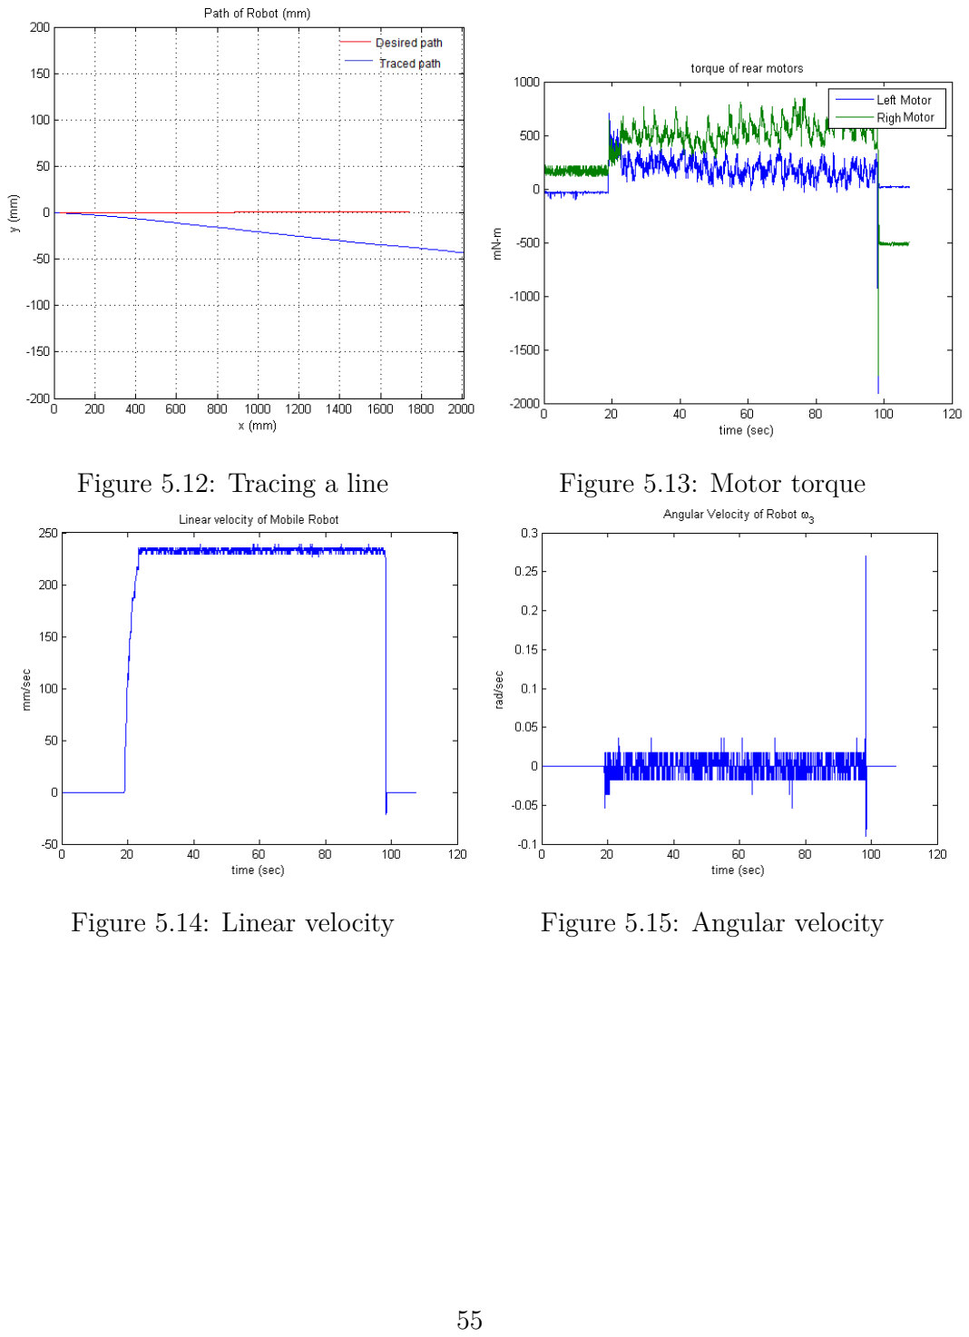
[picture p84: page 74]

Figure 5.12: Tracing a line | Figure 5.13: Motor torque
Figure 5.14: Linear velocity | Figure 5.15: Angular velocity

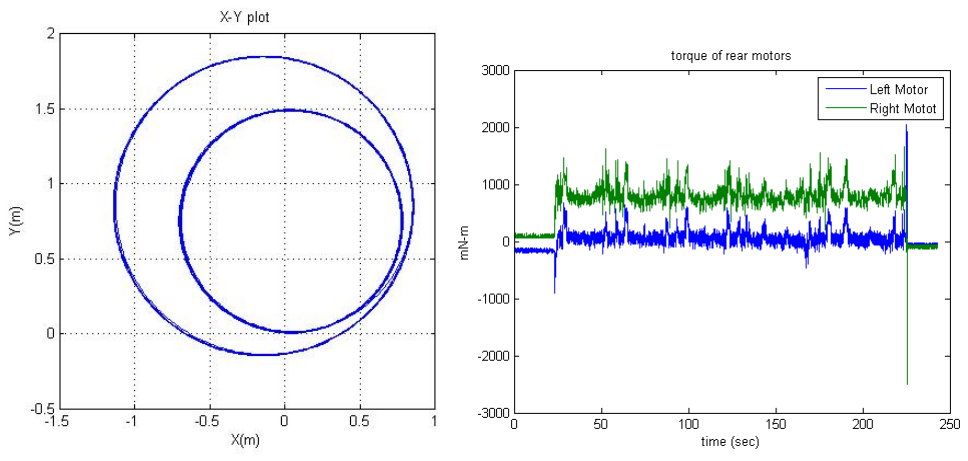
[picture p85: figure]

Figure 5.16: Tracing a circle | Figure 5.17: Motor torque

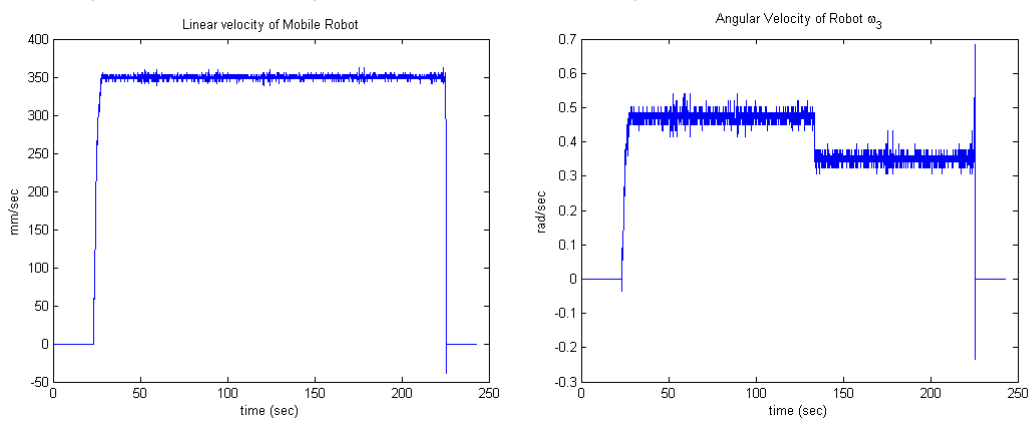
[picture p86: figure]

Figure 5.18: Linear velocity | Figure 5.19: Angular velocity

As seen in the graph of Figure 5.12 there is a lateral shift in the robots path

calculated using odometry. There is a linear shift too, which can observed due to

longer path calculated by odometry. The lateral shift of 200 mm and a linear shift

of 300 mm for 15000 mm long path was calculated. This clearly indicates slip in

the wheels. The torque curves also shows that one wheel is more loaded that the

other this is expected as the battery weight was on one side of the robot.

### 5.2.2 The Remote Control Station

The operator controls the vehicle from a local station away from the robot over

a wireless network. The control station consists of a desktop computer running

Windows XP. A steering wheel and two foot switches are connected to the desktop.


Figure 5.20: User interface for teleoperation

The steering wheel sets the steering of the remote mobile robot and the footpadel

is used to set the velocity V of the robot. A push button in the steering wheel is

used to reverse the direction of motion of the robot.

The screen of the desktop displays video streaming from the mobile robot’s on

board camera. A graphical user interface (GUI) shown in Figure 5.20 displays the

robot’s parameters such as current steer angle, velocity of each rear wheels and

the position of the z-axis. Buttons on the GUI operates the z-axis, head lamps,

etc.

## 5.3 Summary

In this chapter, the control architecture of the mobile robot has been presented.

The algorithm used to move the robot was discussed in detail. The odometry used

for pose estimation of the robot was also presented with the experimental results.

## 5.4 note

Remove jitter in odometry add new result.

# Chapter 6

# Simulation of Tele-operation

In this chapter, simulation of a teleoperated mobile robot is presented. In tele-

operation, the human operators observe a remote scene through camera(s), and

manipulate the local steering wheel and accelerator paddle, as illustrated in figure

6.1 . The command is transmitted to the mobile robot over wireless network.

The operator’s response is based on the latest feedback images from the cameras.

In general, there is a time lag when communication takes place over wireless

network. The time lag deteriorates the human performance as discussed in [44]

and references therein. This chapter simulates the teleoperation both without and

with time delay in transmission network.

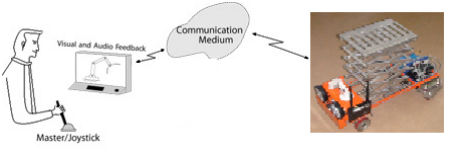
[picture p87: figure]

Figure 6.1: Teleoperation architecture

## 6.1 Modeling of Mobile Platform

The standard kinematic model, as described in [9], of the mobile robot was used for

the simulation. The use of kinematic model is justified as the vehicle is expected to

move at relatively slow speed and model is simple. Inputs to the model are left and

right rear wheel velocities. The front wheels are steered to satisfy the Ackerman

condition as presented in Chapter 3 and are assumed to attain the desired angle

instantaneously. Therefore, the robot can be treated as differential drive robot.

The kinematic model of the platform is presented below:

x˙

y˙

˙θ

=

cos θ 0

sin θ 0

0 1

rw/2 rw/2

1/b −1/b

φ˙
L
φ˙
R
| (6.1)

where , b is the distance between the rear wheels, rw wheel radius. φ˙

R and φ˙
L
are the rotational velocities of left and right wheels. The operator station sends

the command u1 and u2 over the wireless network. In general, it will be delayed

by time δ. These commands are interpreted by the robot controller as the left and

right wheel velocities. Therefore, by taking the time delay into consideration one

can write

φ˙
R(t)

φ˙
L(t)

=

ur(t − δ)

ul(t − δ)

| (6.2)

The control inputs to the mobile robot ur and ul are generated by the operator

based on the visual data available to the person. Hence, a model of the human

operator needs to be used for the simulation of complete loop.

## 6.2 Model of Human Operator

In order to simulate the teleoperation loop, one needs a mathematical model of

human operator. The mathematical model of the operator’s action is approached

assuming a car driving metaphor. The video feedback, which the operator receives

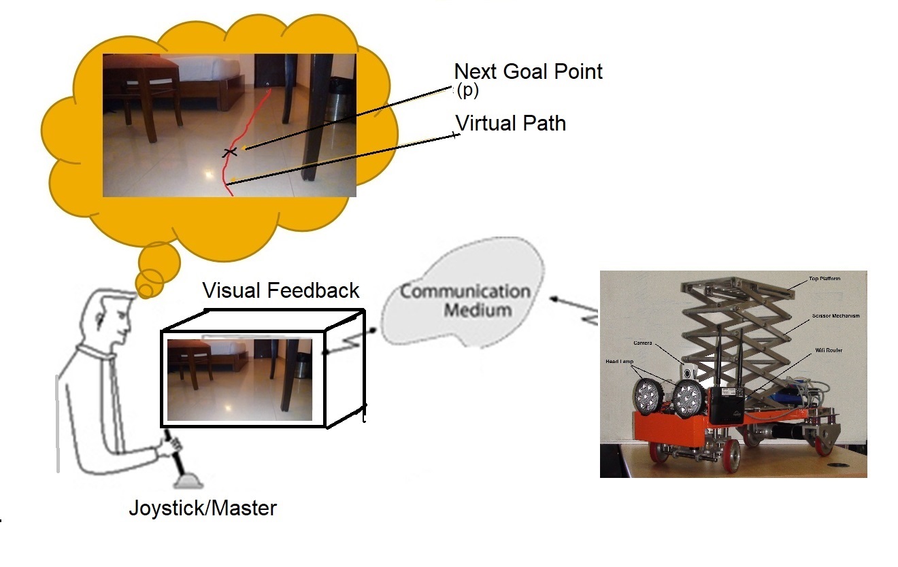
[picture p88: figure]

Figure 6.2: Assumed driving strategy

of the remote environment, give him the idea of the vehicle’s position and the

tentative next goal point (p) based on a lookahead distance (l). He then constructs

a virtual path mentally and tries to manoeuvre or steers the robot to follow that

path as shown in Figure 6.2. As he moves forward the goal point keeps changing

until he reaches the desired location. This methodology of path tracing is known

as pure pursuit [19].

The mathematical model for the pure pursuit method of path following can be

derived as given in Figure 6.3. As shown in Figure 6.3, the origin of the coordinate

system is at point o, the middle of rear axis of the robot. As the differential drive

robot can move only about a circle with center lying on the line along its rear

axis. An arc OP of radius r, is drawn with center O1 and passing through o and

p. Where p is a point on the path to be traced by the robot. The linear distance

between the points o and p is called the look ahead distance l. This distance in

the case of a teleoperated robot will depend on the field of view of camera at the

remote location and the obstacles present in the remote environment.

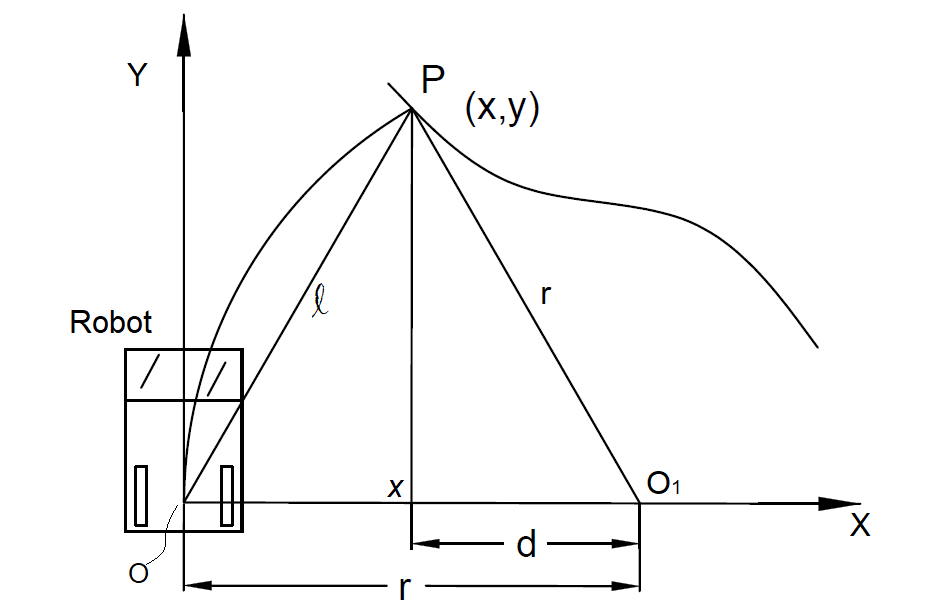
[picture p89: figure]

Figure 6.3: Geometry of Pure Pursuit

If (x, y) is the coordinate of point p in X − Y coordinate system, then

x

2 + y

2 = l

2
, | d = r − x | (6.3)

Similarly, from triangle p, x, o1 we get

d

2 + y

2 = r

2 ⇒ (r − x)

2 + y

2 = r

2 ⇒ x

2 + y

2 − 2rx = 0 (6.4)

Replacing x

2 and y

2
in Equation 6.4 with Equation 6.3, we get

2rx = l

2 | ⇒ r =

l

2
2x

(6.5)

Once the radius r, the desired linear velocity of the robot v are known, the

angular velocity of the vehicle is ˙θ = −v/r. The rear wheel φ˙

L(t) and φ˙
R(t) can be

calculated from Equation 6.1. Where y˙ = v and x˙ = 0. To match the orientation

of the vehicle with that in Figure 6.3, θ = 90o
. We then get

x˙

y˙

˙θ

=

0 0

rw/2 rw/2

b/2 −b/2

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
1/rw/ 1/rw

1/b −1/b

v

˙θ

(6.6)

The operator station sends v and ˙θ as the command over the communication

network to the robot. The Figure 6.4 shows the simulation strategy

Figure 6.4: Simulation Scheme

## 6.3 Simulation and Results

The teleoperation loop consists of the operator model described in Section 6.2

at one end of the communication link and the mobile robot model described in

Section 6.1 on the other end . As shown in Figure 6.5, there will a delay in both

directions of communication. In real system, the video image is streamed by the

robot. Due to large quantity of data and limited bandwidth the delay h1 >> h2.

The amount of delay h1 was experimentally measured and it was found around

0.5sec, as described in Appendix A. The command sent by the operator is v and

˙θ which is few bites only. Therefore in simulation h2 = 0 is assumed.

### 6.3.1 The Simulation Algorithm

The algorithm for simulation is explained in the following steps.

1. Convert the path from global coordinate system (CS) to Robots Local Co-

ordinate System

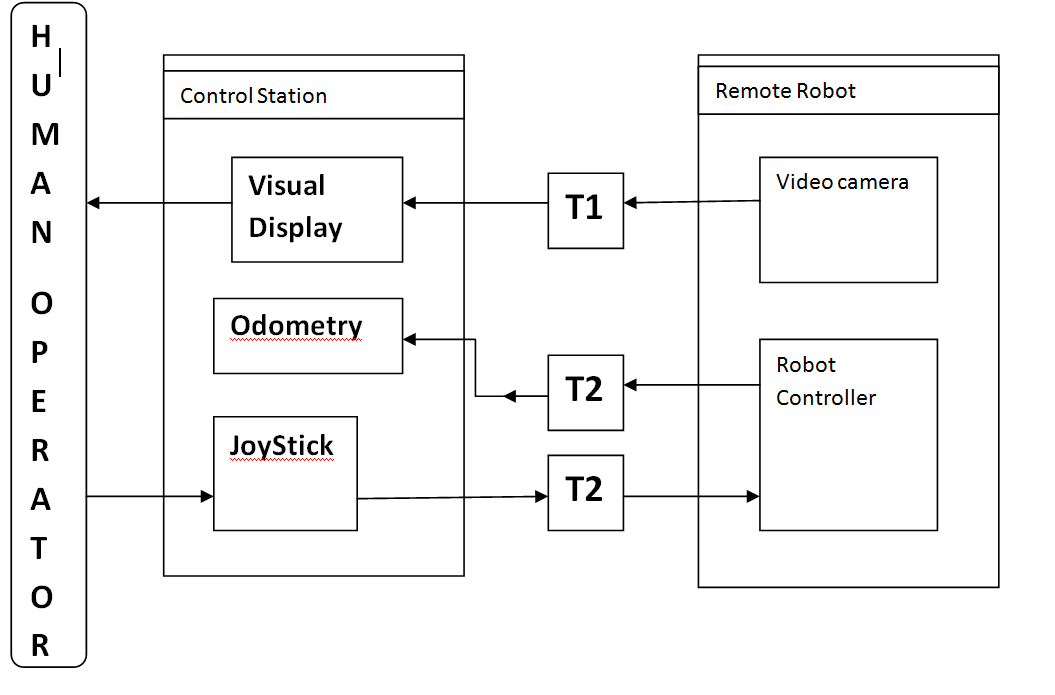
[picture p90: figure]

Figure 6.5: Block diagram for teleoperation

2. With a given look ahead distance (l) search for a point on the path
- If point is found goto Step 3
- If not found increase the look ahead distance
3. Determine the turning radius (r) using Equation 6.5
4. Calculate the command to the robot based on Equation 6.7. Note that these

commands are based on the old visual data the operator saw.

5. Solve delayed differential equation.

Simulation was carried using Matlab. Delay differential equation solver "dde24"

was used to solve equation 6.1 and 6.2 with delayed inputs ur and ul

. The desired

path was a circle of radius 5m centred at origin of the global coordinate system.

The human action was modelled with look ahead distance of 0.5m and linear

velocity of 0.5m/s. The initial position of the robot was (4.5,0.0).

The performance of the system with zero delay, i.e. h1 = h2 = 0 is shown in

Figure 6.6. Figures 6.7 and 6.8 show the robot’s motion under delay of 0.5 and

0.8 sec. It is seen that oscillation becomes visible at 0.5sec delay, and with the

delay of 0.8 sec the system was on the verge of instability.

It was also observed that the with large vehicle velocity, v and large look ahead

distance, l the instability commences with smaller time delay, δ in Equation 6.2.

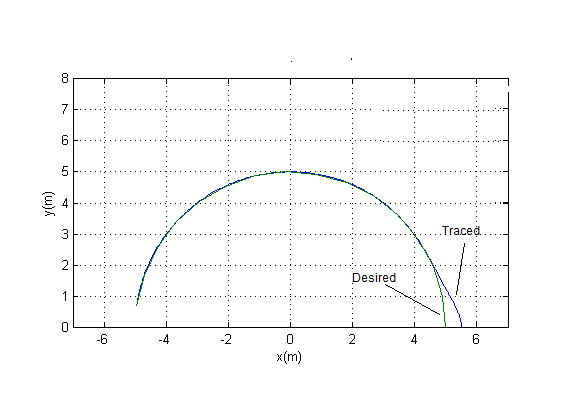
[picture p91: figure]

Figure 6.6: Simulation with no time delay in either direction

In the next section we propose a predictive model based feedback control which

is used to stabilize robot motion under time delay teleopration.

## 6.4 Summary

In this chapter, simulation study of the developed teleoperated mobile robot is

presented. A mathematical model was presented of the human operator action

while driving the robot based on visual feedback. Simulation results show that

the behaviour of the system deteriorates with increase in delay in communication

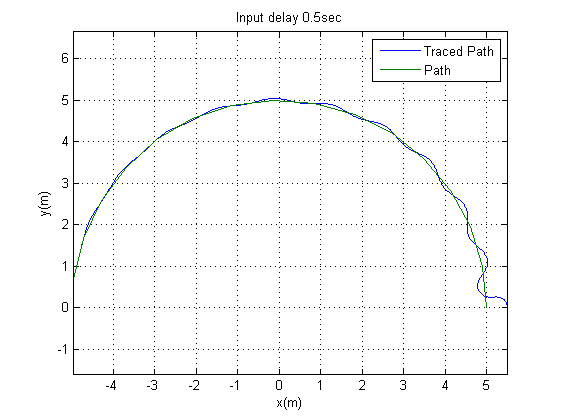
[picture p92: figure]

Figure 6.7: Simulation with time delay h1 = .5sec and h2 = 0

between the local and remote station. With large time delay the system becomes

unstable.

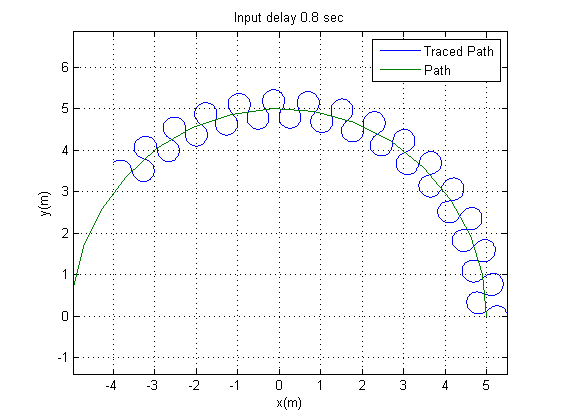
[picture p93: figure]

Figure 6.8: Simulation with time delay h1 = .8sec and h2 = 0

# Chapter 7

# Dime Delay Compensation and

# Predictive Display

In the last chapter it was shown using simulation results that time delay between

the remote and local station leads the system towards in stability. In this chapter

we use predictive display to alleviate the above problem.

Predictive display has been defined as using the computer for extrapolating

the display forward in time [81]. In this a local model of the remote scene is

used to predict and render the remote scene in response to operator command.

It replaces the delayed video feedback with extrapolated synthesised image of the

remote environment and local enables the operator to perform the task normally.

## 7.1 Remote Scene Extrapolation

The visual data present in the current frame is the view that the robot has seen h1

second earlier. In order to predict the current scene that the robot might be seeing

we need to estimate the current position of the robot. Once the current position

of the robot is known we re-construct a view form the old scene by moving the

view point to the current position of the robot. To explain this further and to use

it in the teleoperation simulation model discussed in chapter 6

### 7.1.1 here

# Chapter 8

# Conclusions

## 8.1 Thesis Summary

This thesis describes the design and development of a customized mobile manipu-

lator developed at Bhabha Atomic Research Centre, Mumbai, India for mapping

radiation in different areas of Cyclotron building where human access is restricted

during Cyclotron operation. The customized mobile manipulator is a four wheeled

mobile robot with a vertical lifting platform on which the radiation detector is

mounted. The mobile platform has two rear wheels individually coupled to two

motors and the front two wheels which are mutually connected using a motorized

Davis steering mechanism.

The mechanical design was obtained in Chapter 3, and through optimization

of steering mechanism minimum turning radius was achieved within the required

space. The optimal location of the CG for the mobile manipulator was decided so

as to provide maximum traction as well as stability over 30o
ramp. Among different

lifting platforms for the vertical motion to the sensor for scanning, a simple scissor

based lifting platform was choosen due to several advantages it offers.

The kinematic and dynamic modeling of the customized mobile manipulator

was presented in chapter 4, where the method based on the Natural Orthogonal

Complement was used to derive the dynamic eqution of motion of the wheeled mobile robot under study. This analysis highlighted the effect of caster offsets on

the maneuverability of a mobile robot. The need of having a positive drive for

certain castor offsets were also brought in the analysis.

Control structure for intuitive teleoperation of the mobile robot was presented

in chapter 5. This chapter proposed a user interface at the operator’s side, along

with the hardware and software required for the teleoperation. The control algo-

rithm running on the robot on-board computer was also presented. The contribu-

tion there was that it synchronizes all three motors; two in velocity control and

one in position control mode (steering). In spite of difference in response time,

Ackerman relation for wheel rolling was always satisfied.

The developed mobile robot was controlled by an operator who was physi-

cally separated from the mobile manipulator. A dedicated wireless network and

the video signal of the remote environment from the robot on-board camera was

available. The limited bandwidth resulted in the delay of the video. Chapter 6

dealt with the simulation of a teleoperation of a mobile robot under time delay. A

mathematical model of the human operator based on pure pursuit algorithm was

presented. The simulation predicted instability with increase in time delay and

linear velocity of the mobile robot. These studies qualitatively matches with the

operator behaviour under similar conditions.

Note that the time delay in the video feedback affects the efficiency of the

operator. In order to overcome this, predictive display was proposed. In chapter

7, a new methodology was presented for the predictive display based on the 3-d

model generated using the RGB-Depth data provided by a Kinect Sensor mounted

on the mobile robot and the predicted position of the robot based on dynamic

model of the robot presented in chapter 4. This novel method did not require

the 3-D model of the remote environment known before hand as reported in the

literature earlier. This flexibility allows us to teleoperate the mobile robot in an

unknown environment.

In summary, a mobile manipulator was sucessfully concived, designed assembled and controlled remotely for the purpose for which it was intended, i.e, to map

the radiation of a given area.

## 8.2 Current status

A prototype of mobile manipulator and its teleoperation system were manufac-

tured and assembled at BARC, Mumbai, India based on the analysis and algo-

rithms presented in this thesis. The robot was lab tested and the video of the

same can be accessed on at the following https://youtu.be/B5OngfLQjo4. The

system will shortly be deployed at Variable Energy Cyclotron Centre (VECC) at

Kolkata, India for the same purpose.

## 8.3 Future Scope

The testing and evaluation of teleoperation system during actual trial opens up

further scope of improvement. Few of these are listed below

(i) Use of inertial sensors such as gyroscope and accelerometer on the mobile

robot in combination with wheel odometer for more accurate pose estima-

tion.

(ii) Pose estimation using encoder mounted on the front passive wheels for slip

detection.

(iii) Semi-automated navigation using intermediate goal point.

(iv) Texture mapping of predicted visual image instead 3-D point cloud model

currently used.

(v) Some kind of force feedback to the operator for estimation of obstacle loca-

tion in the remote environment.

# Bibliography

[1] L. Ray, A. Price, A. Streeter, D. Denton, and J. H. Lever, “The design of a mobile robot for instrument network deployment in antarctica,” in Robotics and Automation, 2005. ICRA 2005. Proceedings of the 2005 IEEE International Conference on, pp. 2111–2116, IEEE, 2005.
[2] K. Ohno, S. Kawatsuma, T. Okada, E. Takeuchi, K. Higashi, and S. Tadokoro, “Robotic control vehicle for measuring radiation in fukushima daiichi nuclear power plant,” in Safety, Security, and Rescue Robotics (SSRR), 2011 IEEE International Symposium on, pp. 38–43, IEEE, 2011.
[3] L. Briones, P. Bustamante, and M. A. Serna, “Wall-climbing robot for inspection in nuclear power plants,” in Robotics and Automation, 1994. Proceedings., 1994 IEEE International Conference on, pp. 1409–1414, IEEE, 1994.
[4] S. Galt, B. Luk, D. Cooke, and A. Collie, “A tele-operated semi-intelligent climbing robot for nuclear applications,” in Mechatronics and Machine Vision in Practice, 1997. Proceedings., Fourth Annual Conference on, pp. 118–123, IEEE, 1997.
[5] C.-S. Cho, J.-D. Kim, S.-G. Lee, S. K. Lee, S.-C. Han, and B.-S. Kim, “A study on automated mobile painting robot with permanent magnet wheels for outer plate of ship,” in Robotics (ISR), 2013 44th International Symposium on, pp. 1–4, IEEE, 2013.
[6] J. Borenstein, “Control and kinematic design of multi-degree-of freedom mobile robots with compliant linkage,” IEEE transactions on robotics and automation, vol. 11, no. 1, pp. 21–35, 1995.
[7] P. F. Muir and C. P. Neuman, “Kinematic modeling of wheeled mobile robots,” Journal of robotic systems, vol. 4, no. 2, pp. 281–340, 1987.
[8] J. C. Alexander and J. H. Maddocks, “On the kinematics of wheeled mobile robots,” The International Journal of Robotics Research, vol. 8, no. 5, pp. 15– 27, 1989.
[9] G. Campion, G. Bastin, and B. Dandrea-Novel, “Structural properties and classification of kinematic and dynamic models of wheeled mobile robots,” IEEE transactions on robotics and automation, vol. 12, no. 1, pp. 47–62, 1996.

[10] B.-J. Yi and W. K. Kim, “The kinematics for redundantly actuated omnidirectional mobile robots,” Journal of Robotic Systems, vol. 19, no. 6, pp. 255– 267, 2002.
[11] N. A. M. Hootsmans et al., The motion control manipulators on mobile vehicles. PhD thesis, Massachusetts Institute of Technology, 1992.
[12] J. H. Chung, S. A. Velinsky, and R. A. Hess, “Interaction control of a redundant mobile manipulator,” The International Journal of Robotics Research, vol. 17, no. 12, pp. 1302–1309, 1998.
[13] J. Y. Luh, M. W. Walker, and R. P. Paul, “On-line computational scheme for mechanical manipulators,” Journal of Dynamic Systems, Measurement, and Control, vol. 102, no. 2, pp. 69–76, 1980.
[14] F. Boyer and S. Ali, “Recursive inverse dynamics of mobile multibody systems with joints and wheels,” IEEE Transactions on robotics, vol. 27, no. 2, pp. 215–228, 2011.
[15] J. Angeles and S. K. Lee, “The formulation of dynamical equations of holonomic mechanical systems using a natural orthogonal complement,” Journal of applied mechanics, vol. 55, p. 243, 1988.
[16] J. Angeles, Fundamentals of robotic mechanical systems: theory, methods, and algorithms, vol. 124. Springer Science & Business Media, 2013.
[17] S. K. Saha and J. Angeles, “Kinematics and dynamics of a three-wheeled 2-dof agv,” in Robotics and Automation, 1989. Proceedings., 1989 IEEE International Conference on, pp. 1572–1577, IEEE, 1989.
[18] S. K. Saha and J. Angeles, “Dynamics of nonholonomic mechanical systems using a natural orthogonal complement,” Journal of Applied Mechanics, vol. 58, no. 1, pp. 238–243, 1991.
[19] R. C. Coulter, “Implementation of the pure pursuit path tracking algorithm,” tech. rep., Carnegie-Mellon UNIV Pittsburgh PA Robotics INST, 1992.
[20] M. J. Barton, “Controller development and implementation for path planning and following in an autonomous urban vehicle,” Undergraduate thesis, University of Sydney, 2001.
[21] J. Wit, C. D. Crane III, and D. Armstrong, “Autonomous ground vehicle path tracking,” Journal of Robotic Systems, vol. 21, no. 8, pp. 439–449, 2004.
[22] T. Hellstrom and O. Ringdahl, “Follow the past: a path-tracking algorithm for autonomous vehicles,” International journal of vehicle autonomous systems, vol. 4, no. 2, pp. 216–224, 2006.
[23] B. Paden, M. Čáp, S. Z. Yong, D. Yershov, and E. Frazzoli, “A survey of motion planning and control techniques for self-driving urban vehicles,” IEEE Transactions on intelligent vehicles, vol. 1, no. 1, pp. 33–55, 2016.

[24] H. L. Martin and D. P. Kuban, Teleoperated robotics in hostile environments. Society of Manufacturing Engineers, 1985.
[25] J. Vertut and P. Coiffet, “Teleoperations and robotics: Evolution and development,âĂĲrobot technology,âĂİ vol. 3a,” 1986.
[26] T. H. Massie, J. K. Salisbury, et al., “The phantom haptic interface: A device for probing virtual objects,” in Proceedings of the ASME winter annual meeting, symposium on haptic interfaces for virtual environment and teleoperator systems, vol. 55, pp. 295–300, Citeseer, 1994.
[27] S. Grange, F. Conti, P. Helmer, P. Rouiller, and C. Baur, “Overview of the delta haptic device,” tech. rep., 2001.
[28] C. Clover, G. R. Luecke, J. J. Troy, and W. A. McNeely, “Dynamic simulation of virtual mechanisms with haptic feedback using industrial robotics equipment,” in Robotics and Automation, 1997. Proceedings., 1997 IEEE International Conference on, vol. 1, pp. 724–730, IEEE, 1997.
[29] M. Ueberle, N. Mock, and M. Buss, “Vishard10, a novel hyper-redundant haptic interface,” in Haptic Interfaces for Virtual Environment and Teleoperator Systems, 2004. HAPTICS’04. Proceedings. 12th International Symposium on, pp. 58–65, IEEE, 2004.
[30] J. Yoon and J. Ryu, “Design, fabrication, and evaluation of a new haptic device using a parallel mechanism,” IEEE/ASME Transactions on mechatronics, vol. 6, no. 3, pp. 221–233, 2001.
[31] R. Aracil, M. Ferre, M. Hernando, and J. Sebastian, “Telerobotic system for live-power line maintenance: Robtet,” IEEE Transactions on Industrial Electronics, vol. 44, no. 5-44, pp. 630–637, 1997.
[32] L. Matthies, “Stereo vision for planetary rovers: Stochastic modeling to near real-time implementation,” International Journal of Computer Vision, vol. 8, no. 1, pp. 71–91, 1992.
[33] G. Hirzinger, “Robots in space-a survey,” Advanced Robotics, vol. 9, no. 6, pp. 625–651, 1994.
[34] R. Goertz, R. Blomgren, J. Grimson, G. Forster, W. Thompson, and
W. Kline, “The anl model 3 master-slave electric manipulator–its design and use in a cave,” Trans. Am. Nuclear Soc., vol. 4, no. 2, 1961.
[35] C. Flatau, “Sm-229: a new compact servo master-slave manipulator,” in Proceedings of the 25th conference on remote systems technology, 1977.
[36] D. A. Lawrence, “Stability and transparency in bilateral teleoperation,” IEEE transactions on robotics and automation, vol. 9, no. 5, pp. 624–637, 1993.
[37] P. F. Hokayem and M. W. Spong, “Bilateral teleoperation: An historical survey,” Automatica, vol. 42, no. 12, pp. 2035–2057, 2006.

[38] R. J. Anderson and M. W. Spong, “Bilateral control of teleoperators with time delay,” IEEE Transactions on Automatic control, vol. 34, no. 5, pp. 494–501, 1989.
[39] J. Rebelo and A. Schiele, “Time domain passivity controller for 4-channel time-delay bilateral teleoperation,” IEEE transactions on haptics, vol. 8, no. 1, pp. 79–89, 2015.
[40] G. Niemeyer and J.-J. Slotine, “Stable adaptive teleoperation,” IEEE Journal of oceanic engineering, vol. 16, no. 1, pp. 152–162, 1991.
[41] S. Stramigioli, R. Mahony, and P. Corke, “A novel approach to haptic teleoperation of aerial robot vehicles,” in Robotics and Automation (ICRA), 2010 IEEE International Conference on, pp. 5302–5308, IEEE, 2010.
[42] S. Stramigioli, C. Secchi, A. J. van der Schaft, and C. Fantuzzi, “Sampled data systems passivity and discrete port-hamiltonian systems,” IEEE Transactions on Robotics, vol. 21, no. 4, pp. 574–587, 2005.
[43] M. Krstic, Delay compensation for nonlinear, adaptive, and PDE systems. Springer, 2009.
[44] J. Y. Chen, E. C. Haas, and M. J. Barnes, “Human performance issues and user interface design for teleoperated robots,” IEEE Transactions on Systems, Man, and Cybernetics, Part C (Applications and Reviews), vol. 37, no. 6, pp. 1231–1245, 2007.
[45] T. Sheridan, “Human supervisory control of robot systems,” in Robotics and Automation. Proceedings. 1986 IEEE International Conference on, vol. 3, pp. 808–812, IEEE, 1986.
[46] P. K. Pook and D. H. Ballard, “Teleassistance: Contextual guidance for autonomous manipulation,” in AAAI, pp. 1291–1296, 1994.
[47] M. Jagersand and R. Nelson, “Visual space task specification, planning and control,” in Computer Vision, 1995. Proceedings., International Symposium on, pp. 521–526, IEEE, 1995.
[48] T. B. Sheridan, “Space teleoperation through time delay: Review and prognosis,” IEEE Transactions on robotics and Automation, vol. 9, no. 5, pp. 592– 606, 1993.
[49] A. K. Bejczy and W. S. Kim, “Predictive displays and shared compliance control for time-delayed telemanipulation,” in Intelligent Robots and Systems’ 90.’Towards a New Frontier of Applications’, Proceedings. IROS’90. IEEE International Workshop on, pp. 407–412, IEEE, 1990.
[50] W. S. Kim and A. K. Bejczy, “Demonstration of a high-fidelity predictive/preview display technique for telerobotic servicing in space,” IEEE Transactions on Robotics and Automation, vol. 9, no. 5, pp. 698–702, 1993.

[51] M. Jagersand, “Image based predictive display for tele-manipulation,” in Robotics and Automation, 1999. Proceedings. 1999 IEEE International Conference on, vol. 1, pp. 550–556, IEEE, 1999.
[52] K. Yerex, D. Cobzas, and M. Jagersand, “Predictive display models for telemanipulation from uncalibrated camera-capture of scene geometry and appearance,” in Robotics and Automation, 2003. Proceedings. ICRA’03. IEEE International Conference on, vol. 2, pp. 2812–2817, IEEE, 2003.
[53] Z. Deng and M. Jagersand, “Predictive display system for tele-manipulation using image-based modeling and rendering,” in Intelligent Robots and Systems, 2003.(IROS 2003). Proceedings. 2003 IEEE/RSJ International Conference on, vol. 3, pp. 2797–2802, IEEE, 2003.
[54] A. Kelly, N. Chan, H. Herman, D. Huber, R. Meyers, P. Rander, R. Warner,
J. Ziglar, and E. Capstick, “Real-time photorealistic virtualized reality interface for remote mobile robot control,” The International Journal of Robotics Research, vol. 30, no. 3, pp. 384–404, 2011.
[55] T. Burkert, J. Leupold, and G. Passig, “A photorealistic predictive display,” Presence: Teleoperators & Virtual Environments, vol. 13, no. 1, pp. 22–43, 2004.
[56] H. Hu, C. P. Quintero, H. Sun, and M. Jagersand, “On-line reconstruction based predictive display in unknown environment,” in Robotics and Automation (ICRA), 2015 IEEE International Conference on, pp. 4446–4451, IEEE, 2015.
[57] Y. Yamamoto and X. Yun, “Coordinating locomotion and manipulation of a mobile manipulator,” in Decision and Control, 1992., Proceedings of the 31st IEEE Conference on, pp. 2643–2648, IEEE, 1992.
[58] S. Rajendran and et.al., “Mobile robot for reactor vessel inspection,” in National Conference on Advanced Manufacturing and Robotics, pp. 2527–2532, CMERI, Durgapur,WB„ 2004.
[59] F. G. Pin and S. M. Killough, “A new family of omnidirectional and holonomic wheeled platforms for mobile robots,” IEEE transactions on robotics and automation, vol. 10, no. 4, pp. 480–489, 1994.
[60] J. E. M. Salih, M. Rizon, S. Yaacob, A. H. Adom, and M. R. Mamat, “Designing omni-directional mobile robot with mecanum wheel,” American Journal of Applied Sciences, vol. 3, no. 5, pp. 1831–1835, 2006.
[61] J. Suthakorn, S. S. H. Shah, S. Jantarajit, W. Onprasert, W. Saensupo,
S. Saeung, S. Nakdhamabhorn, V. Sa-Ing, and S. Reaungamornrat, “On the design and development of a rough terrain robot for rescue missions,” in Robotics and Biomimetics, 2008. ROBIO 2008. IEEE International Conference on, pp. 1830–1835, IEEE, 2009.

[62] M. Guarnieri, R. Debenest, T. Inoh, E. Fukushima, and S. Hirose, “Development of helios vii: an arm-equipped tracked vehicle for search and rescue operations,” in Intelligent Robots and Systems, 2004.(IROS 2004). Proceedings. 2004 IEEE/RSJ International Conference on, vol. 1, pp. 39–45, IEEE, 2004.
[63] K. Nagatani, S. Tachibana, M. Sofne, and Y. Tanaka, “Improvement of odometry for omnidirectional vehicle using optical flow information,” in Intelligent Robots and Systems, 2000.(IROS 2000). Proceedings. 2000 IEEE/RSJ International Conference on, vol. 1, pp. 468–473, IEEE, 2000.
[64] J. Y. Wong, Theory of ground vehicles. John Wiley & Sons, 2008.
[65] T. Bevan, Theory of Machines, Third Edition. Delhi, India: CBS Publishers & Distributors, 1984.
[66] Motor catalogue 2014. Switzerland: Maxon Motors, 2017.
[67] J. T. Machado and M. F. Silva, “An overview of legged robots,” in International symposium on mathematical methods in engineering, MME Press Ankara, Turkey, 2006.
[68] K. P. Valavanis and G. J. Vachtsevanos, Handbook of unmanned aerial vehicles. Springer Publishing Company, Incorporated, 2014.
[69] J.-B. Mouret, Evolutionary Adaptation in Natural and Artificial Systems. PhD thesis, Université Pierre et Marie Curie, 2015.
[70] G. Campion and W. Chung, “Wheeled robots,” in Springer Handbook of Robotics, pp. 391–410, Springer, 2008.
[71] R. M. DeSantis, “Modeling and path-tracking control of a mobile wheeled robot with a differential drive,” Robotica, vol. 13, no. 04, pp. 401–410, 1995.
[72] K. C. Koh and H. S. Cho, “A smooth path tracking algorithm for wheeled mobile robots with dynamic constraints,” Journal of intelligent & robotic systems, vol. 24, no. 4, pp. 367–385, 1999.
[73] B. d’Andréa Novel, G. Campion, and G. Bastin, “Control of nonholonomic wheeled mobile robots by state feedback linearization,” The International journal of robotics research, vol. 14, no. 6, pp. 543–559, 1995.
[74] B. d’Andrea Novel, G. Bastin, and G. Campion, “Modelling and control of non-holonomic wheeled mobile robots,” in Robotics and Automation, 1991. Proceedings., 1991 IEEE International Conference on, pp. 1130–1135, IEEE, 1991.
[75] K. Thanjavur and R. Rajagopalan, “Ease of dynamic modelling of wheeled mobile robots (wmrs) using kane’s approach,” in Robotics and Automation, 1997. Proceedings., 1997 IEEE International Conference on, vol. 4, pp. 2926– 2931, IEEE, 1997.
[76] S. Saha, Introduction to robotics. Tata McGraw-Hill, New Delhi, 2010.

[77] EPOS Application Note: RS232 to CANopen Getway. Maxon Motors, 2012.
[78] I. Farkhatdinov and J.-H. Ryu, “Hybrid position-position and position-speed command strategy for the bilateral teleoperation of a mobile robot,” in Control, Automation and Systems, 2007. ICCAS’07. International Conference on, pp. 2442–2447, IEEE, 2007.
[79] M. Z. Zeroual, “maxon auto tuning,” iNaCoMM2013,IIT Roorkee, India, 2013.
[80] EPOS4 Application Note: Positioning Controllers. Maxon Motors, 2012.
[81] S. T. B, “Space teleoperation through time delay: review and prognosis,” IEEE Transactions on Robotics and Automation, vol. 9, no. 5, October 1993.

# Appendix A

# Simulation Time Delay

# Tele-operation

A.1 | Measurment of Time Delay in Video Feed-
| back

The experimental method used to find the delay in video stream coming from the

remote station is described here.

# Appendix B

# Dynamics

## B.1 Inertia Dyad

The dyadic product takes two vector and returns a second-order tensor. If a and

b are two vectors expressed as a ≡ a1i + a2j + a3k and b ≡ b1i + b2j + b3k. Then

the dyadic product of a and b are defined as:

# Publications from the Thesis

Research papers published/presented/under preparation are listed below

1. Hayat, A.A., Abhishek, V., Saha, S.K., Dynamic Identification of Manip-

ulator: Comparison between CAD and Actual Parameters, 17th National

and 2nd International Conference on Machine and Mechanisms, iNaCoMM

2015, IIT Kanpur, Dec. 16–19, 2015.

2. Udai, A. D., Hayat, A. A., Saha, S. K., “Parallel Active/Passive Force Con-

trol of Industrial Robots with Joint Compliance,” IEEE/RSJ International

Conference on Intelligent Robots and Systems (IROS 2014), Chicago, Illi-

nois, Sept. 14–18 , 2014.

# Brief Bio-data of the Author
