amarendas/PhdThesis/Misc_end/publications.tex

\chapter*{Publications from the Thesis}
Research papers published/presented/under preparation are listed below\\
 \\
 \textbf{ Conference}
\begin{enumerate}
\item  Das Amaren P., et al. "Design of a Teleoperated Mobile Manipulator for Inspection of Cyclotron Vault."\textit{ Machines, Mechanism and Robotics-Proceedings of iNaCoMM 2017}. Springer, Singapore, 2019. 529-540.
\item  Das Amaren P., Saha S. K., Bhasin S., and Badodkar D. N.," Kinematic and Dynamic of redundantly actuated mobile robot using NOC", \textit{under preparation}

\item Das Amaren P., Saha S. K., Bhasin S., and Badodkar D. N., "RGB-D based Predictive Display for Tele-operation of Mobile Robot in Unknown Environment",To be Submitted to\textit{ Advances in Robotics, International Conference of Robotics Society of India, (AiR 2019)},IIT Madras, Chennai, July 2-6, 2019

\item  Das Amaren P., Saha S. K., Bhasin S., and Badodkar D. N.," Control Architecture for Tele-operated Mobile Platform for Radiation Mapping in Radioactive Areas", \textit{under preparation}
\end{enumerate}
