amarendas/PhdThesis/Misc_front/copyright.tex

\newgeometry{top=1.3in,bottom=1.0in,left=0.8in,right=0.8in}
\doublespacing
\thispagestyle{empty}
\begin{center}

\textbf{\large{DESIGN AND CONTROL OF TELEOPERATED MOBILE PLATFORM}}

\bigskip
\bigskip
\bigskip
\bigskip
\bigskip
\bigskip
\bigskip
\bigskip
\bigskip
\bigskip

\textbf{AMAREN PRASANNA DAS}

\bigskip
\bigskip
\bigskip
\bigskip
\bigskip
\bigskip
\bigskip
\bigskip
\bigskip
\bigskip
\bigskip
\bigskip
\bigskip
\bigskip
\bigskip
\bigskip
\bigskip
\bigskip
\bigskip
\bigskip
\bigskip



\bigskip
\bigskip
\bigskip
\bigskip
\bigskip
\bigskip

\textbf{DEPARTMENT OF MECHANICAL ENGINEERING}

\textbf{INDIAN INSTITUTE OF TECHNOLOGY DELHI}

\textbf{December 2018}

\end{center}
%%%%%%%%%%%%%%%%%%%%%%%%%%%%%%%%%%%%%%%%%%%%%%%%%%%%%%%%%%%%%%%%%%%%%%%%
\newpage
\thispagestyle{empty}
\mbox{}
%%%%%%%%%%%%%%%%%%%%%%%%%%%%%%%%%%%%%%%%%%%%%%%%%%%%%%%%%%%%%%%%%%

\newpage
\thispagestyle{empty}
\begin{center}

\bigskip
\bigskip
\bigskip
\bigskip
\bigskip
\bigskip
\textbf
\bigskip
\bigskip

\textbf

\bigskip
\bigskip

\textbf

\bigskip
\bigskip
\bigskip
\bigskip
\bigskip
\bigskip

\textit

\textit

\bigskip
\bigskip

\textbf

\bigskip
\bigskip

\textit{to the}

\bigskip
\bigskip
\bigskip
\bigskip
\bigskip
\bigskip
\bigskip



\bigskip
\bigskip

\textbf{INDIAN INSTITUTE OF TECHNOLOGY DELHI}

\textbf{HAUZ KHAS, NEW DELHI - 110016}

\textbf{May 2017}
\end{center}
%%%%%%%%%%%%%%%%%%%%%%%%%%%%%%%%%%%%%%%%%%%%%%%%%%%%%%%%%%%%%%%%%%%%%%%%
\mbox{}
%%%%%%%%%%%%%%%%%%%%%%%%%%%%%%%%%%%%%%%%%%%%%%%%%%%%%%%%%%%%%%%%%%
\restoregeometry
