amarendas/PhdThesis/Misc_front/iitlogo-eps-converted-to.pdf

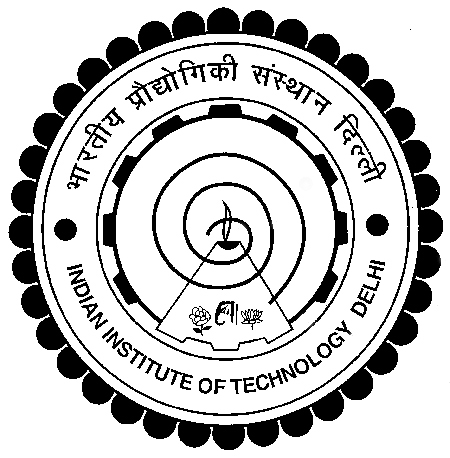
[picture p94: page 1]
