amarendas/PhdThesis/Chapter1/fig/kukaAGV.jpeg

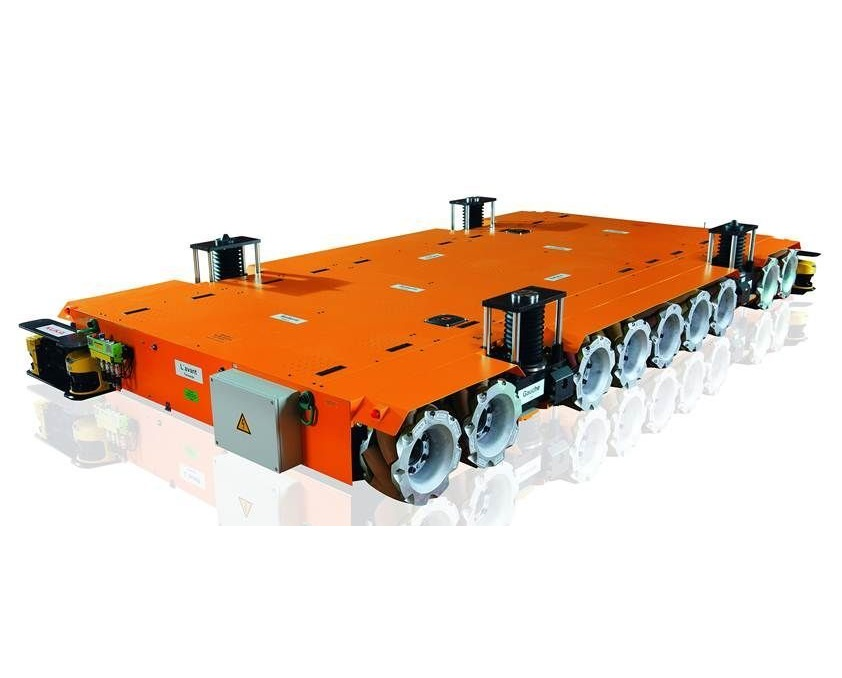
Chapter1/fig/kukaAGV.jpeg
