amarendas/PhdThesis/Chapter2/fig/FollowTheCarrot.png

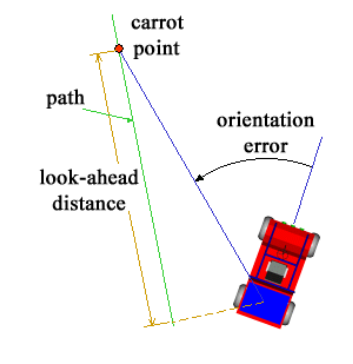
Chapter2/fig/FollowTheCarrot.png
