amarendas/PhdThesis/Chapter2/fig/FukusimaRobot.png

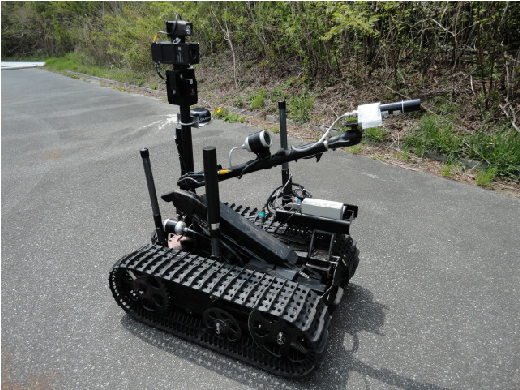
Chapter2/fig/FukusimaRobot.png
