amarendas/PhdThesis/Chapter2/fig/nero3.png

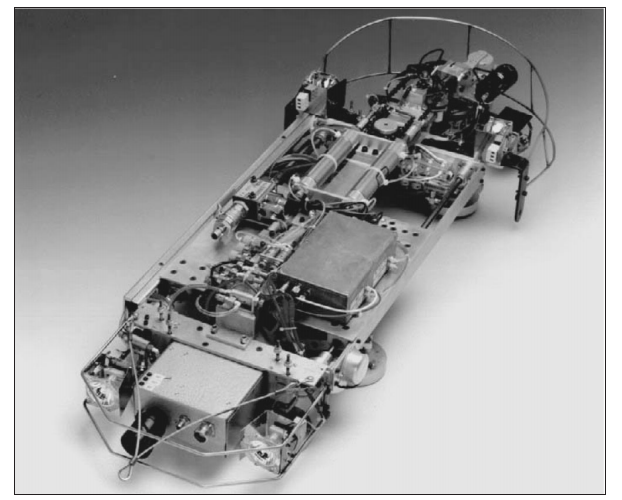
Chapter2/fig/nero3.png
