amarendas/PhdThesis/Chapter2/fig/VectorPursuit.png

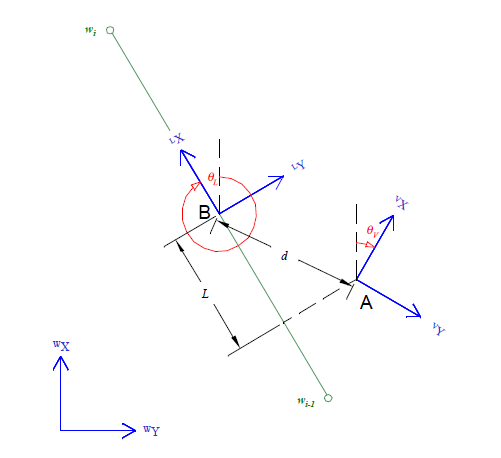
Chapter2/fig/VectorPursuit.png
