amarendas/PhdThesis/Chapter3/fig/davidGear.png

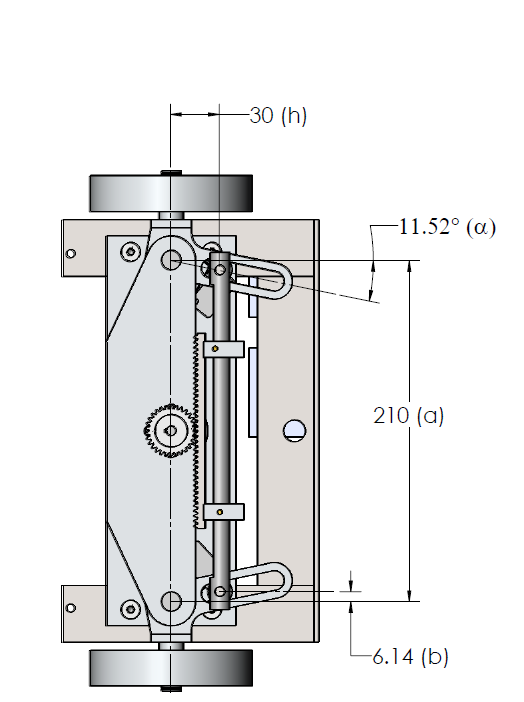
Chapter3/fig/davidGear.png
