amarendas/PhdThesis/Chapter3/fig/magicformula.png

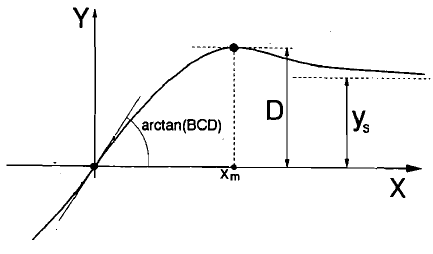
Chapter3/fig/magicformula.png
