amarendas/PhdThesis/Chapter3/fig/Skid.bmp

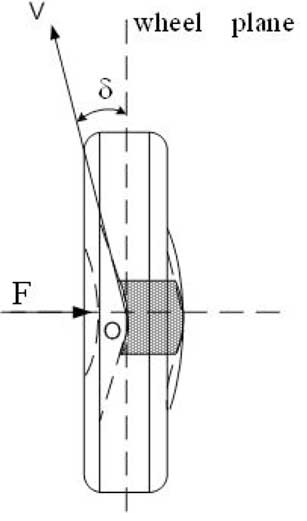
Chapter3/fig/Skid.bmp
