amarendas/PhdThesis/Chapter3/fig/Skid.png

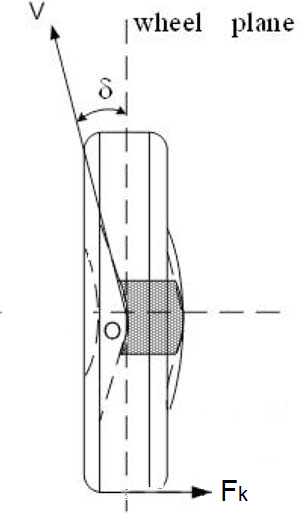
Chapter3/fig/Skid.png
