amarendas/PhdThesis/Chapter3/fig/Slip.png

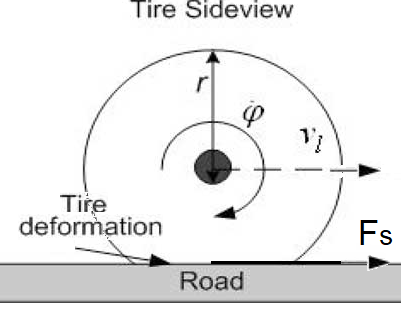
Chapter3/fig/Slip.png
