amarendas/PhdThesis/Chapter3/fig/steer1.png

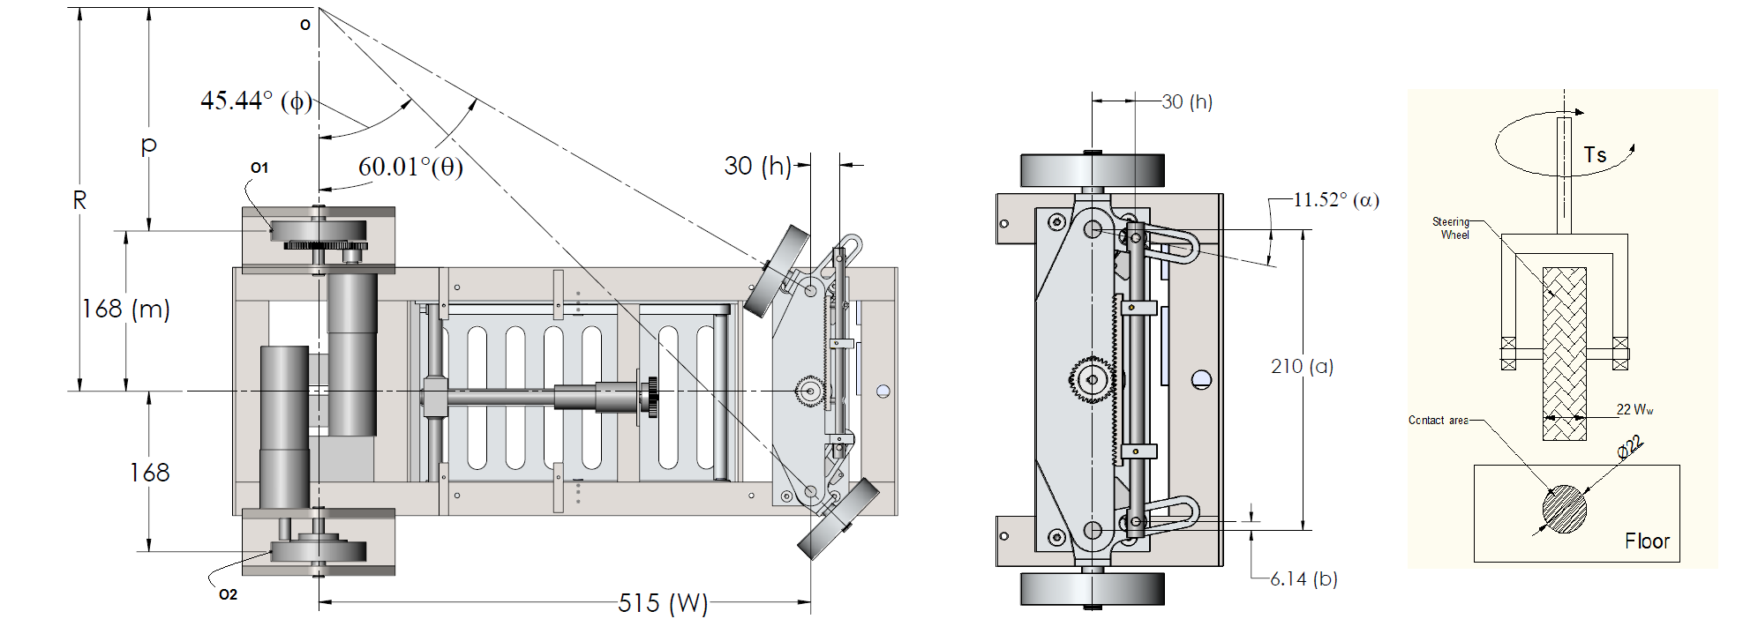
Chapter3/fig/steer1.png
