amarendas/PhdThesis/Chapter3/fig/xxx.png

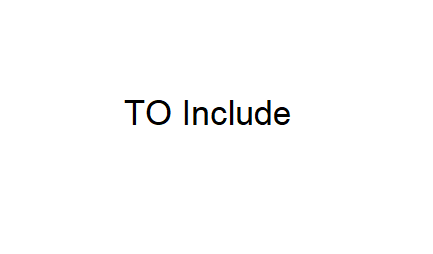
Chapter3/fig/xxx.png
