amarendas/PhdThesis/Chapter4/fig/RoleAngleNoSlip.png

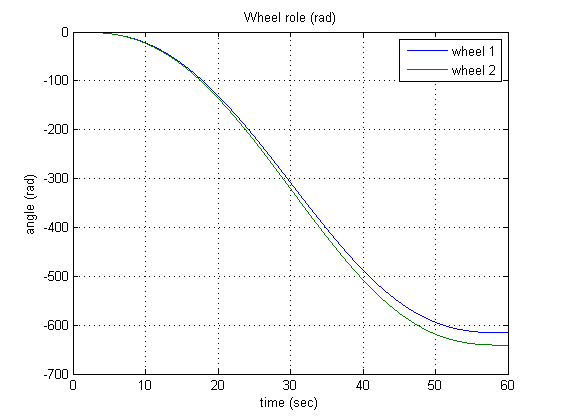
Chapter4/fig/RoleAngleNoSlip.png
