amarendas/PhdThesis/Chapter4/fig/tracedPath mu03.jpg

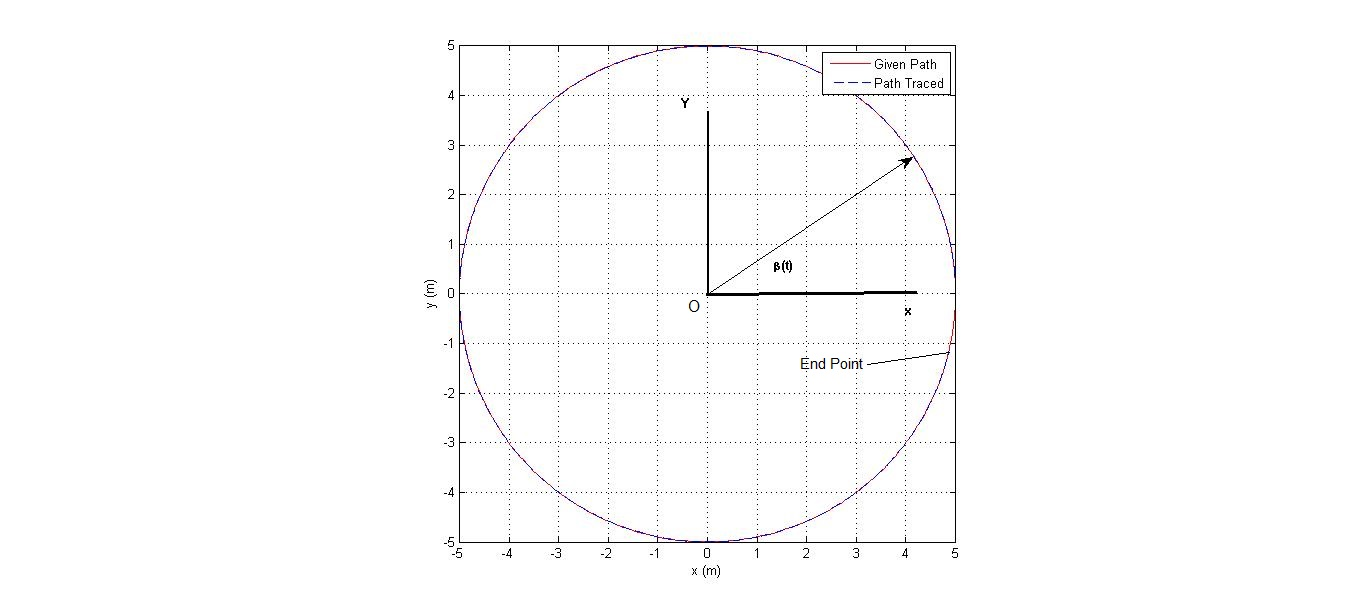
Chapter4/fig/tracedPath mu03.jpg
