amarendas/PhdThesis/Chapter5/fig/BlkDigLocal2.jpg

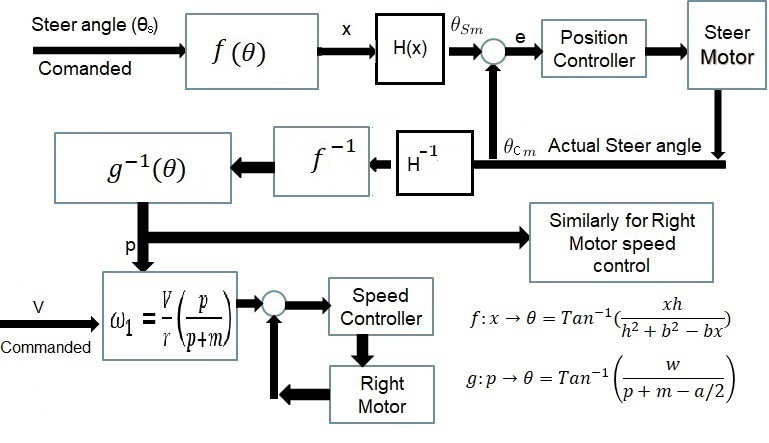
Chapter5/fig/BlkDigLocal2.jpg
