amarendas/PhdThesis/Chapter5/fig/BlkDigLocal.png

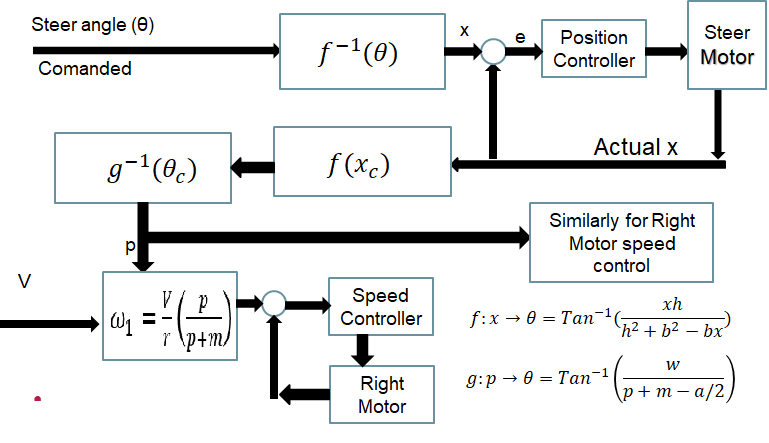
Chapter5/fig/BlkDigLocal.png
