amarendas/PhdThesis/Chapter5/fig/circle.png

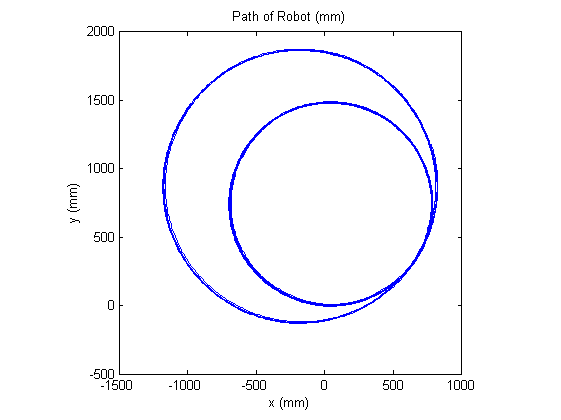
Chapter5/fig/circle.png
