amarendas/PhdThesis/Chapter5/fig/davisgear2.png

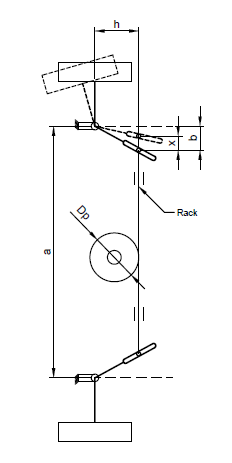
Chapter5/fig/davisgear2.png
