amarendas/PhdThesis/Chapter5/fig/kinvec2.png

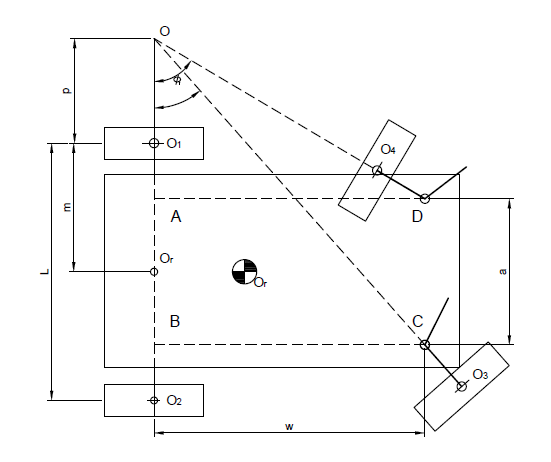
Chapter5/fig/kinvec2.png
