amarendas/PhdThesis/Chapter5/fig/posLoop.jpg

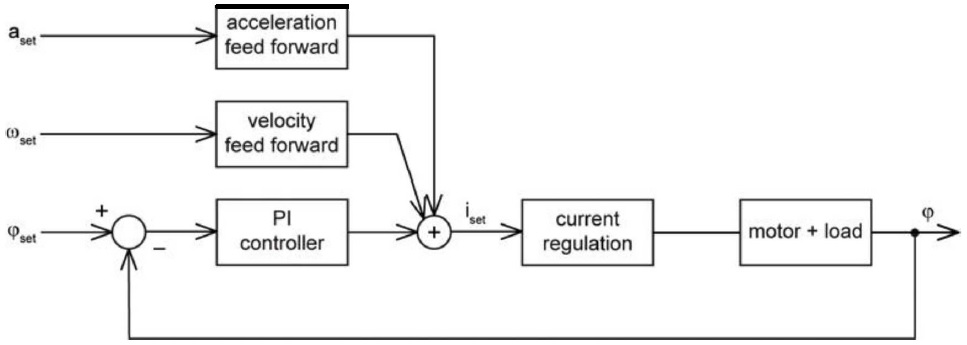
Chapter5/fig/posLoop.jpg
