amarendas/PhdThesis/Chapter5/fig/posLoop.png

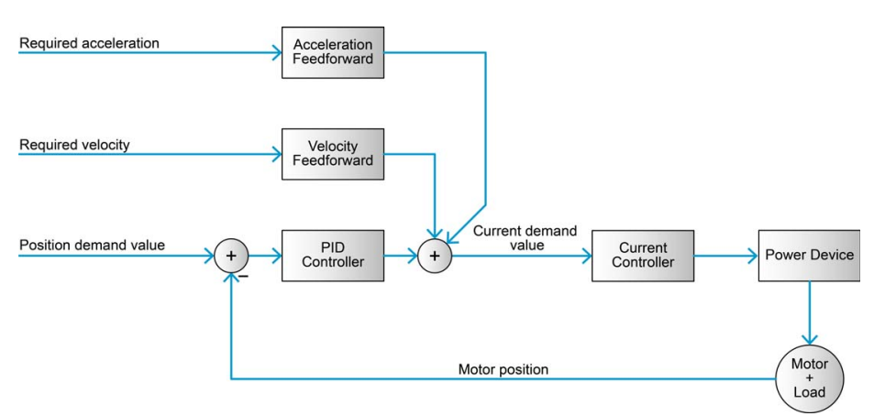
Chapter5/fig/posLoop.png
