amarendas/PhdThesis/Chapter5/fig/RobotKine.png

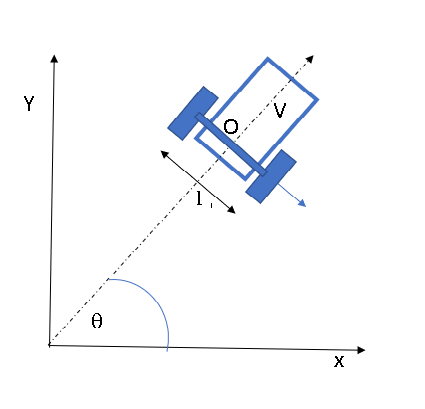
Chapter5/fig/RobotKine.png
