amarendas/PhdThesis/Chapter6/fig/ackerman.png

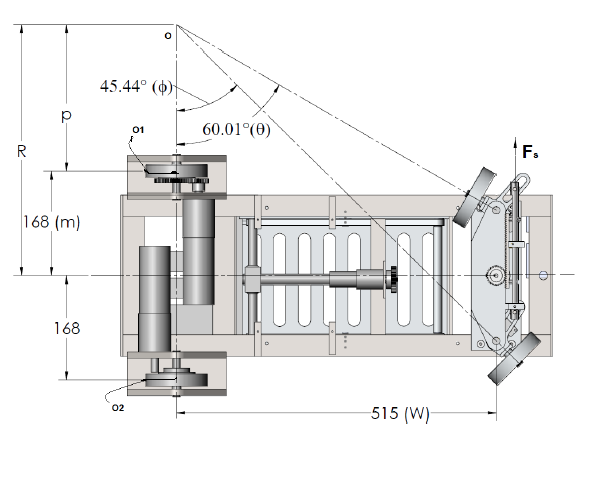
Chapter6/fig/ackerman.png
