amarendas/PhdThesis/Chapter6/fig/compentiate.png

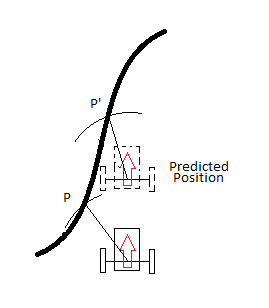
Chapter6/fig/compentiate.png
