amarendas/PhdThesis/Chapter6/fig/Delay200milsec.png

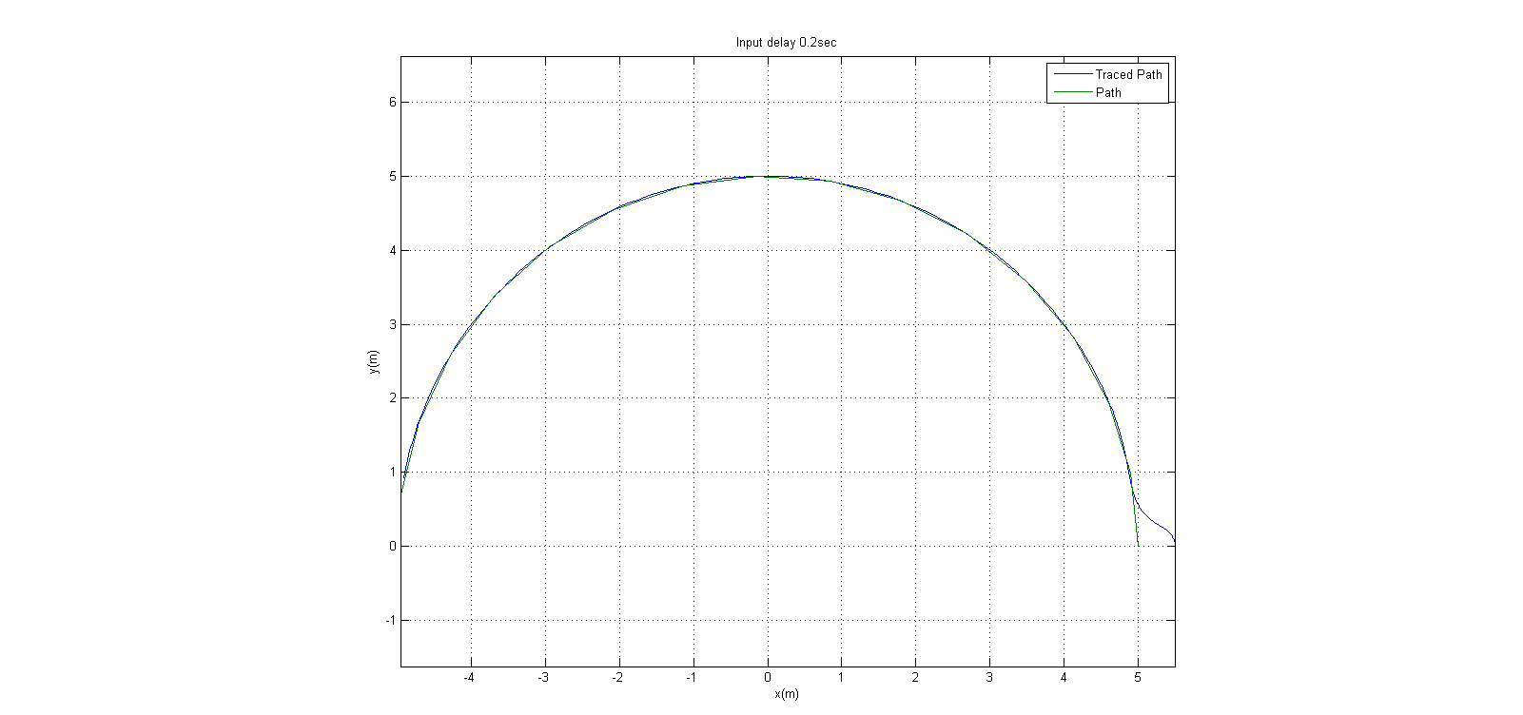
Chapter6/fig/Delay200milsec.png
