amarendas/PhdThesis/Chapter6/fig/IMG_20180409_205839.jpg

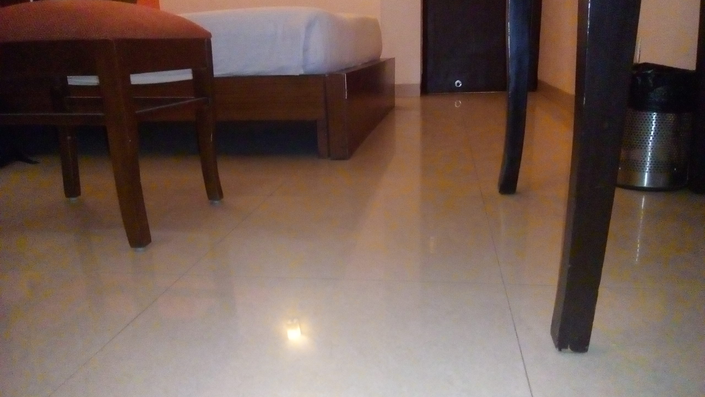
Chapter6/fig/IMG_20180409_205839.jpg
