amarendas/PhdThesis/Chapter6/fig/purepersuit.png

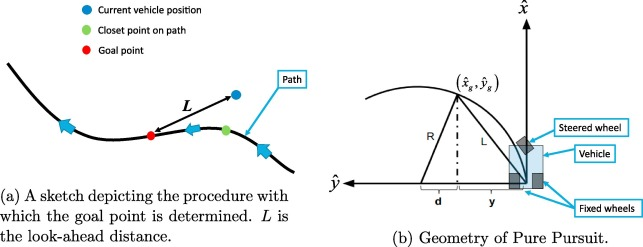
Chapter6/fig/purepersuit.png
