amarendas/PhdThesis/Chapter6/fig/purepesuitgeometry.png

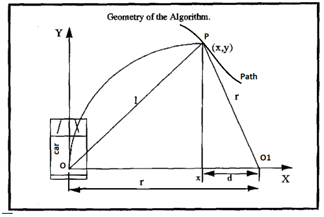
Chapter6/fig/purepesuitgeometry.png
