amarendas/PhdThesis/Chapter6/fig/SteeringAngled.png

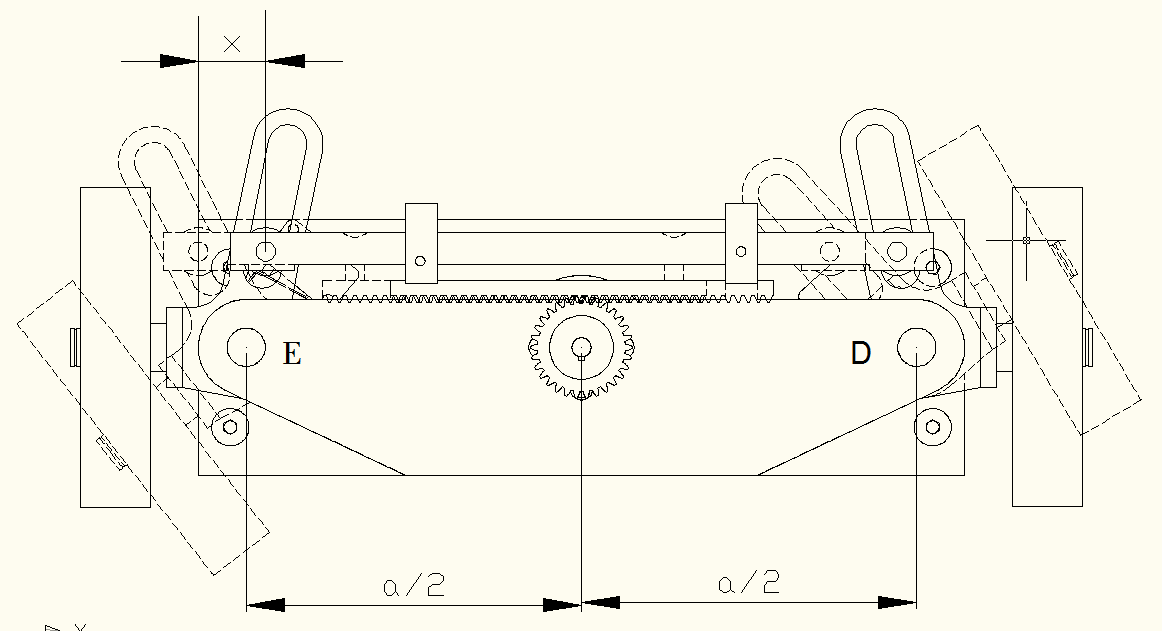
Chapter6/fig/SteeringAngled.png
