amarendas/PhdThesis/Chapter6/fig/teleloop.png

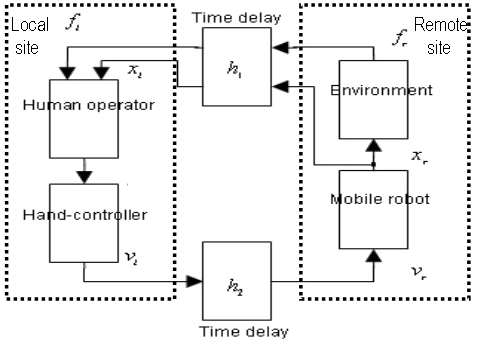
Chapter6/fig/teleloop.png
