amarendas/PhdThesis/Chapter6/fig/vehline.bmp

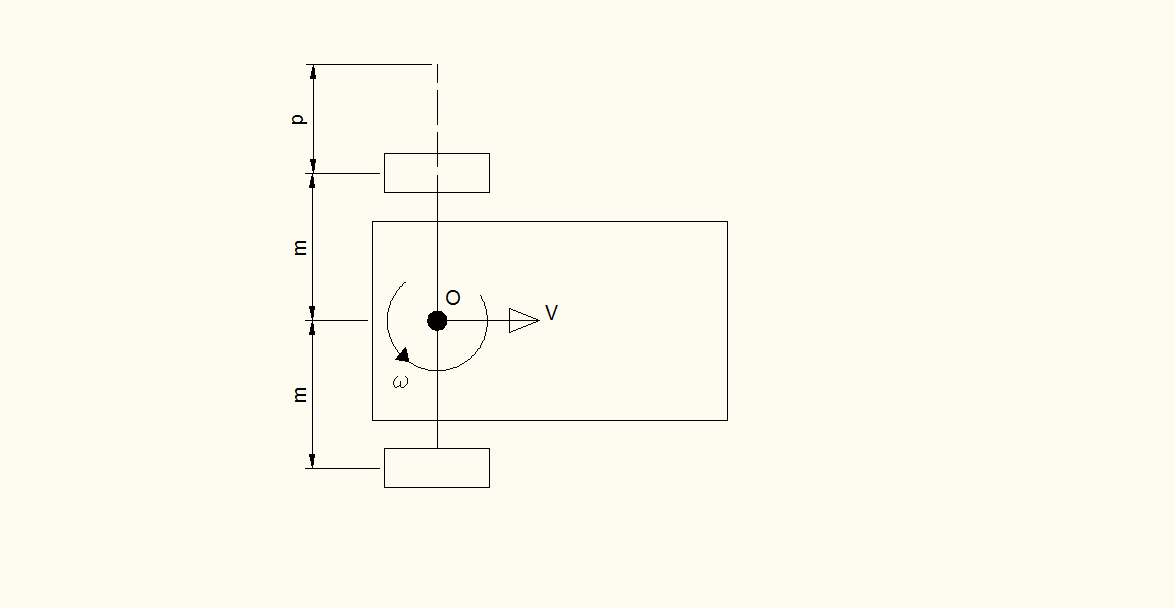
Chapter6/fig/vehline.bmp
