amarendas/PhdThesis/Misc_front/Nomenclature.tex

\section*{\LARGE{Important Symbols and Abbreviations}}
\doublespacing
The important conventions, symbols and abbreviations used in this thesis are listed in the alphabetical order. 
\begin{center}
\begin{longtable}{ll}
	\textbf{Conventions} & \textbf{Description}\\
	\hline
	\endfirsthead
	\multicolumn{2}{r}%
	{\textit{Continued from previous page}} \\
	\hline
	\textbf{Latin letters} & \textbf{Description}\\
	\hline
	\endhead
	\hline \multicolumn{2}{r}{\textit{Continued on next page}} \\
	\endfoot
	\endlastfoot
	$\textit{italic}$ & Scalar quantities in lower-case lightface italic with\\ & Latin/Greek letters\\
	$\textbf{bold}$ & Vectors are in lower-case boldface Latin/Greek letters\\
	$\textbf{{CAPITAL BOLD}}$ & Matrices are in upper-case boldface Latin/Greek letters\\

\end{longtable}
\end{center}

\begin{center}
\begin{longtable}{ll}
	\textbf{Latin letters} & \textbf{Description}\\
	\hline
	\endfirsthead
	\multicolumn{2}{r}%
	{\textit{Continued from previous page}} \\
	\hline
	\textbf{Latin letters} & \textbf{Description}\\
	\hline
	\endhead
	\hline \multicolumn{2}{r}{\textit{Continued on next page}} \\
	\endfoot
	\endlastfoot

$\mathbf{A}_t$ & State transition matrix at time $t$\\
	
$a_i$, $\alpha_i$ $b_i$, $\theta_i$ & Represents four DH parameters namely, Link length, twist angle,\\
&  joint offset and joint angle, respectively.\\

$\mathbf{B}_t$ & Control input matrix at time $t$\\

\textbf{C}, \textbf{C}$_i$ & Matrix of Convective Inertia (MCI) terms associated with \\
&  the  complete system and the $i^{th}$ subsystem, respectively\\

$f_v$ & Viscous friction coefficient at the joint of robotic  manipulator\\

$f_c$ & Coulomb friction coefficient at the joint of robotic  manipulator\\

$\mathbf{x}$, $\hat{\mathbf{x}}_{t|t-1}$ & State vector and its estimate at time $t$ with data upto time $(t-1)$ \\

\textbf{0} & Column vector of zeros or null vector with compatible size \\
& to the dimensions of the matrices and vectors where it appears \\

\textbf{1} & Identity matrix of size compatible to the dimensions of the matrices \\
& where it appears 
\end{longtable}
\end{center}
\begin{center}
\begin{longtable}{ll}
		\textbf{Greek letters} & \textbf{Description}\\
		\hline
		\endfirsthead
		\multicolumn{2}{r}%
		{\textit{Continued from previous page}} \\
		\hline
		\textbf{Greek letters} & \textbf{Description}\\
		\hline
		\endhead
		\hline \multicolumn{2}{r}{\textit{Continued on next page}} \\
		\endfoot
		\endlastfoot
		
$\alpha_i$ & Twist angle of $k^{th}$ link (DH parameter) \\

$\theta_i$, $\dot{\theta}_i$, $\ddot{\theta}_i$  & Relative joint displacement of the $i^{th}$ link, its rate, and \\
& acceleration, respectively, in a closed-loop system \\

$\bm{\uptheta_i}$, $\bm{\dot{\uptheta}}_i$, $\bm{\ddot{\uptheta}}_i$  & Vector of relative joint displacement of the $i^{th}$ link, its rate, and \\
& acceleration, respectively, in a closed-loop system \\

$\boldsymbol{\upchi}_b$ & Vector of base parameters in dynamic model\\

$\bm{\lambda}$ & Lagrange multiplier representing constraint forces \\
%& subsystem, and the complete system\\

$\bm{\upomega}_i$ & The 3-dimensional angular velocity vector of $i^{th}$ link \\

%${\boldsymbol{\upsigma}}$ & Vector of standard deviations \\

%
%$\mathcal{O}(n^k$) & Computational complexity of an algorithm, i.e.,\\
% & order n to the power k  \\
	
\end{longtable}
\end{center}
\begin{center}
\begin{longtable}{ll}
\textbf{Acronyms} & \\
\hline
\endfirsthead
\multicolumn{2}{r}%
{\textit{Continued from previous page}} \\
\hline
\textbf{Acronyms } & \\
\hline
\endhead
\hline \multicolumn{2}{r}{\textit{Continued on next page}} \\
\endfoot
\endlastfoot

AMM & Aruco Marker Map \\

ANOVA  & Analysis of Variance \\

VTM & Velocity Transformation Matrix \\

\end{longtable}
\end{center}
\begin{center}
\begin{longtable}{ll}
\multicolumn{2}{l}{\textbf{Functions/Operators}} \\
\hline
\endfirsthead
\multicolumn{2}{r}%
{\textit{Continued from previous page}} \\
\hline
\multicolumn{2}{l}{\textbf{Functions/Operators}} \\
\hline
\endhead
\hline \multicolumn{2}{r}{\textit{Continued on next page}} \\
\endfoot
\endlastfoot
$\kappa(\mathbf{M})$ & Condition number of matrix $\mathbf{M}$ 
~~~~~~~~~~~~~~~~~~~~~~~~~~~~~~~~~~~~~~~~~~\\

$det(\mathbf{M})$ & Determinant of matrix $\mathbf{M}$ \\

\textit{diag}($\mathbf{v}$) & Element of vector $\mathbf{v}$ at diagonal position of a matrix\\

% $\hat{\centerdot}$ & Estimate of any vector or matrix\\

\end{longtable}
\end{center}
