amarendas/PhdThesis/(list of files, cad)

Other CAD files:
Chapter5/chapt5.dwg
Chapter5/fig/chapt5.dwg
Chapter6/fig/purepersuit.dwg
vehicle.dwg
force overturn_recover.dwg
force overturn.dwg
