amarendas/PhdThesis/Chapter6/fig/Sterering Assembly for paper.bmp

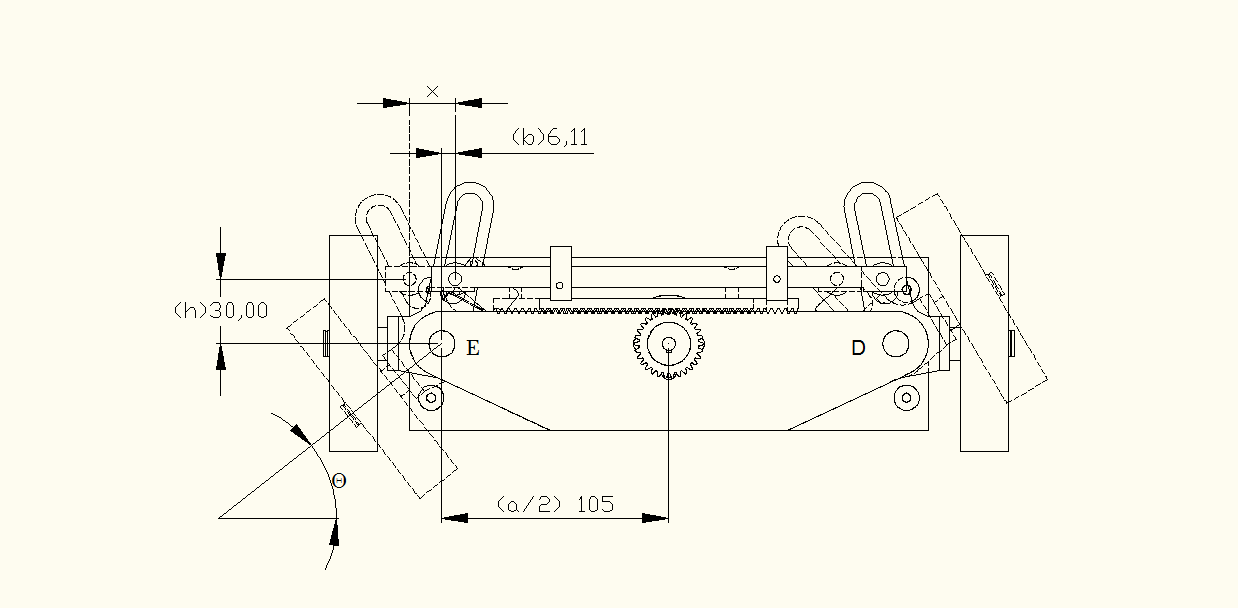
Chapter6/fig/Sterering Assembly for paper.bmp
