amarendas/PhdThesis/Chapter7/fig/resultsPP.jpg

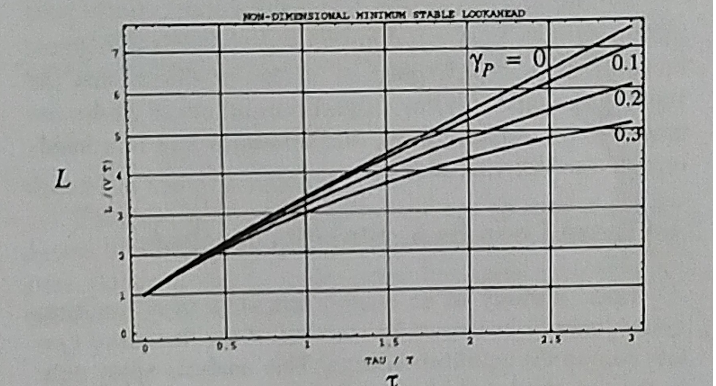
Chapter7/fig/resultsPP.jpg
