amarendas/PhdThesis/Misc_end/fig/delayMeasureNew.jpg

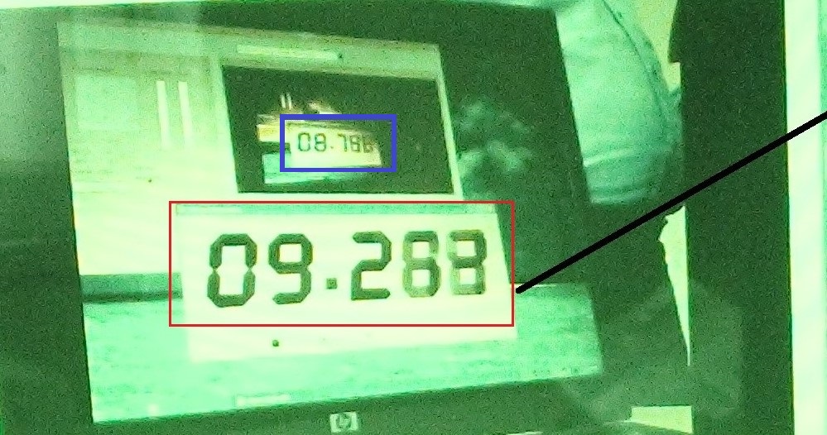
Misc_end/fig/delayMeasureNew.jpg
