amarendas/PhdThesis/Chapter6/fig/purepersuit.pdf

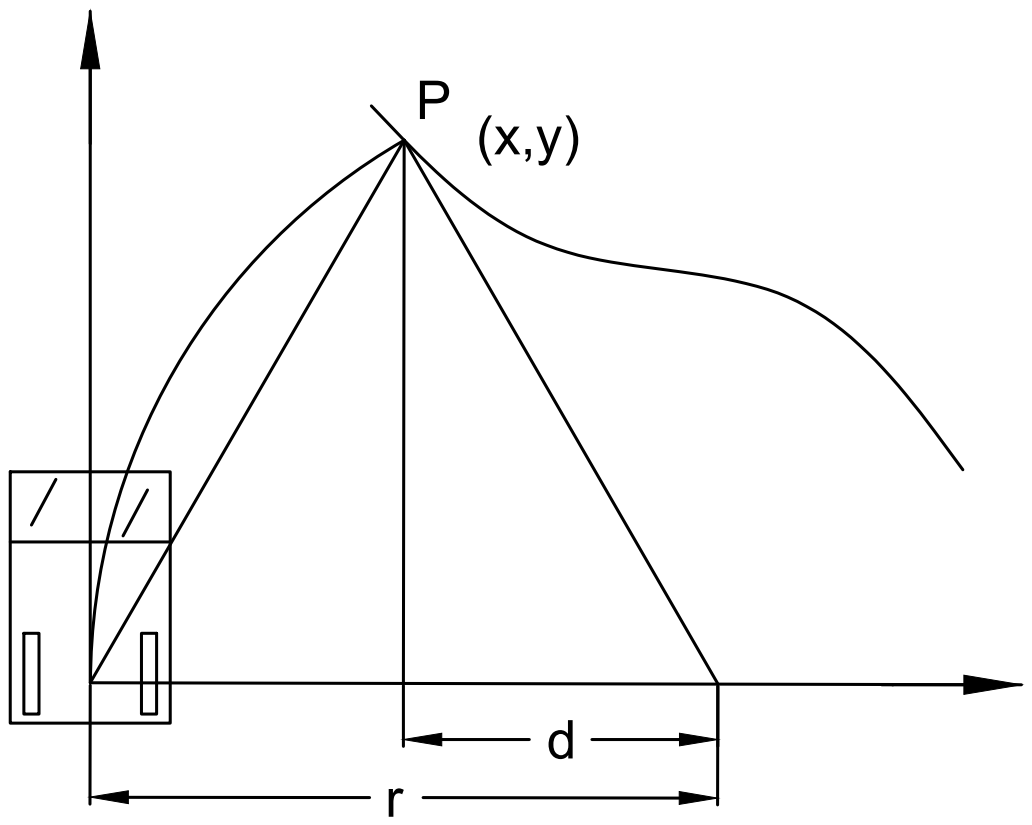
[picture p136: page 1]
