amarendas/PhdThesis/(commit log)

2018-10-14 chapter 5 started
    [chapt5.dwg]
2018-11-21 Chapter 5 Correction Included -Figs
    [chapt5.dwg]
2018-11-25 Chapter 6 Simulation Corrected
    [chapt5.dwg, purepersuit.dwg]
2018-12-10 extended steering kinetics
2018-12-10 Extended Modeling Steering
2019-09-10 added wheel 4 and 5 T and dT
2019-09-10 Slip force calculated
    [Vehicle.dwg, stabilityFig.dwg]
2019-09-17 code folder removed
    [Vehicle.dwg, stabilityFig.dwg]
2020-01-08 Second reviewer comments included
    [force overturn.dwg, force overturn_recover.dwg, vehicle.dwg]
